Oh-V1G0-Rally/Omnicar_Control_Ros2/[00] Documentation/Thesis_Alessandro/Frontespizio_TM.pdf

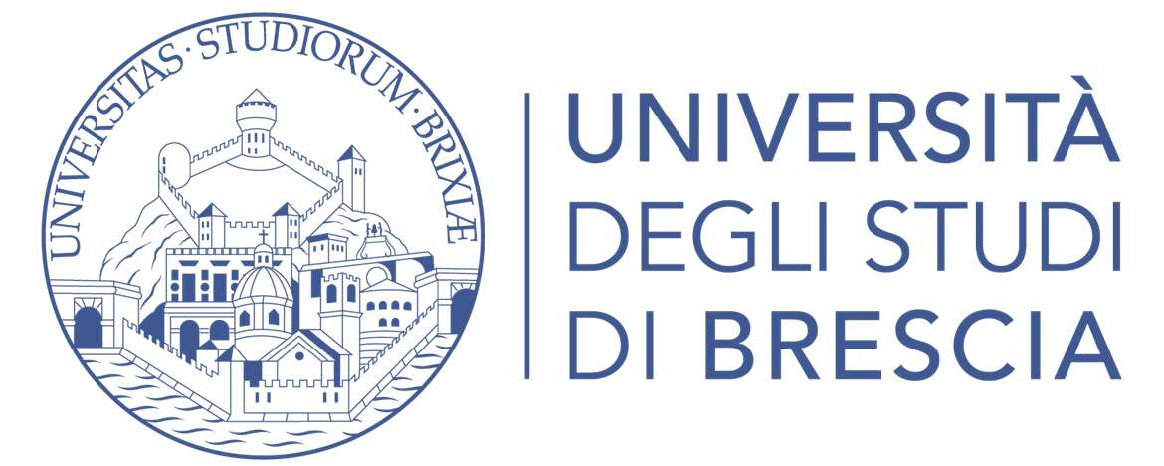
[picture p52: figure]

DIPARTIMENTO DI INGEGNERIA MECCANICA E INDUSTRIALE CORSO DI LAUREA IN INGEGNERIA DELL’AUTOMAZIONE INDUSTRIALE

## Assembly, Design and Implementation of Nonlinear Motion Control Algorithms for a Robotic Car

Relatore:
Antonio Visioli

Laureando:
Alessandro Vigorelli Matr. 735847

ANNO ACCADEMICO 2025-2026
