Oh-V1G0-Rally/Omnicar_Control_Ros2/[00] Documentation/MR_Assignment3-1.pdf

# Mobile Robotics - Assignment 3

Jo˜ao Martins, Jos´e Carvalho, Louren¸co Pinho and Maria Lopes

Once the low-level controller is complete, mobile robots can be deployed to perform various tasks that require planar movement. In such scenarios, a high-level controller is essential for planning and executing the robot’s path. This assignment presents the formulation of multiple controllers designed for different types of common movements, such as following linear trajectories and curves. Additionally, an infrared sensor has been integrated into the system to enable a trajectory-following feature.

## 1 Kinodynamic Model

The robot used in this work will be a differential wheeled robot with two actuators in the form of motors. A typical example of such a robot can be visualized in Figure 1.

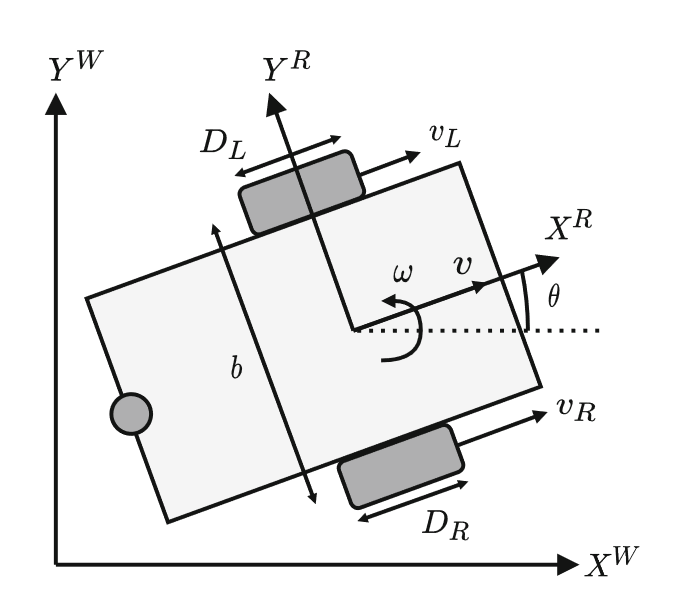
[picture p72: figure]

Figure 1: Example of Differential Wheeled Robot

The robot kinematics are nonlinear and have non-holonomic motion constraints, meaning that the 3 degrees of freedom (x, y, θ) are not decoupled from one another. The forward kinematics can be written as:

x˙
y˙
˙θ
- =

cos θ 0
sin θ | 0
0 | 1
| | {z | }
| J
v
ω
(1)

where v is the linear velocity on the robot’s inertial frame, and ω is its angular velocity. These velocities can be related to the velocity of each wheel through the following equation:
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
| {z }
W
v
ω
(2)

in which b is the robot’s width, vL, and vR are the velocities of the left and right wheels, respectively. The wheels’ angular speeds are calculated using the relation with the wheel radius r:

ωw =

v
r

(3)

and the subscript w will be used whenever referring to a generic wheel.
Considering that the motors operate outside their deadzone, the dynamical model can be approxi-mated as a linear model with two poles. After performing system identification on the system, it was concluded that the pole associated with the electrical current is much smaller than the mechanical pole, and therefore, to simplify the model, it will be ignored. Thus, the motors will be described by a first-order model with the following transfer function on the Laplace domain:

G(s) = W(s)
U(s)

=

A
τs + 1
, | (4)

where A is the transfer function gain, τ is the system’s open-loop time constant, and U(s) is the voltage signal or the control variable.
The goal of a generic closed-loop controller H(s) will be to make it so that the system tracks the reference signal R(s). In this section, we will simplify the controller synthesis by considering a generic controller that imposes the closed-loop dynamics described by:

1
τ

′s + 1

, | (5)

Which is a unitary-gain first-order system with a time constant τ

′
. Considering that there is no wheel slippage or actuator saturation, robot velocities v, ω also follow the closed-loop dynamics of Equation 5, and thus the model can be extended as:

x˙
y˙
˙θ
v˙
ω˙

=

0 0 0 cos θ | 0
0 0 0 | 0 | sin θ
0 0 0 | 0 | 1
0 0 0 | −1 τ
| ′ | 0
0 0 0 | 0 | −1 τ ′

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
′ | 0
0

1
τ

′

# vref

ωref
, | (6)

where vref , ωref are the reference velocity values that are given to the low-level controller. From these reference velocities, the individual wheel speeds can be computed by equation Equation 2. This model allows us to consider the wheel acceleration dynamics instead of just the kinematic constraints.

In this document, the design control architecture for the motion control of the robot will be explored. The control system was divided into two main blocks: a low-level and a high-level controller. The high-level block will be responsible for the path following control by receiving the robot’s pose and orientation and computing reference velocities handled by the low-level controller. This framework can be visualized in Figure 2. It is important to note that the low-level controller and the state estimation were already addressed in previous reports. Therefore, the main focus will be on the high-level controller block, which will have multiple types of movements defined, all described in the sections below.

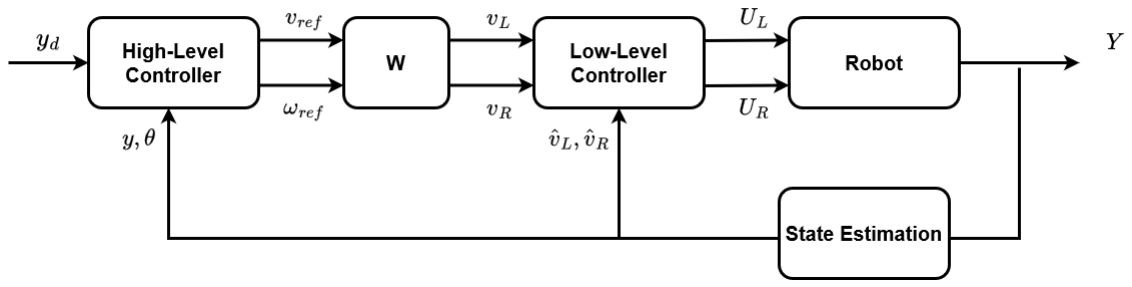
[picture p73: figure]

Figure 2: Proposed Controller Architecture.

## 2 SetTheta

Consider a robot described by the given forward kinematics. Let θ(t) be the robot’s orientation and θd ∈ [−

π
2

,

π
2

] be a given desired orientation as represented in Figure 3. Design a feedback control law such that all the relevant closed-loop signals are bounded, and the regulation error (θ − θd) = ˜θ converges to zero as t → ∞.

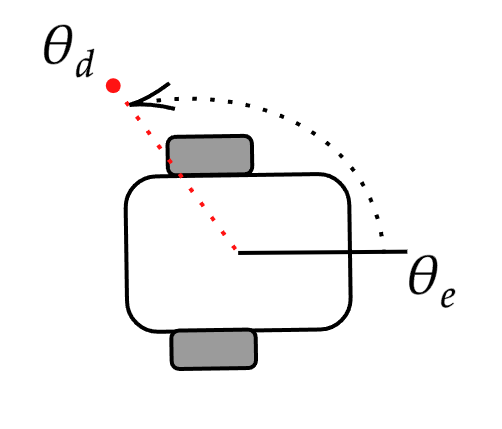
[picture p74: figure]

Figure 3: Set theta diagram

Since this is an orientation problem, the desired linear velocity, vd, is defined as:

vd = 0

Then the desired angular velocity ωd is computed by the control law:

ωd =

ωnomsgn(˜θ) if |

˜θ| >
π
2

ωnom ·

˜θ ·

2
π

if |

˜θ| <
π
2
Where the sgn operator enables the controller to move in the direction of the smallest rotation. Additionally, if |

˜θ| < 0.01:
ωd = 0

end traj = true

## 3 GotoXY

Consider a robot described by the given forward kinematics. Let p(t) be the robot’s pose and pd ∈ R

2
,
defined by pd =(xd, yd), be a given desired point as illustrated in Figure 4. Design a feedback control law such that all the relevant closed-loop signals are bounded, and the regulation error ∥p(t)−pd∥ = ˜p converges to zero as t → ∞.
In this scenario, the following relations can be retrieved:

θd = atan2(yd − ye, xd − xe) ˜θ = θd − θe

p˜ = ∥p(t) − pd∥ =

p
(xe − xd)

2 + (ye − yd)

2
where ˜p is the pose error and ˜θ is the orientation error. Then the desired angular velocity ωd is computed as:
ωd = kθ

˜θ

The desired linear velocity vd based on the following conditions:

vd =

(
0 | if |

˜θ| >
π
2
vnom · cos(˜θ) · min (1, kpp˜) if |

˜θ| ≤ π

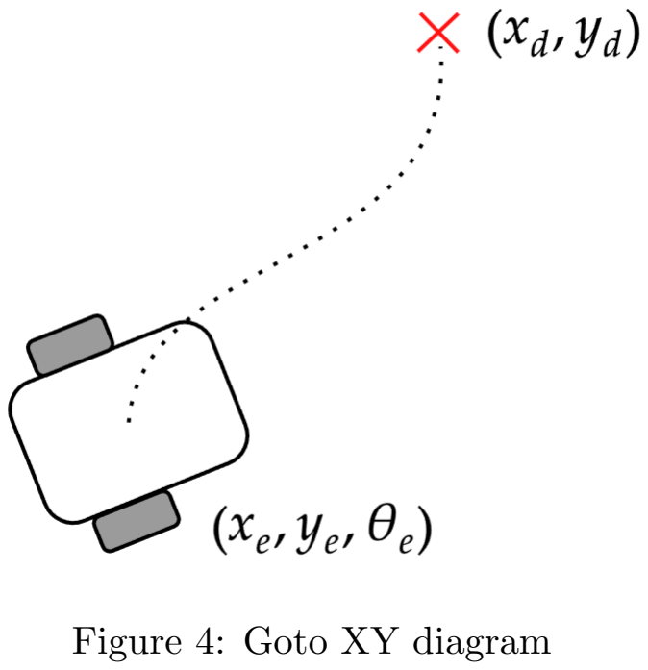
[picture p75: figure]
Figure 4: Goto XY diagram

Here, the cos(˜θ) term enables the robot to regulate its linear velocity if the angular error is large and the min(1, kpp˜) switches between applying the nominal velocity or implementing a proportional controller if the error is small enough. This effectively serves to give the robot a smoother deceleration. Additionally, if |p˜| < 0.01:
vd = 0

ωd = 0

end traj = true

With kθ and kp being the proportional gains defined as follows:

kθ =

ωnom

π
2

, kp =

1
λ

, λ = 0.2

## 4 Follow Line

Consider the line segment that begins at the point (xi

, yi) and ends at (xf , yf ) ∈ R

2
. Then, let this
path be parameterized by the function γ(p(t)) : R

2 → R

2
, which, given the robot’s pose, returns the point (xl

, yl) in the path at the smallest euclidean distance, ˜l, as represented in Figure 5. Thus, the goal is to formulate a closed-loop control law so that all signals are bounded and the regulation error ∥p(t) − γ(p(t))∥ tends to zero as t → ∞.

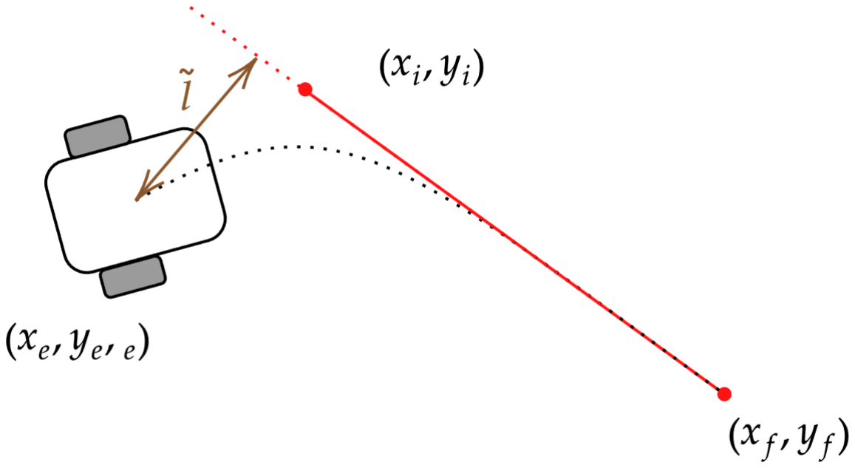
[picture p76: figure]

Figure 5: Follow line diagram

In this case, the relations retrieved are the following:

θd = atan2(yf − ye, xf − xe)

˜θ = θd − θe

p˜ =

q
(xe − xf )

2 + (ye − yf )

The error to the line, ˜l, can be computed with:
(
ux =

xf −xi
||xf −xi||2
uy =

yf −yi
||yf −yi||2
(
vx = xe − xi
vy = ye − yi

˜l = vx · uy − vy · ux

Let ˜l be the distance from the robot’s pose p(t) to the line segment, ˜θ = (θd − θ) be the orientation error and ky, kθ be two proportional gains. Then, one can derive a control law for the orientation that will drive the robot to follow the line:

ωd = ky

˜l + kθ
˜θ

Finally, consider the pose error defined as ˜p(t) = ∥p(t) − (xf , yf )∥ the distance from the robot’s pose to the end of the line, and kp a proportional gain. Thus, we can determine the desired linear velocity vd based on the following control law:

vd =

(
0 | if |

˜θ| >
π
2
vnom · cos(˜θ) · min (1, kpp˜) if |

˜θ| ≤ π
2
Additionally, if |p˜| < 0.01: vd = 0
ωd = 0
end traj = true

### 4.1 Adaptative Gains

Consider the dynamic model presented by the forward kinematics given by equation Equation 1. We are interested in following only straight lines, which, without loss of generality, can be described as the line y = 0 in an arbitrary reference frame. Thus, since the problem is path-following and not trajectory tracking, the state x can be ignored as we are only concerned with following the geometric path. Furthermore, due to y = 0, the orientation of the line is also θ = 0, and as such, our model can be linearized via small angle approximation:
y˙
˙θ
=
0 v(t)
0 | 0
| | {z | }
| A
y
θ
+
0
1

|{z}
B
ω | (7)

where we consider that the velocity v is not a control variable and instead is a time-varying parameter of the model. Then, we can derive a full-state feedback controller:
y˙
˙θ
=
0 v(t)

0 0 y θ

−
0
1

ky kθ

y
θ
(8)

which results in the closed-loop eigenvalues being computed as:

0 | v(t)
−ky | −kθ

= s

2 + skθ + kyv(t) = 0 ↔

s =

−kθ ±

p
k

2
θ − 4kyv(t)
2

(9)

and we will choose to have the imaginary part to be equal to zero, resulting in the expression for ky being:

ky =

k

2
θ
4v(t)

(10)

where the value of the real part is equal to −kθ , and as such we choose where to place the pole.

## 5 Follow Circle

Consider the circle that begins is centered at the point (cx, cy) and has a radius r. Then, let this path be parameterized by the function γ(p(t)) : R

2 → R

2
, which given the robot’s pose, returns the point (xc, yc) in the path at the smallest euclidean distance. Thus, the goal is to formulate a closed-loop control law so that all signals are bounded and the regulation error ∥p(t) − γ(p(t))∥ tends to zero as t → ∞. This problem is illustrated in Figure 6.

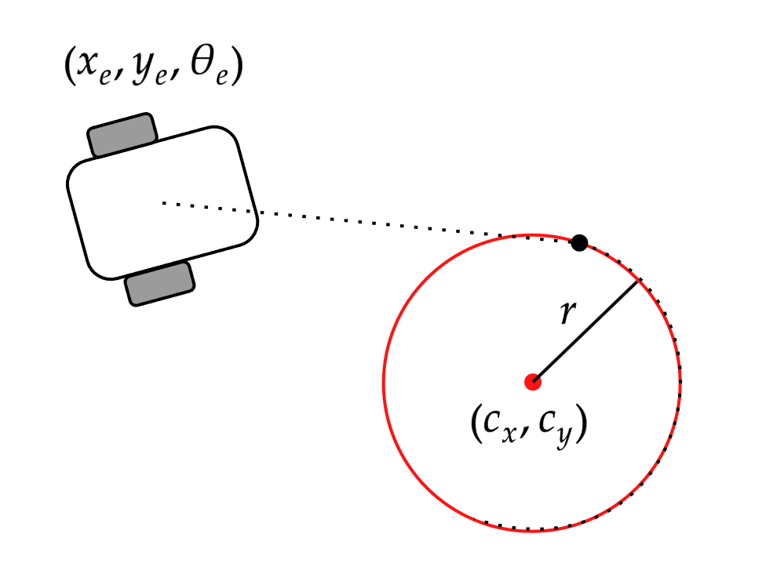
[picture p77: figure]

Figure 6: Follow circle diagram

Three distinct phases were used to solve the follow circle controller problem. The first one is a calculation of the best point to enter the circle; the second is the approximation to it using the GotoXY controller, where the robot converges to a point for better entering the circle without having to stop and rotate due to the differential wheel drive configuration. Then, upon being close enough, it enters the third and final phase of following the circle. This procedure is illustrated in Figure 7, along with the equations used to calculate the references in each phase.

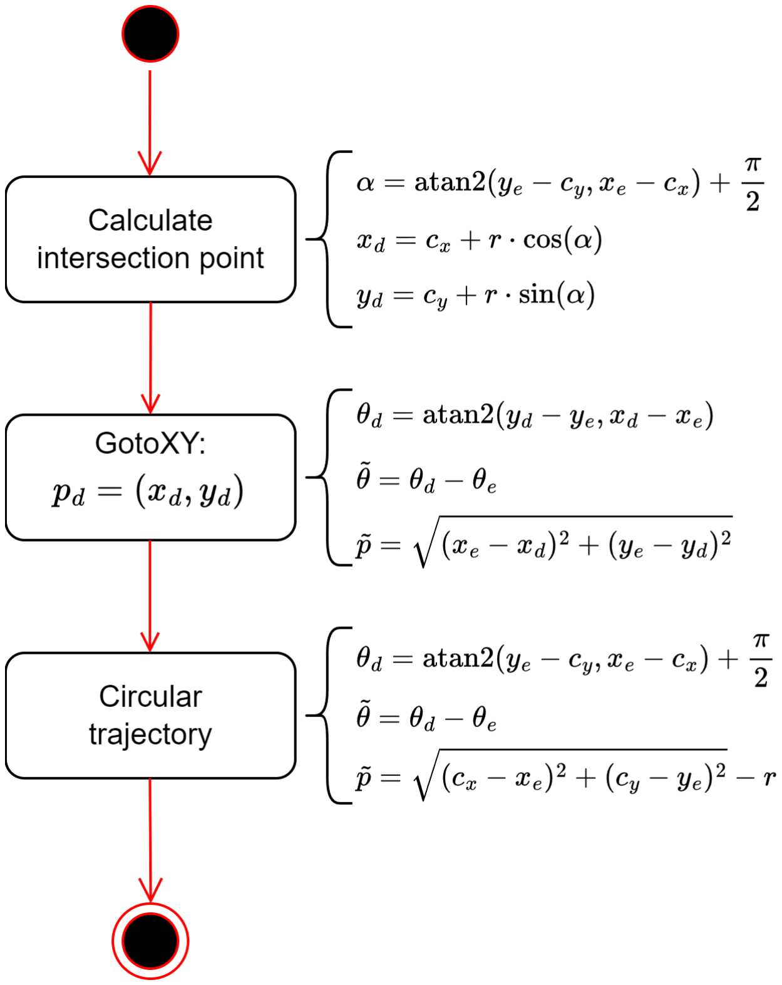
[picture p78: figure]

Figure 7: Follow circle state machine

Remember the proposed follow-line controller. If we consider that ˜c = ∥p(t)−γ(p(t))∥ is an error in the form of the distance from the robot’s pose to the closest point in the circle and θd is the orientation of the line tangent to that point; then the proposed line controller will follow the circle path with the caveat of existence of a steady-state error due to ˙θd ̸= 0. This can be mitigated by adding a feedforward term to the controller:

ωd = kcc˜+ kθ

˜θ +

vd
r
Where vd can be calculated the same way as in the line following case. For a continuous follow circle case, vd is defined as vnom.

## 6 Path Follower using IR Sensor

Consider the robot described by the given forward kinematics. Let it travel at a constant linear velocity vd, and let β˜ ∈ R be the displacement of the front robot in relation to the desired path. Design a feedback control law such that all relevant closed-loop signals are bounded and the regulation error β˜ converges to zero as t → ∞.
Remember the proposed controller, GotoXY. For the case where IR sensors are used, a simpler version can be implemented:

vd = vnom
wd = kββ˜

where kβ is a constant that relates the raw measurements from the IR sensors and the angular error, and β˜ = k ·

˜θ as the IR sensors do not provide the angle error directly. β˜ can be calculated from the IR raw values as follows:

β˜ =

4 · IR4 + 2 · IR3 − 2 · IR1 − 4 · IR0 1024

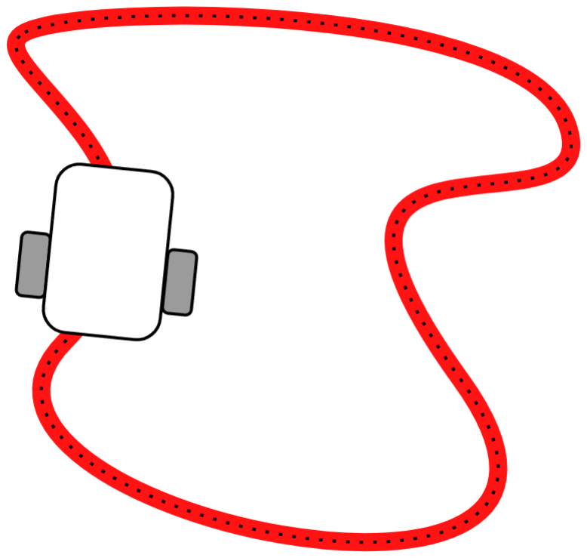
[picture p79: figure]

Figure 8: Path following diagram

## 7 Conclusions

The main conclusions of this work and the Mobile Robotics course from PDEEC are implementing a full framework from the low level to the higher level control of a differential kinematics robot. In previous reports, we explained the motor control and determined the intrinsic parameters. This one focused instead on the higher-level trajectories, from a simple setTheta controller to GotoXY, FollowLine, and FollowCircle.
