Oh-V1G0-Rally/Omnicar_Control_Ros2/[00] Documentation/Nonlinear_Control___PDEEC-2.pdf

# Controller Synthesis for High-Speed Differential Wheeled Robot

1

st Jose Pedro Carvalho ´
Department of Electrical and Computer Engineering Faculdade de Engenharia da Universidade do Porto Porto, Portugal
jpcarvalho@fe.up.pt

2

nd Antonio Pedro Aguiar ´
Department of Electrical and Computer Engineering Faculdade de Engenharia da Universidade do Porto Porto, Portugal
pedro.aguiar@fe.up.pt

Abstract—This document is the final report of the Non Linear Control Course at PDEEC.

I. INTRODUCTION
The rest of the document is structured as follows: Section II formulates the path following problem and derives two kinodymic models for the differential wheeled robot. Section III explores the design and synthesis of Proportinal Integral and Derivative (PID) and Model Reference Adpative Control (MRAC) controllers for the wheel’s velocity. Subsquently Section IV formulates four different path-following controllers based on: Linear Quadratic Regulator, Sliding Mode Control, Non Linear Control, Proximal Policy Optimization, giving design choices for each of the approach. This is followed by Section V with the results of both the low-level controller and the high-level controller and finally in Section VI the main conclusions and future work are presented.

II. PROBLEM FORMULATION
In this section, we will formulate the class of path-following problems that will be considered in this paper. First, we will consider a framework where a mobile robot is modeled by a continuous-time dynamical system of the form:

x˙(t) = f(x(t), u(t)), x(0) = x0 y(t) = h(x(t)),

(1)

where the vector x(t) ∈ R

n denotes the state, x0 the initial condition, u(t) ∈ R

n the input control signal, and y(t) ∈ R

q
the output signal that will typically correspond to the robot’s pose in respect to an inertial coordinate frame.
We are interested in the class of problems where a robot described by the system in equation (1) must follow a geometric path yd(γ) : R → R

q parameterized by γ ∈ R and vd ∈ R is the desired speed assignment. As such, the goal of the path-following problem is to design a feedback control law such that all relevant closed-loop signals are bounded and the path-following error ∥y(t) − yd(γ(t))∥ converges to zero as t → ∞, and the parameter γ satisfies the speed assignment γ˙ → vd as t → ∞.
In this document, we will address only the case where the path is a straight line, and as such, γ(t) = ¯x(t), ∀t, where x¯

Identify applicable funding agency here. If none, delete this.

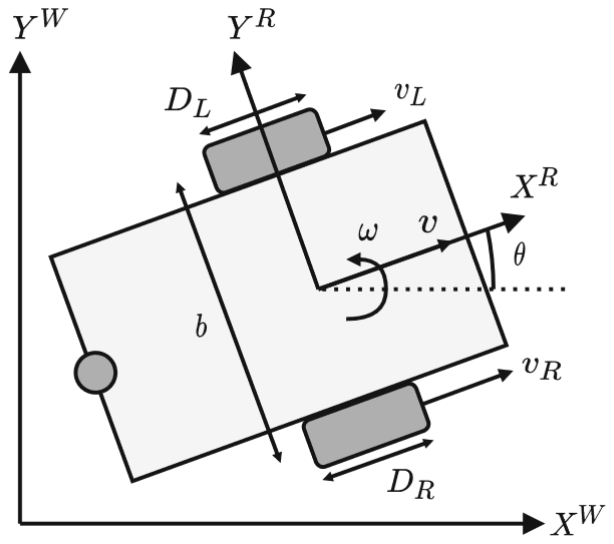
[picture p80: figure]

Fig. 1: Example of Differential Wheeled Robot [?]

is the x coordinate of the robot on the global frame, and thus yd(¯x(t)) = [¯x, 0]T
, meaning that the robot will always follow the line corresponding to the x-axis y = 0.
A. Robot Kinodynamic Model

The robot used in this work will be a differential wheeled robot with two actuators in the form of motors. A typical example of such a robot can be visualized in Figure 1.
The robot kinematics are nonlinear and have non-holonomic motion constraints, meaning that the 3 degrees of freedom (x, y, θ) are not decoupled from one another. The forward kinematics can be written as:

x˙
y˙
˙θ
- =

cos θ 0
sin θ | 0
0 | 1
| | {z | }
| J
v
ω
(2)

where v is the linear velocity on the robot inertial frame, and ω is its angular velocity. These velocities can be related to the wheel velocities through the inverse kinematics:
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
| {z }
W
v
ω
(3)

in which b is the robots’ width, vL, and vR are the velocities of the left and right wheels, respectively. The wheels’ angular speeds are calculated by the relation with the wheel radius r:

ωw =

v
r
, | (4)

and the subscript w will be used whenever referring to a generic wheel. Considering that the motors operate outside their deadzone, the dynamical model can be approximated as a linear model with two poles. After performing system identification on the system, it was concluded that the pole associated with the electrical current is much smaller than the mechanical pole, and therefore, to simplify the model, it will be ignored. Thus, the motors will be described by a first-order model with the following transfer function on the Laplace domain:
G(s) = W(s)
U(s)

=

A
τs + 1
, | (5)

where A is the transfer function gain, τ is the system’s openloop time constant and U(s) is the voltage signal, or the control variable.
The goal of a generic closed-loop controller H(s) will be to make it so that the system tracks the reference signal R(s). In this section, we will simplify the controller synthesis by considering a generic controller that imposes the closed-loop dynamics described by:
1
τ

′s + 1

, | (6)

Which is a unitary-gain first-order system with a time constant τ

′
. Considering that there is no wheel slippage or actuator saturation, robot velocities v, ω also follow the closed-loop dynamics of equation (6), and thus the model can be extended as:

x˙
y˙
˙θ
v˙
ω˙

=

0 0 0 cos θ | 0
0 0 0 | 0 | sin θ
0 0 0 | 0 | 1
0 0 0 | −1 τ
| ′ | 0
0 0 0 | 0 | −1 τ ′

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
′ | 0
0

1
τ

′

# vref

ωref
,

(7)
where vref , ωref are the reference velocity values that are given to the lower-level control. From these reference velocities, the individual wheel speeds can be computed by equation (3). This model allows us to consider the wheel acceleration dynamics instead of just the kinematic constraints.

III. CONTROL SYSTEM DESIGN
In this section, we will explore the design control architecture for the motion control of the robot. In this paper, we will divide the control system into two main blocks: a low-level and a high-level controller. The high-level block will

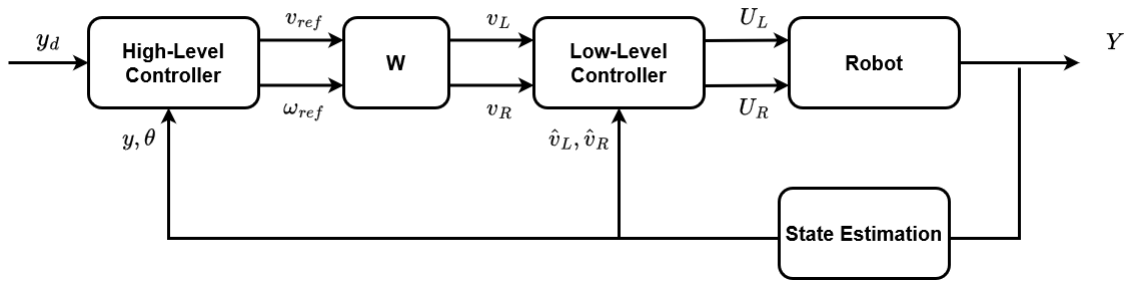
[picture p81: figure]

Fig. 2: Proposed Controller Architecture.

be responsible for the path following control by receiving the robot’s pose and orientation and computing reference velocities handled by the low-level controller. This framework can be visualized in Figure 2.

A. Low-Level Controller

The low-level controller is responsible for controlling the wheel velocities so that the robot can achieve its desired speed.
1) Proportional Integral Controller: Consider the openloop plant given by equation (5) and the let controller H(s) be a PI controller described by equation:

H(s) = kc

1 +

1
sTi
= kc

Tis + 1
sTi
, | (8)

where kc is the proportional gain and Ti
is the integral time
constant. The first design choice of the controller is to choose Ti = τ , making the zero of the controller cancel the pole of the plant:

G(s)H(s) = kc

✘sT✘✘i + 1
sTi

A
✘τs✘+ 1✘ =

kcA
sτ
. | (9)

Therefore, the closed-loop transfer can be derived as:

G(s)H(s)
1 + G(s)H(s)

=

1
s

τ
kcA + 1

(10)

This results once again in a first-order system, this time with unitary gain, as the system tracks any input. The only remaining parameter to choose is the closed-loop time constant τ

′
, as this value will dictate how fast the control system can respond to changes in the reference signal. Then, the time constant of the closed-loop system is equal to:

τ

′ =

τ
kcA
, | (11)

thus, the controller can be adequately tuned. Additionally, we can add a Feedforward signal F(s) to the controller by inverting the plant:

F(s) = 1
G(s)

=

1
A

+

sτ
A
= kf + kds | (12)

and we will consider kd to be equal to zero to keep the transfer function proper, and kf will be λ

1
A where λ ∈ [0, 1].

2) Model Reference Adaptive Controller: : Consider now that the motor model has parametric uncertainty and is described by the differential equation:
x˙ = ax + b(u − f(x)) | (13)

where a, b are unknown parameters and f(x) is an uncertain nonlinear function

f(x) = θ

T ϕ(x), | (14)

with θ = [θ1, θ2]

T being a vector of unknown parameters and ϕ(x) = [1, ω²
w]

T
a vector of known basis function. The goal of the Model Reference Adaptive Controller (MRAC) is to make the system described by equation (13) track a reference model given by:
x˙ m = amxm + bmr | (15)

such that the tracking error e(t) = x(t)−xm(t) = 0 as t → ∞. To this end, let the control law be:

u = ˆkxx + ˆkrr + ˆθ
T ϕ(x), | (16)

and the adaptive law be:
˙ˆkx = −eγxsgn(b)
˙ˆkr = −eγrsgn(b) ˙ˆθ = −eΓθsgn(b) | (17)

that will update the parameters ˆkx,

ˆkr,

ˆθ such that the closed-loop dynamics:

x˙ = (a + b

ˆkx)x + b(
ˆkrr + (ˆθ − θ)
T ϕ(x)) (18)

match the reference model of equation (15).

IV. HIGH-LEVEL CONTROLLER
This section explores and describes various possibilities of high-level controllers for the path-following problem.
A. Linear Controller
Consider the dynamic model presented by the forward kinematics given by equation (2). We are interested in following only straight lines, which, without loss of generality, can be described as the line y = 0 in an arbitrary reference frame. Thus, since the problem is path-following and not trajectory tracking, the state x can be ignored as we are only concerned with following the geometric path. Furthermore, due to y = 0, the orientation of the line is also θ = 0, and as such, our model can be linearized via small angle approximation:
y˙
˙θ
=
0 v(t)
0 | 0
| | {z | }
| A
y
θ
+
0
1

|{z}
B
ω | (19)

where we consider that the velocity v is not a control variable and instead is a time-varying parameter of the model. Then, we can derive a full-state feedback controller:
y˙
˙θ
=
0 v(t)

0 0 y θ

−
0
1

ky kθ

y
θ
(20)

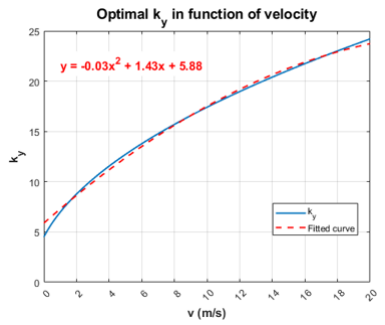
[picture p82: figure]

Fig. 3: Linear Regression of the values ky

which results in the closed-loop eigenvalues being computed as:
0 | v(t)
−ky | −kθ

= s

2 + skθ + kyv(t) = 0 ↔

s =

−kθ ±

p
k

2
θ − 4kyv(t)
2

(21)

and we will choose to have the imaginary part to be equal to zero, resulting in the expression for ky being:

ky =

k

2
θ
4v(t)

(22)

where the value of the real part is equal to −kθ
2

, and as such
we choose where to place the pole.
B. Linear Quadratic Regulator
Another option to formulate the linear control is through the optimal control lens. Let the system be described by the state-space model of equation (19) and let Q, R ∈ R

2
are positive-definitive cost matrices. Then we can define the infinite-horizon Linear Quadratic Regulator (LQR) as:

min J =

Z +∞

0

(x

T Qx + u

T Ru)dt | (23)

with the closed-form solution being:

J = x

T P x | (24)

where P ∈ R

2
can be obtained by solving the continuous algebraic Ricatti equation:

A

T P + P A − P BR⁻¹B
T P + Q = 0, | (25)

and the feedback gains are obtained by:

[ky, kθ] = R

−1B
T P. | (26)

Note that the system is Linear Parameter Varying (LPV) model, and as such we would need to solve the Ricatti equation for every possible velocity. To deal with this issue, we compute the gains offline for multiple values of velocity between v ∈ [0, vmax] and perform a linear regression for obtaining an expression for the gains. The results were that the kθ is constant and independent of the velocity whereas ky follows a quadratic curve as seen in Figure 3.

C. Sliding Model Control
Another option for the high-level control is the Sliding Mode Control (SMC) methodology. This subsection we will describe a formulation for a SMC controller. Let the path yd be defined by a function f(x) : R → R. And the derivative at point x

′
is defined as m = f

′
(x

′
). Then, the reference
orientation for the robot can be defined as:
¯θref = arctan(m). | (27)

Furthermore, the distance d from the current robot position (x

′

, y′
) to the path (x

′
, f(x

′
)) is computed as:

d =

f(x

′
) − y

′
√
1 + m² | (28)

Then, assuming the robot is traveling at a velocity v we can generate a θref that moves the robot towards the path:

θref = ¯θref + γ arctan(kd) | (29)

where γ is the gain parameter and k is the parameter that dictates how steep the arctan function is.
This simple model enables the robot to follow the path by only making the robot orientation θ converge to θref . In order to make this possible we design the sliding surface as:
sθ = θ − θref , | (30)

and formulate the control law as:

ω = −βsgn(sθ) | (31)

where β is the actuation effort. Let the Lyapunov function be defined as:
V =

1
2

s

2 θ | (32)

then, the existence of sliding mode is guaranteed as long as V˙ = sθs˙θ < 0. To prove the existence, let the first derivative of the surface be:
s˙θ = ˙θ − ˙θref = −βsgn(sθ) − ˙θref | (33)

which satisfies the sliding mode conditions as long as β < |

˙θref |.

D. Nonlinear Controller
The final option considered from the traditional approaches is a Lyapunov-based nonlinear controller.
To this end, consider the robot described by the dynamical
model in equation (2), let p(t) = [x(t), y(t)]T ∈ R | 2 be the
pose of the robot, R(t) be the rotation matrix from the body frame to the global frame, and [v(t), Ω(ω(t))] ∈ SE(2) is the twist that defines the velocity of the vehicle, linear and angular, where the matrix Ω(ω(t)) is the skew-symmetric matrix associated to the angular velocity ω(t), defined as

Ω(ω) =
0 | −ω
ω | 0
. And in this case, the control input is

defined as:
u(t) = -v(t) u(t)

T
(34)

then we can rewrite the system dynamics as:

p˙ = Rv
R˙ = RΩ

(35)

Suppose that we want to drive the front of robot defined as:

y(t) = p(t) + R(t)ϵ | (36)

where ϵ = [ϵ1, 0] is the distance from the front of to the robot to the center of rotation of the body frame, and now we can define and define the body-fixed path following error:

e(t) = R

T
(t)(y(t) − yd(γ(t))). | (37)

As the goal of the path-following problem is to make the error e(t) → 0 as t → ∞, we propose the candidate Lyapunov Function V =

1/2 eeT
. Let the time-derivative of the error be defined as:

e˙ = −Ωe + ∆u − R

T ∂yd
∂γ γ˙ | (38)

can formulate the control law as follows:

u(t) = ∆⁻¹
(R

T ∂yd
∂γ vd − Ke)

where ∆ =
0 ϵ1

0 0
, γ˙ = vd and K is the feedback gain. It

follows that the derivative of the Lyapunov function is:

| V˙ = e
′
e˙
= −e

T Ωe − e

T Ke

(39)

where e

T Ωe = 0, ∀e beacause Ω is a skew-symmetric matrix and e

T Ke < 0 , thus e = 0 is an exponentially stable equilibrium point.

E. Proximal Policy Optimization

The final option for the high-level controller is to use Reinforcement Learning Methods, in this case Proximal Policy Optimization which is very versatile actor-critic method. To this end, we must formulate the path-following problem as a Markov Decision Process (MDP).
A MDP can be defined by a tuple (S, A, P, R, γ), where S is the set that contains all the possible states s, and A is the state that contains all the actions a on the action space; P : S × A → S is the state transition probability function, R : S × A × S → R is the reward function, mapping the state transitions into a scalar reward; The discount factor γ ∈ [0, 1] changes the weight given to future rewards.

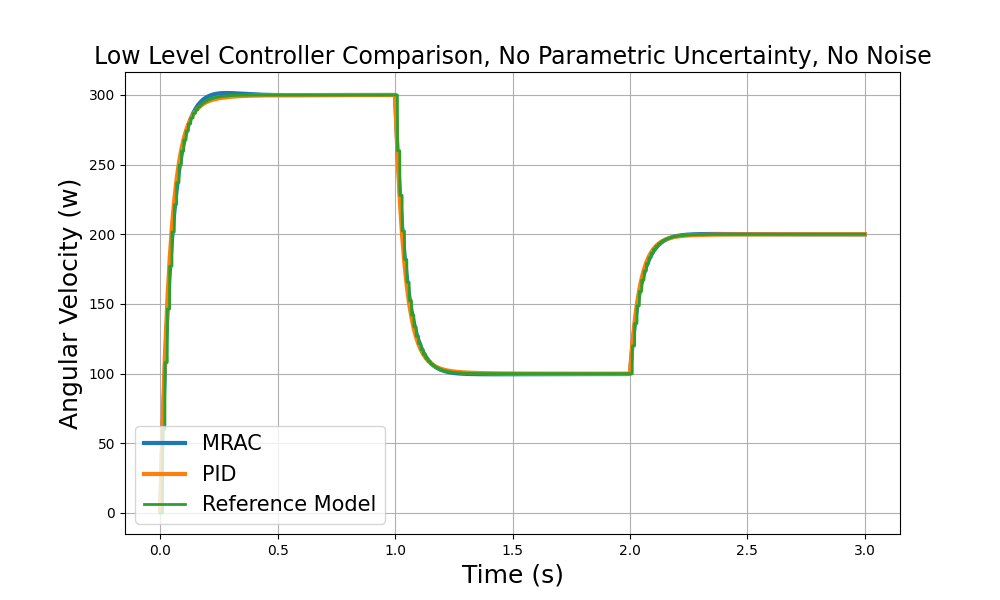
[picture p83: figure]

(a) No Parametric Uncertainty and No Measurement Noise.

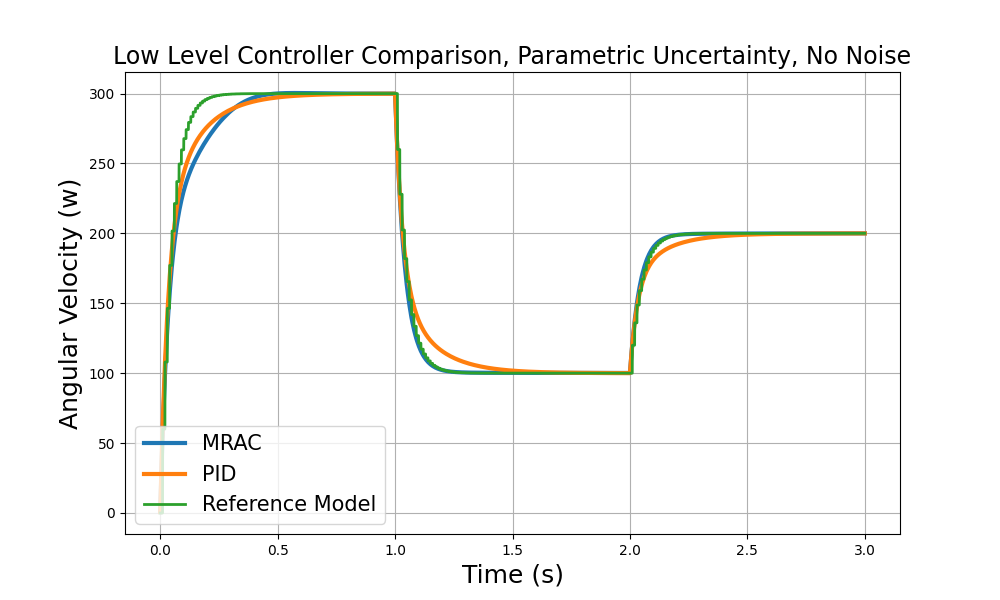
[picture p84: figure]

(b) Parametric Uncertainty and No Measurement Noise.

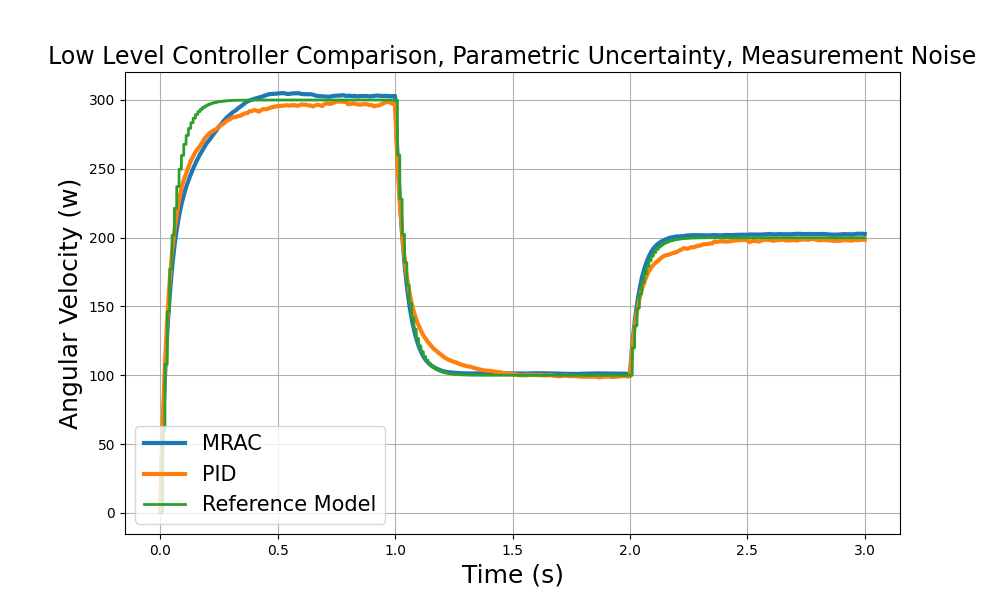
[picture p85: figure]

(c) Parametric Uncertainty and Measurement Noise.

Fig. 4: Software in The Loop Results for Low-Level Controller

1) State Space: For the case of path following we will consider the state space to be the tuple defined by the tuple:

S = R

3×n
| {z }
x¯

× R

2×n
| {z }
u

× R

2×n
| {z }
yd
, | (40)

where x¯ = [x, y, θ]

T
corresponds to the vector containing both the robot’s pose and orientation, u = [v, ω]

T
is the robot linear
and angular velocities and yd = [yref , θref ] corresponds to the path. In addition, we perform frame stacking by giving the n most recent values for each variable.
2) Action Space: As in most previous approaches, we will consider that the robot’s linear velocity is not handled by the high-level controller directly and instead is a function of time v(t). Then, the only control variable is the angular velocity ω(t) and, as such the action space is described as:
A = [−1, 1] | (41)

and the angular velocity ω is a function of action a:

| ωt = λat | | | (42)

where λ is an hyperparameter that scales the value of the action to the desired angular velocity. This is particularly useful as policy gradient algorithms work specifically well when the action space is symmetric and centered in zero, as the policy generally approximates a probability distribution function with the same conditions.
3) Reward: The reward function is set so that the value function resembles the LQR cost function. This design choice is due to the fact that the LQR cost function describes the basic goal of the path-following problem; the quadratic cost function is a natural and easier function to approximate, and it is proven that reinforcement learning algorithms can learn

TABLE I: Mean Square Error (ω

| | 2
) from the Low-Level
Controller Tests. The Columns marked with † are the results from t > 1, i.e., after the MRAC gains converge.
| MRAC | PID | MRAC† | PID†
No Noise, No Uncertainty | 2.80 | 1.6 | 0.78 | 0.45
No Noise, Uncertainty | 239.00 | 113.43 | 0.42 | 31.53
Noise and Uncertainty | 230.14 | 149.13 | 3.45 | 30.86

the value function in a finite number of samples. Thus, the reward function is described as:

R(s, a, s)

′ = −(e
T

t Qet + Rω²
t
| | | ) | (43)

where et = [yd − y, θd − θ] is the path following error, Q ∈ R

2
is a positive definite matrix, and R is a real positive number. Note that unlike LQR, where the problem is posed as a minimization problem, in the RL framework, the problem is posed as a maximization of the expected reward, so we change the sign of the reward.
V. SIMULATION RESULTS

To validate the proposed architecture, the system is implemented in software. This section presents the main simulation results, first comparing low-level and high-level controllers.

A. Motor Control

To test the efficacy of the low-level controllers, we perform software in the loop tests where the motors are subjected to a series of step references. The tests have three different scenarios, one where the simulated motor’s model and the identified model used to tune the controllers are the same. The second scenario introduces parametric uncertainty of up to 25% both in the gain and time constant and in the final scenario, alongside the uncertainty, we also introduce measurement noise in the formal of a normal distribution N (0.01ω, 0.01ω). The results can be visualized in Figure 4, and the Mean Square Tracking Error (MSE) for each scenario is presented in Table I. Note that the MRAC gains were initialized with the matching condition from the identified model.
From the results, it is possible to infer that if the simulation model matches the identified model, both controllers match almost perfectly the ideal reference model. In the case where

TABLE II: Mean Absolute Error (|y|) from the Low-Level Controller Tests.

| Linear | SMC | NLC | PPO
No Noise, No Uncertainty | 0.0113 | 0.0106 | 0.0025 | 0.0078
No Noise, Uncertainty | 0.0118 | 0.0102 | 0.0027 | 0.0084
Noise and Uncertainty | 0.0155 | 0.0146 | 0.00884 | 0.0224

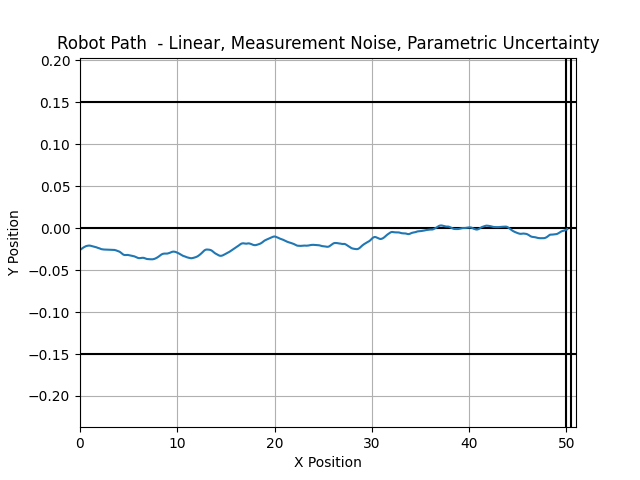
[picture p86: figure]
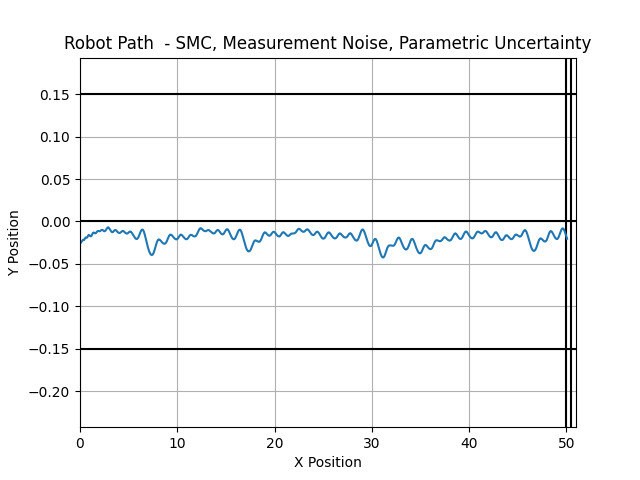
[picture p87: figure]
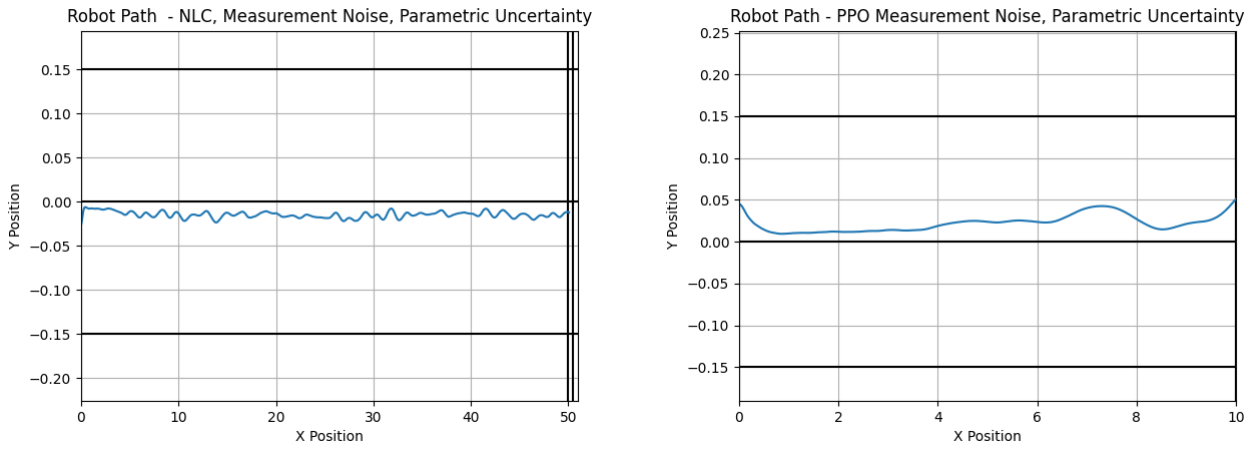
[picture p88: figure]

(a) Linear | (b) Sliding Mode Control | (c) Non-Linear Controller | (d) PPO

Fig. 5: Software in The Loop Results for Path Following Controller

parametric uncertainties are introduced, the performance significantly degrades as the closed-loop system is much slower than the reference model. However, after the first step reference, the MRAC parameters converge, and the controller matches the reference model again, unlike PID, whose poor performance is consistent in the subsequent changes in the reference signal. Finally, when measurement noise is included, the controller performance worsens, but both controllers are robust enough to track the reference adequately.

B. Path-Following Control
The final test was to test the path following the controller on a simulation scenario. In this scenario, the robot’s kinematics and motor dynamics are simulated, and actuation limits and state estimation uncertainty are simulated. The path the robot must take is a straight line y = 0 and the initial condition is x0 = 0, y0 = 0.04. The robot’s desired speed is a ramp signal vd(t) = 5t corresponding to an acceleration a = 5m/s²
, and
the control loop runs at 100Hz. Some example paths can be visualized in Figure 5, and the Mean Absolute Error (MAE) for all performed tests can be seen in Table II.
From all the controllers, the one with the best performance in all cases is the Non-Linear Controller (NLC). However, it is possible to see that due to the measurement bias, there exists some steady-state error that the controller can not overcome in the scenario with measurement noise. This issue could be mitigated by adding an integral term to the controller. Both Linear and Sliding Mode Controllers are more robust to the introduction of noise as their performance does not degrade as much, nonetheless in terms of absolute error, both controllers are almost interchangeable, where the main difference is that the linear controller is the one that achieves the most smooth paths. The SMC could be improved by increasing the control loop frequency and by adding a filtering term with the derivative of θref to the sliding surface. The linear controller is at almost its performance limit, however it could be improved by accounting for the poles of the motors in the LQR calculations (instead of using just the kinematics). Finally, PPO achieved some mixed results, while it performed better than all controllers bar NLC without noise, when adding this element it was the controller that degraded the most. The improvements should be on accounting for these noise sources in the training process and improvements on the reward function/state space.

Finally, an interesting result is that for all controllers the performance with and without paremetric uncertainties are similar for controllers. This is a very good result as it shows that the MRAC scheme is working as intended and can successfully overcome the modeling uncertainty.

VI. CONCLUSION
In this paper we explore the development of a path-following framework for high-speed differential robots. First, we explore the kinematics and dynamics for the wheeled robot and give two different kinodynamics models. Then, we divide the path-following framework into two main components: a low-level controller for the control of the motor velocities and then a high-level controller responsible for the path-following. In the low-level controller, we explore the possibility of using PID and Model Reference Adaptive control, and the results validate by options, and it was demonstrated that the MRAC scheme can successfully account for parametric uncertainties in the motor’s model. Finally, we explore four different approaches for the path-following controller: Linear Quadratic Regulator, Sliding Model Control, Non-Linear Controller, and Proximal Policy Optimization. While all controllers were shown to accomplish the task, the non-linear controller performed better. Several improvements can still be made to the framework: addressing the state estimation bias by adding a Kalman Filter and fusing the wheel odometry data with an IMU, improving the existent controllers and exploring more techniques related to the RL component. Furthermore, it is paramount to perform more hardware tests, specifically system identification with Gaussian-Process Regression.
