Oh-V1G0-Rally/Omnicar_Control_Ros2/[00] Documentation/images/PrusaSlicerTime/batteria_cover_e_supporti.png

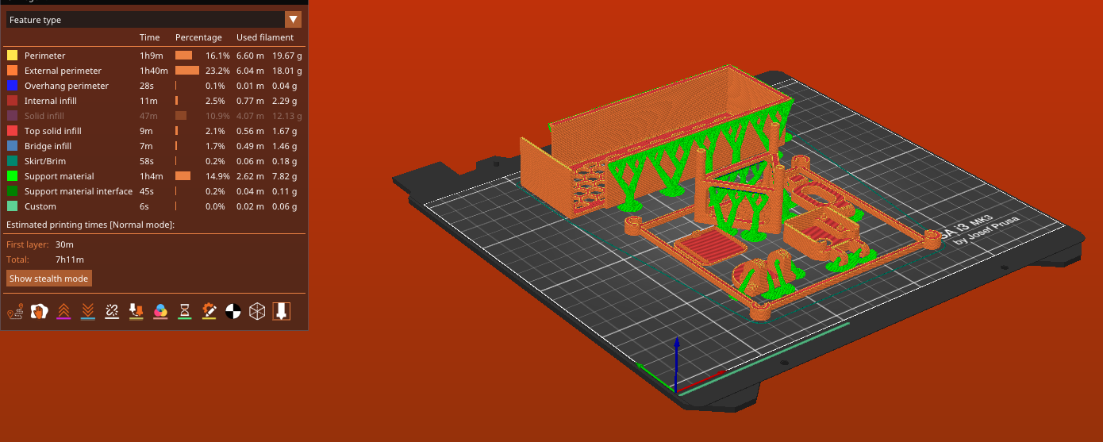
[00] Documentation/images/PrusaSlicerTime/batteria_cover_e_supporti.png
