Oh-V1G0-Rally/Omnicar_Control_Ros2/[00] Documentation/images/PrusaSlicerTime/prusa_stand.png

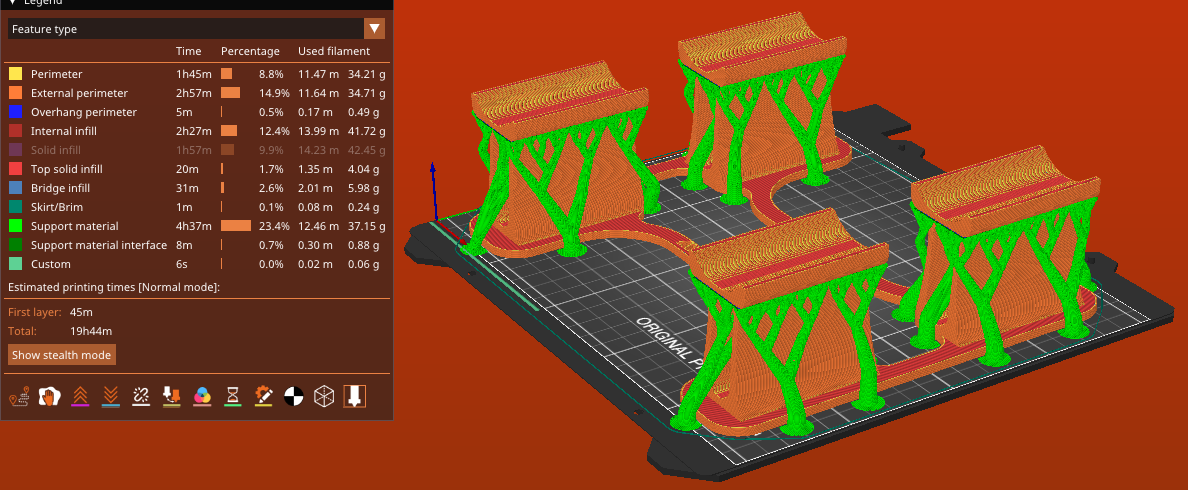
[00] Documentation/images/PrusaSlicerTime/prusa_stand.png
