Oh-V1G0-Rally/Omnicar_Control_Ros2/[00] Documentation/images/Rasp_GoToPoint/rosgraph.png

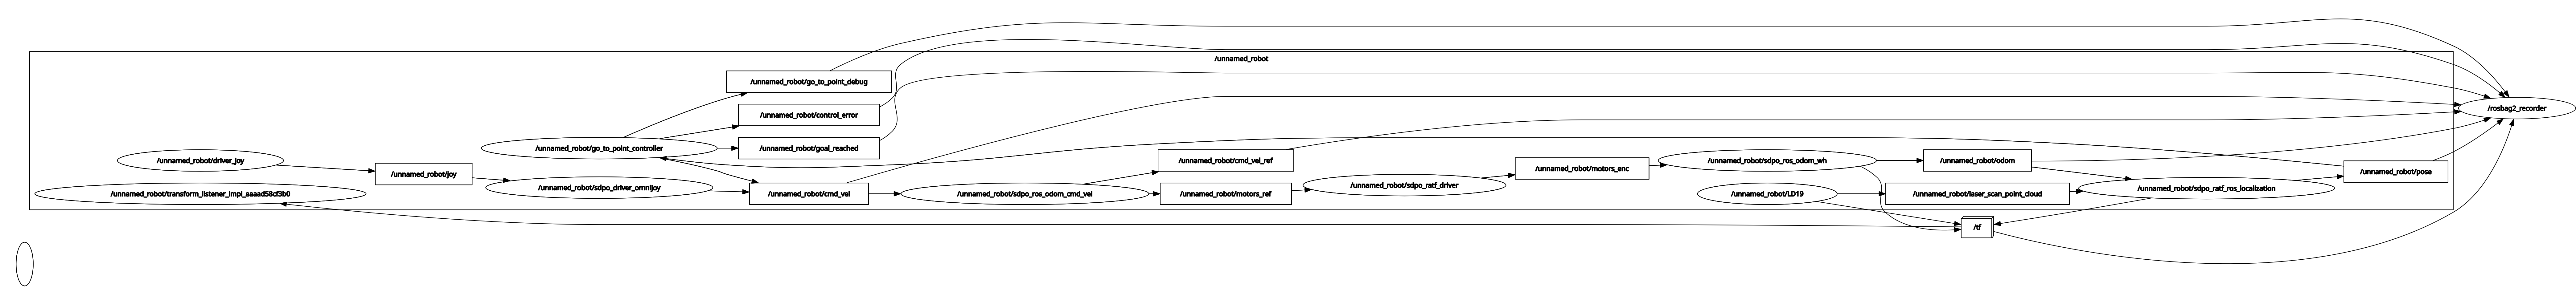
[00] Documentation/images/Rasp_GoToPoint/rosgraph.png
