Oh-V1G0-Rally/Omnicar_Control_Ros2/[00] Documentation/images/Sketch.jpg

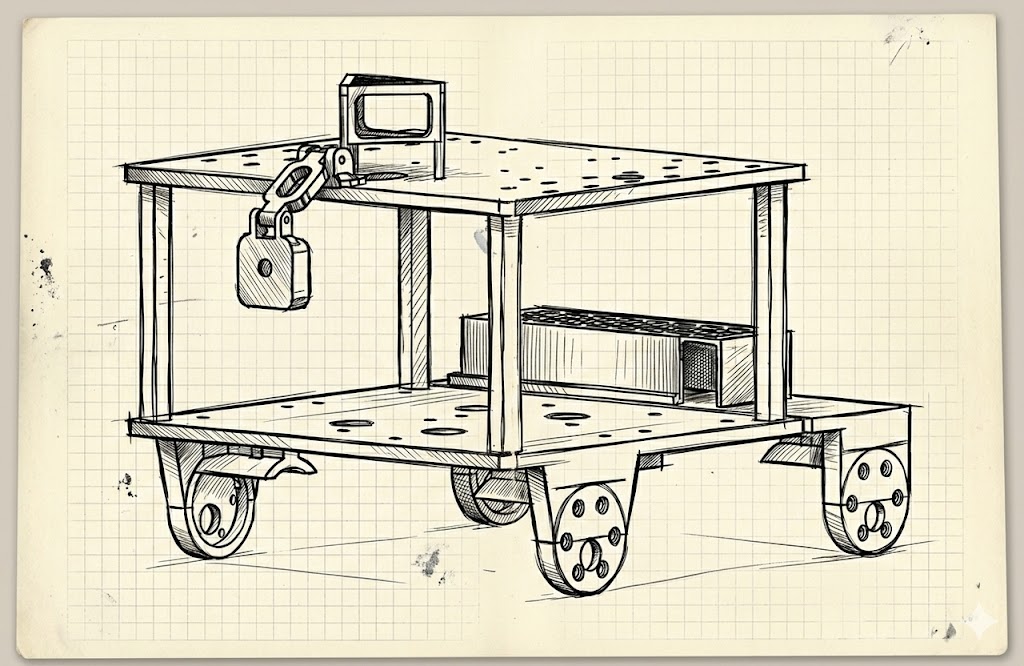
[00] Documentation/images/Sketch.jpg
