Oh-V1G0-Rally/Omnicar_Control_Ros2/[00] Documentation/Thesis_Alessandro/IMG/Design/cavi_motore_pololu.png

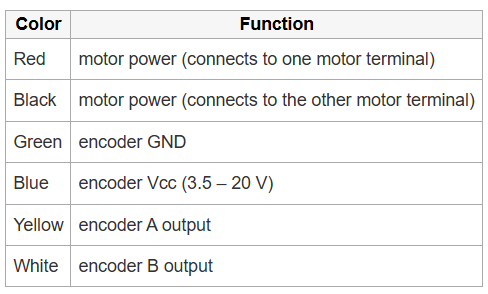
[00] Documentation/Thesis_Alessandro/IMG/Design/cavi_motore_pololu.png
