Oh-V1G0-Rally/Omnicar_Control_Ros2/[00] Documentation/Thesis_Alessandro/IMG/Design/esp32_pin.png

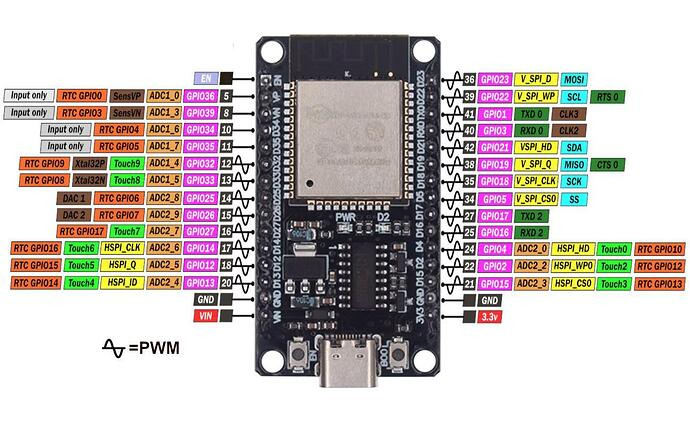
[00] Documentation/Thesis_Alessandro/IMG/Design/esp32_pin.png
