Oh-V1G0-Rally/Omnicar_Control_Ros2/[00] Documentation/Thesis_Alessandro/IMG/Design/ly2_viste.png

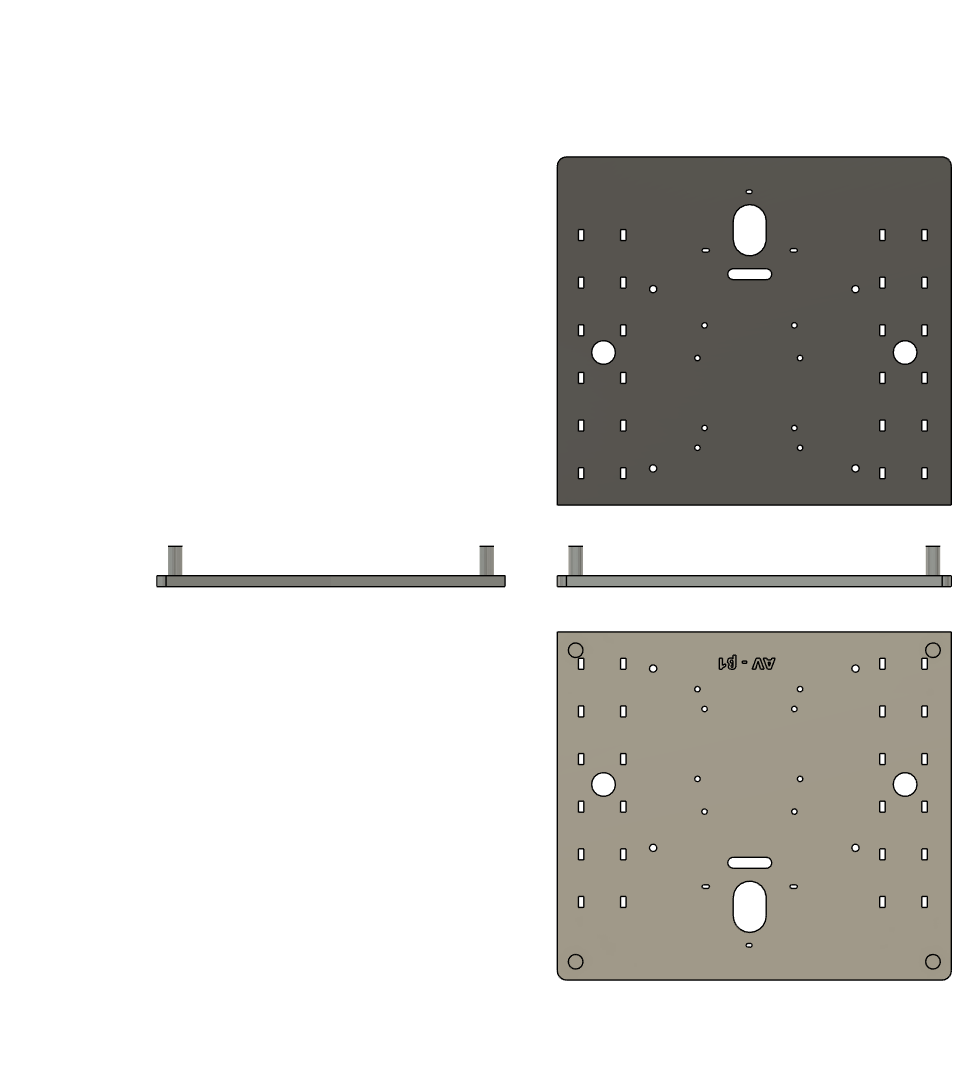
[00] Documentation/Thesis_Alessandro/IMG/Design/ly2_viste.png
