Oh-V1G0-Rally/Omnicar_Control_Ros2/[00] Documentation/Thesis_Alessandro/IMG/Design/Stand_Viste.png

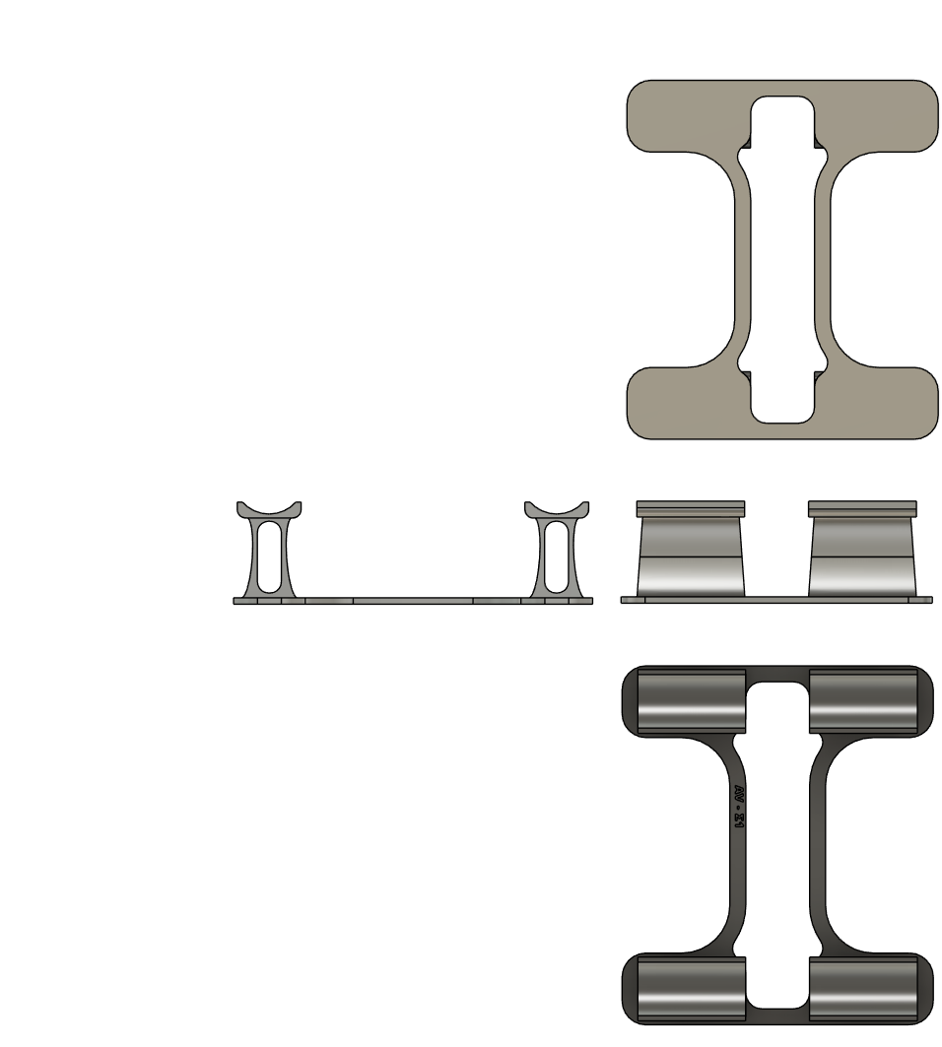
[00] Documentation/Thesis_Alessandro/IMG/Design/Stand_Viste.png
