Oh-V1G0-Rally/Omnicar_Control_Ros2/[00] Documentation/Thesis_Alessandro/IMG/Real/Real_omnicar_front.jpg

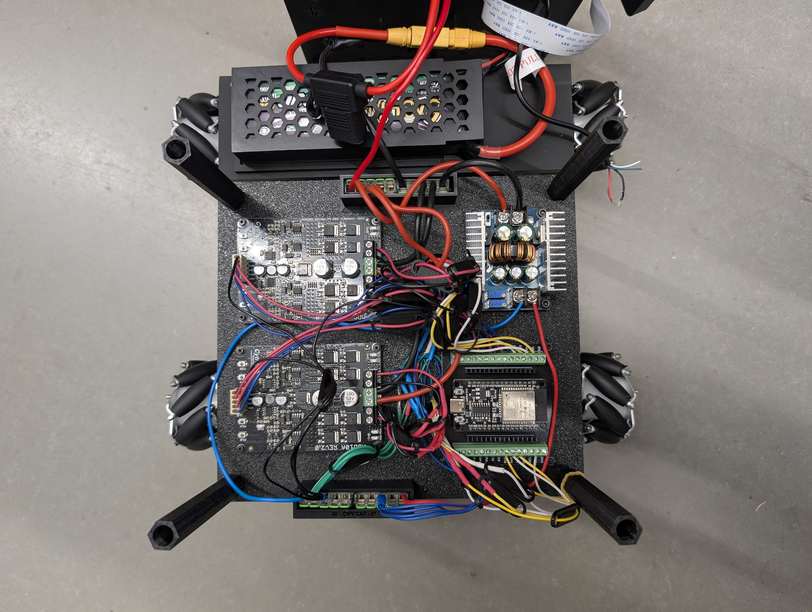
[00] Documentation/Thesis_Alessandro/IMG/Real/Real_omnicar_front.jpg
