Oh-V1G0-Rally/Omnicar_Control_Ros2/[00] Documentation/Thesis_Alessandro/IMG/ROS/odom_real.jpg

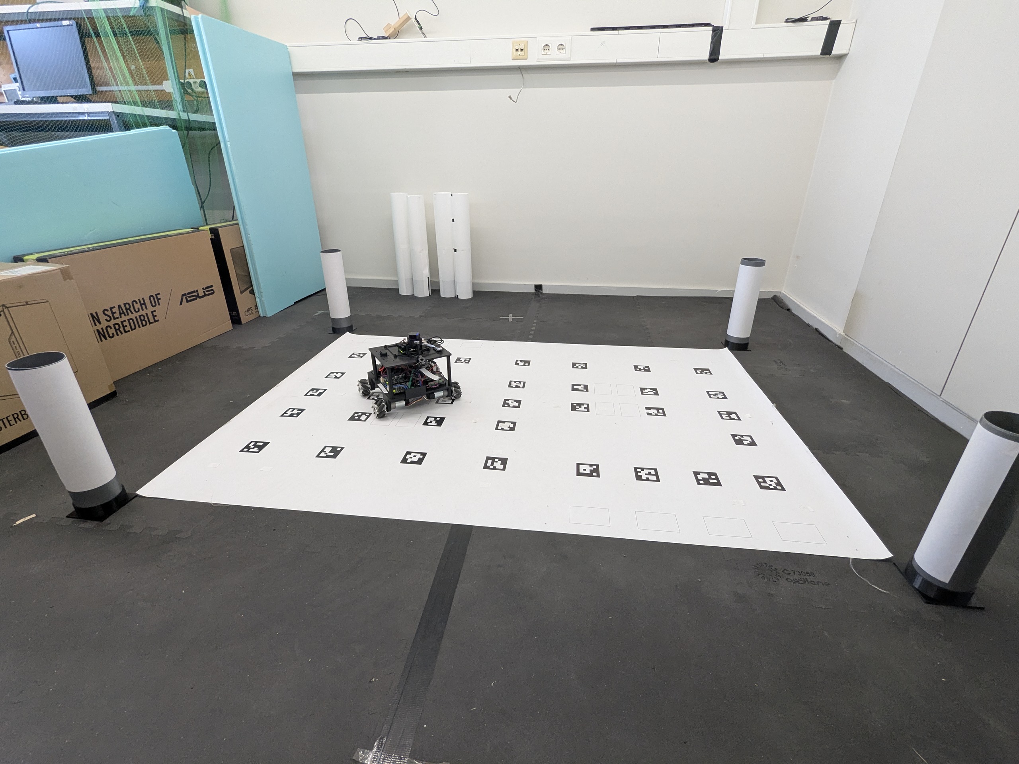
[00] Documentation/Thesis_Alessandro/IMG/ROS/odom_real.jpg
