Oh-V1G0-Rally/Omnicar_Control_Ros2/[02]Code/omnicar_ws/src/splines/FEUP/FEUP_rounded_rect_eight.png

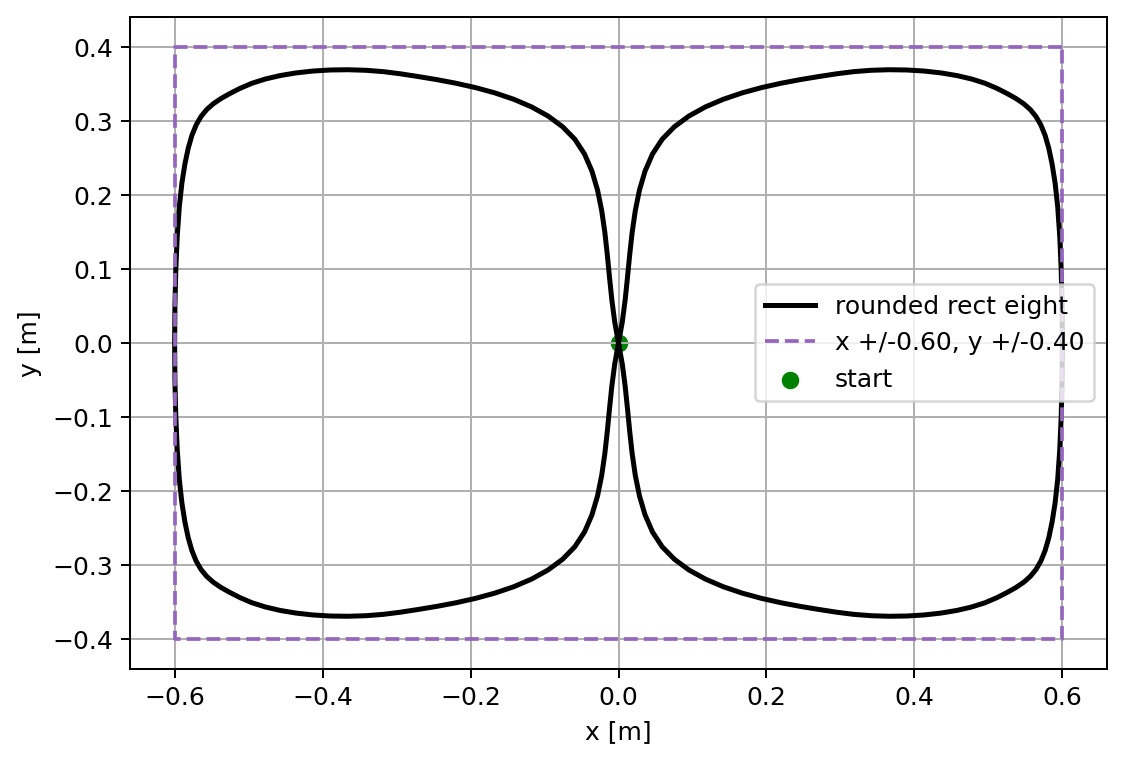
[02]Code/omnicar_ws/src/splines/FEUP/FEUP_rounded_rect_eight.png
