Oh-V1G0-Rally/Omnicar_Control_Ros2/[02]Code/omnicar_ws/src/splines/Hockenheim/Hockenheim_centerline_plot.png

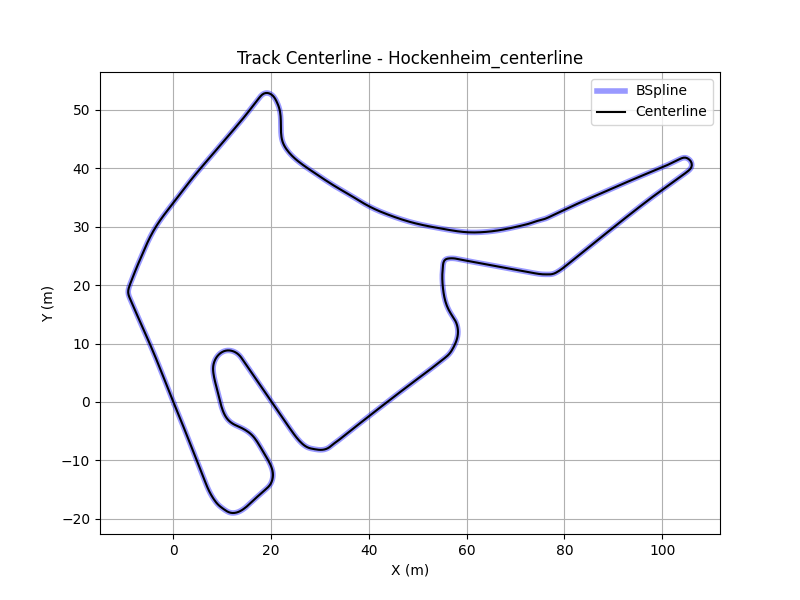
[02]Code/omnicar_ws/src/splines/Hockenheim/Hockenheim_centerline_plot.png
