Oh-V1G0-Rally/Omnicar_Control_Ros2/[02]Code/omnicar_ws/src/splines/Oschersleben/Oschersleben_raceline_plot.png

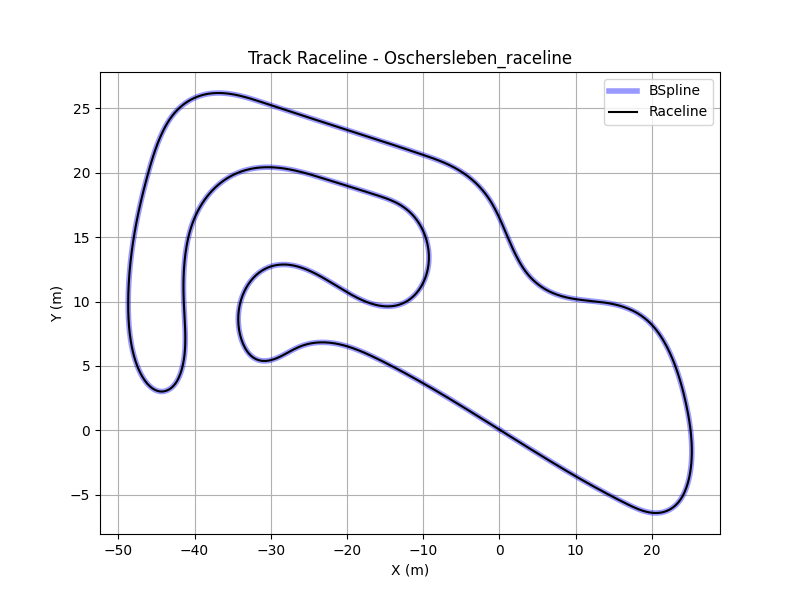
[02]Code/omnicar_ws/src/splines/Oschersleben/Oschersleben_raceline_plot.png
