Oh-V1G0-Rally/Omnicar_Control_Ros2/cad/full+raspberry+pi+4+upgrade+cooling.stp

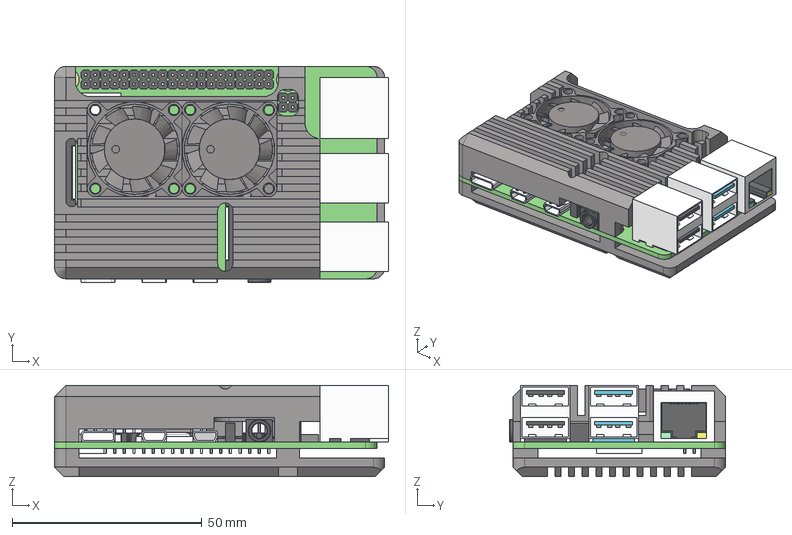
[picture p139: CAD file, 2026-04-02]
cad/full+raspberry+pi+4+upgrade+cooling.stp
88.0 x 57.0 x 24.1 mm
радиатор верх v21
радиатор низ v4
вентилятор v6 x 2
