Oh-V1G0-Rally/Omnicar_Control_Ros2/[01] Cad_files/STL/Battery_COVER.stl

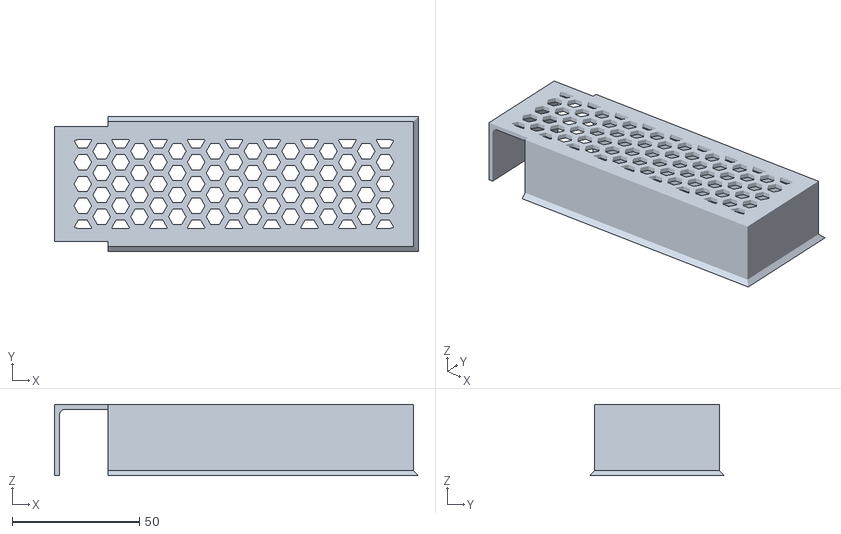
[picture p140: CAD file, 2026-04-02]
[01] Cad_files/STL/Battery_COVER.stl
143.0 x 53.0 x 28.0
