Oh-V1G0-Rally/Omnicar_Control_Ros2/[01] Cad_files/STL/PI_CAMERA/Cam_Stand.stl

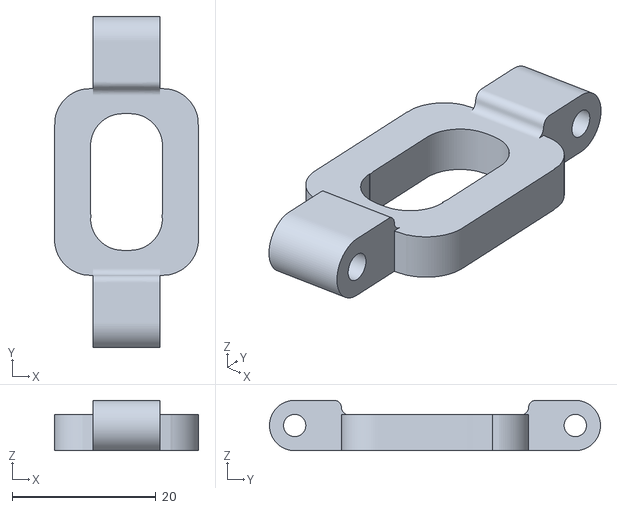
[picture p141: CAD file, 2026-04-02]
[01] Cad_files/STL/PI_CAMERA/Cam_Stand.stl
20.0 x 46.0 x 7.00
