Oh-V1G0-Rally/Omnicar_Control_Ros2/cad/Anilha.stp

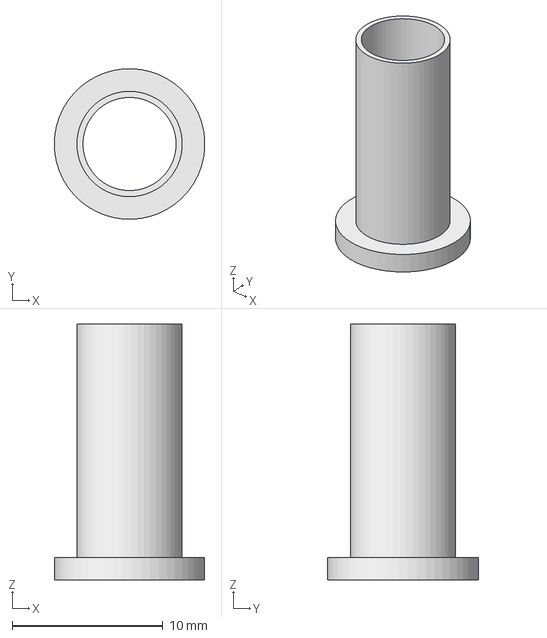
[picture p142: CAD file, 2026-04-02]
cad/Anilha.stp
9.99 x 10.00 x 17.0 mm
