Oh-V1G0-Rally/Omnicar_Control_Ros2/[01] Cad_files/STL/Cable_lable.stl

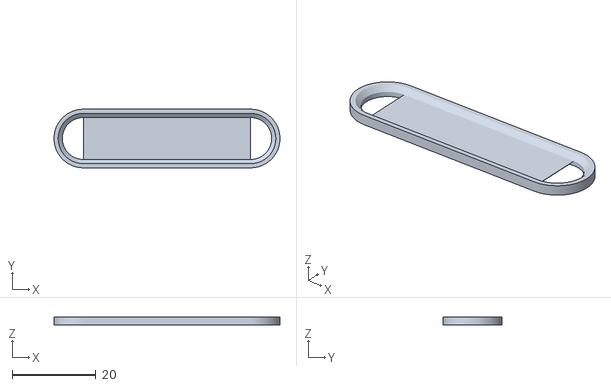
[picture p143: CAD file, 2026-04-02]
[01] Cad_files/STL/Cable_lable.stl
54.0 x 14.0 x 2.00
