Oh-V1G0-Rally/Omnicar_Control_Ros2/[01] Cad_files/STL/PI_CAMERA/Camera_Back_Cover.stl

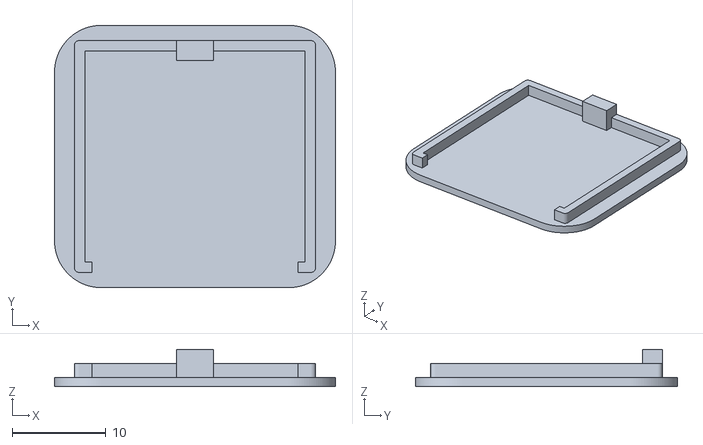
[picture p144: CAD file, 2026-04-02]
[01] Cad_files/STL/PI_CAMERA/Camera_Back_Cover.stl
30.0 x 28.0 x 4.00
