Oh-V1G0-Rally/Omnicar_Control_Ros2/cad/Anilha_4.stp

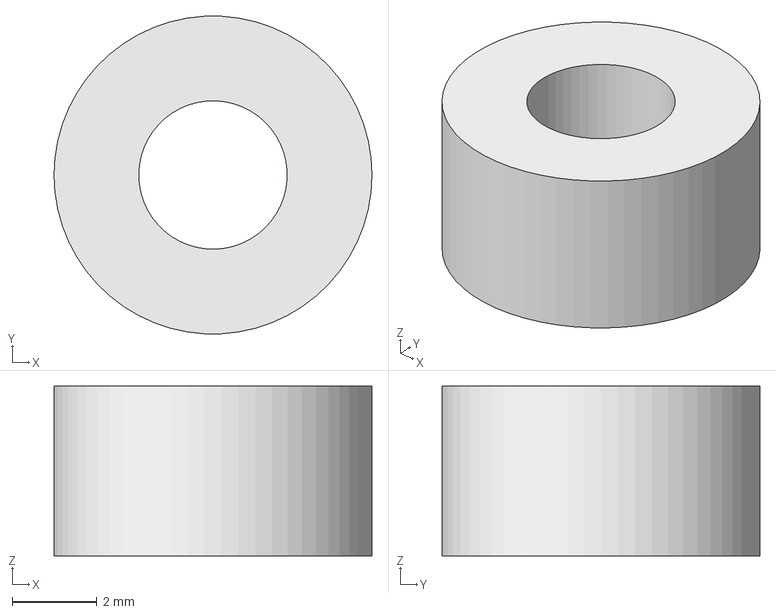
[picture p145: CAD file, 2026-04-02]
cad/Anilha_4.stp
7.50 x 7.49 x 4.00 mm
