Oh-V1G0-Rally/Omnicar_Control_Ros2/[01] Cad_files/STL/LIDAR_SUPPORT.stl

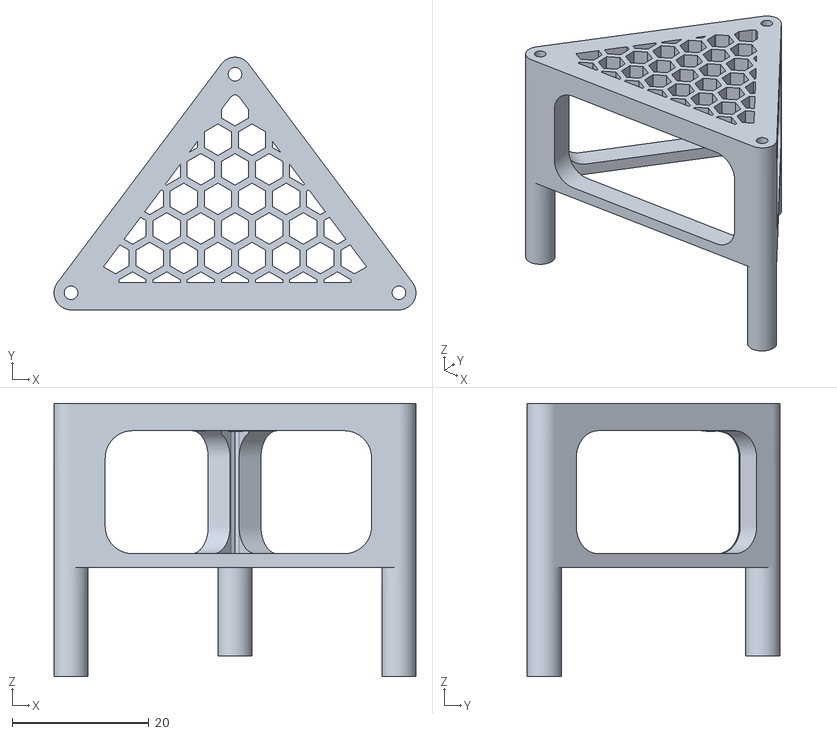
[picture p146: CAD file, 2026-04-02]
[01] Cad_files/STL/LIDAR_SUPPORT.stl
53.0 x 37.0 x 40.0
