Oh-V1G0-Rally/Omnicar_Control_Ros2/[01] Cad_files/STL/PI_CAMERA/Cam_Front_Cover.stl

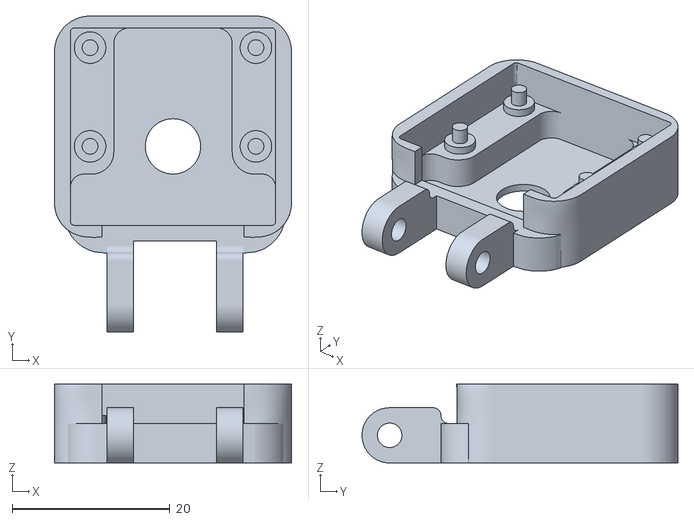
[picture p147: CAD file, 2026-04-02]
[01] Cad_files/STL/PI_CAMERA/Cam_Front_Cover.stl
30.0 x 40.0 x 10.0
