Oh-V1G0-Rally/Omnicar_Control_Ros2/cad/Suporte_postes.stp

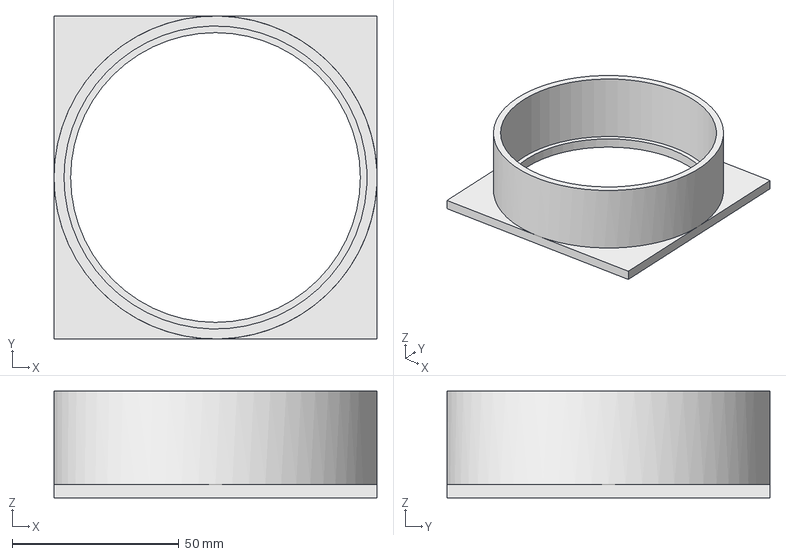
[picture p148: CAD file, 2026-04-02]
cad/Suporte_postes.stp
97.0 x 97.0 x 32.0 mm
