Oh-V1G0-Rally/Omnicar_Control_Ros2/[01] Cad_files/STL/LY1_BACK.stl

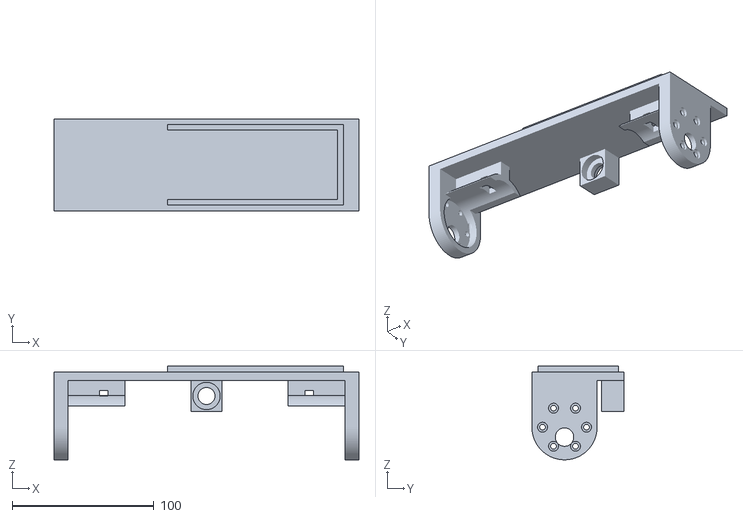
[picture p149: CAD file, 2026-04-02]
[01] Cad_files/STL/LY1_BACK.stl
215.0 x 65.0 x 66.0
