Oh-V1G0-Rally/Omnicar_Control_Ros2/[01] Cad_files/STL/PI_CAMERA/Camera_Stand_Base.stl

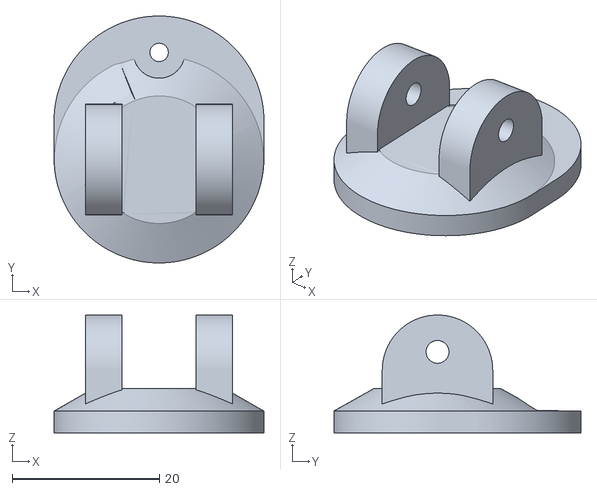
[picture p150: CAD file, 2026-04-02]
[01] Cad_files/STL/PI_CAMERA/Camera_Stand_Base.stl
28.5 x 33.5 x 16.0
