Oh-V1G0-Rally/Omnicar_Control_Ros2/cad/eixo_roda.stp

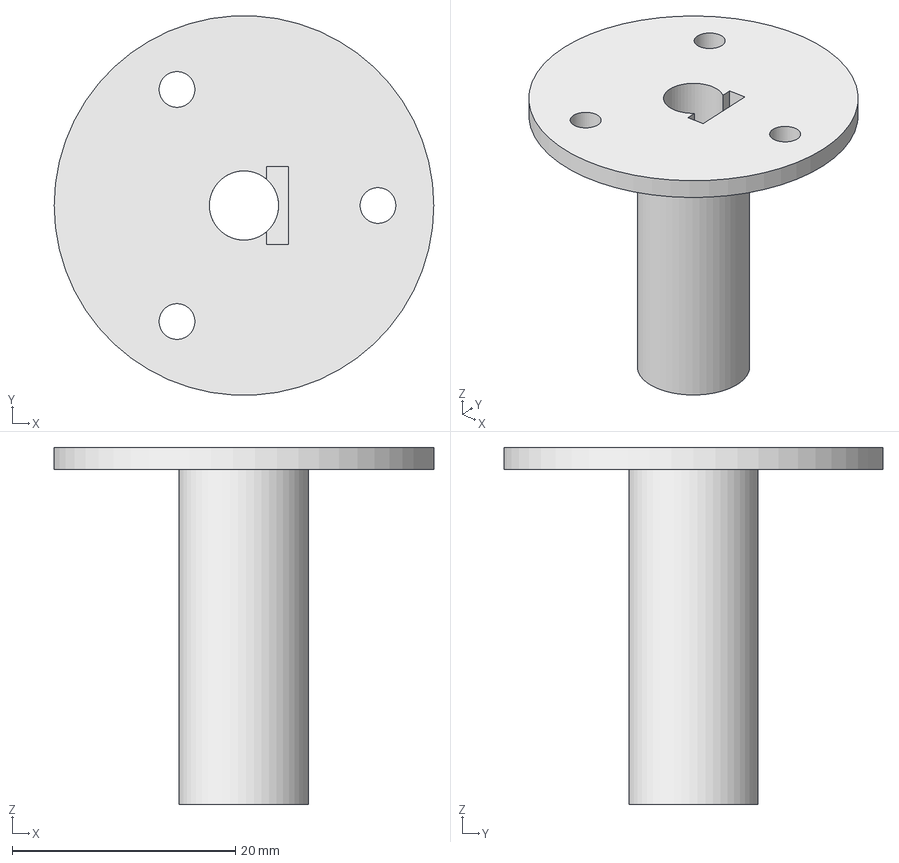
[picture p151: CAD file, 2026-04-02]
cad/eixo_roda.stp
34.0 x 33.9 x 32.0 mm
