Oh-V1G0-Rally/Omnicar_Control_Ros2/[01] Cad_files/STL/PI_CAM_short_sup.stl

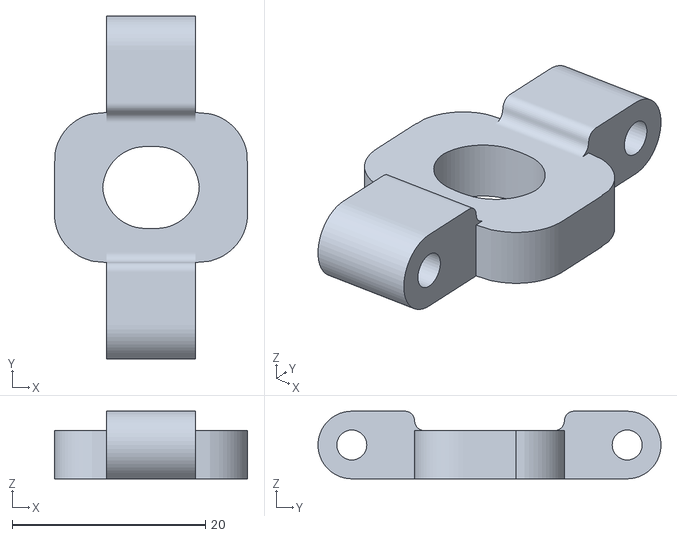
[picture p152: CAD file, 2026-04-02]
[01] Cad_files/STL/PI_CAM_short_sup.stl
20.0 x 35.5 x 7.00
