Oh-V1G0-Rally/Omnicar_Control_Ros2/[01] Cad_files/STL/LY2_B2.stl

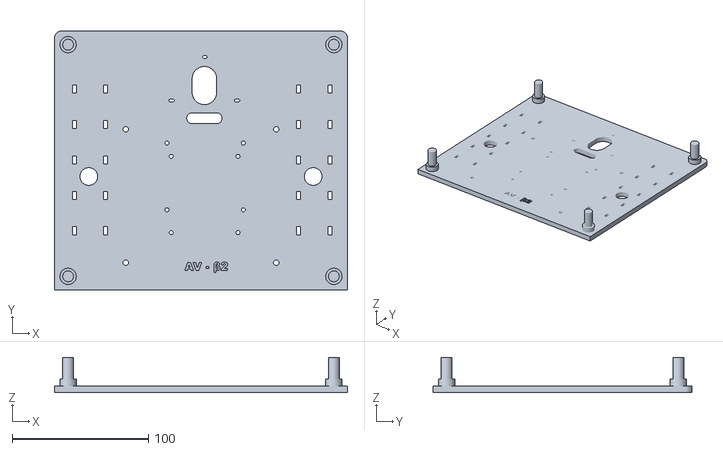
[picture p154: CAD file, 2026-04-02]
[01] Cad_files/STL/LY2_B2.stl
215.0 x 190.0 x 26.0
