Oh-V1G0-Rally/Omnicar_Control_Ros2/cad/ydliar_X2.stp

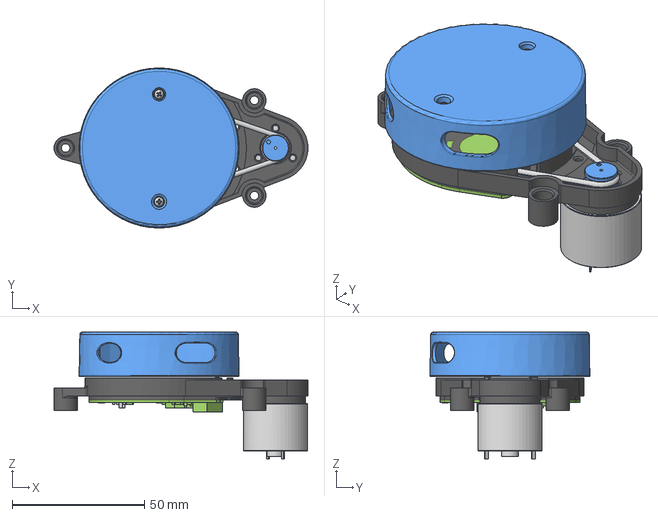
[picture p155: CAD file, 2026-04-02]
cad/ydliar_X2.stp
95.9 x 60.5 x 48.0 mm
