Oh-V1G0-Rally/Omnicar_Control_Ros2/[01] Cad_files/STL/Cabletray_W10xH15xL100.stl

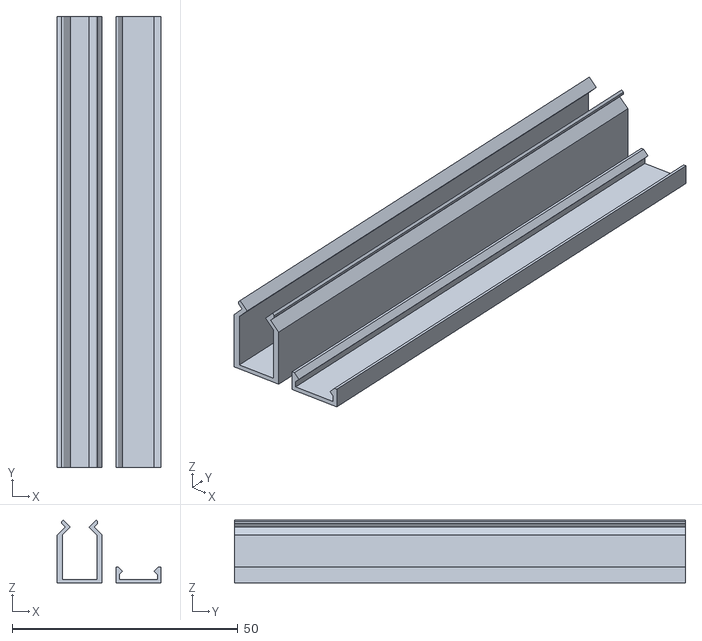
[picture p156: CAD file, 2026-04-02]
[01] Cad_files/STL/Cabletray_W10xH15xL100.stl
23.0 x 100.0 x 14.0
