Oh-V1G0-Rally/Omnicar_Control_Ros2/cad/pillar.stp

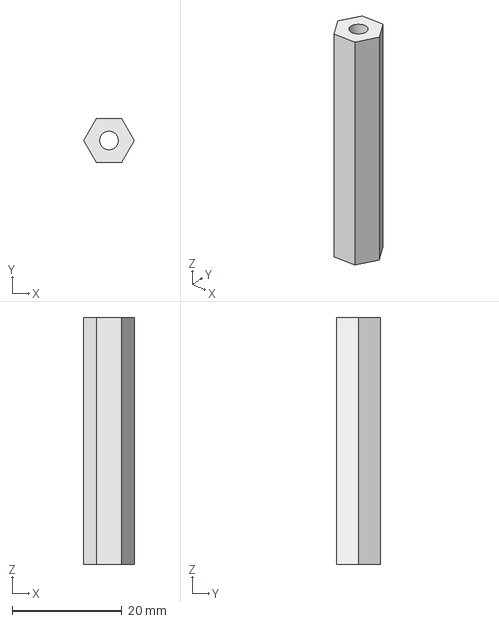
[picture p157: CAD file, 2026-04-02]
cad/pillar.stp
9.24 x 8.00 x 45.0 mm
