Oh-V1G0-Rally/Omnicar_Control_Ros2/[01] Cad_files/STL/LY2_TOP.stl

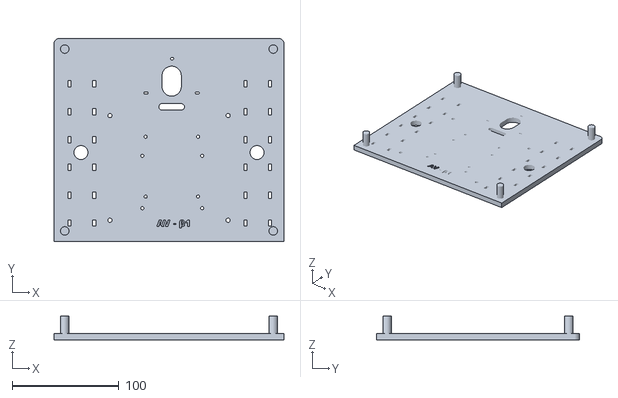
[picture p158: CAD file, 2026-04-02]
[01] Cad_files/STL/LY2_TOP.stl
215.0 x 190.0 x 22.0
