Oh-V1G0-Rally/Omnicar_Control_Ros2/cad/Estrutura_robo.stp

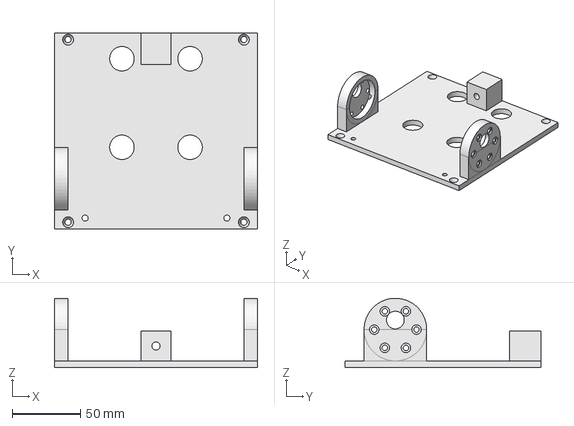
[picture p159: CAD file, 2026-04-02]
cad/Estrutura_robo.stp
149.0 x 143.9 x 51.0 mm
