Oh-V1G0-Rally/Omnicar_Control_Ros2/[01] Cad_files/STL/STAND_OMNICAR.3mf

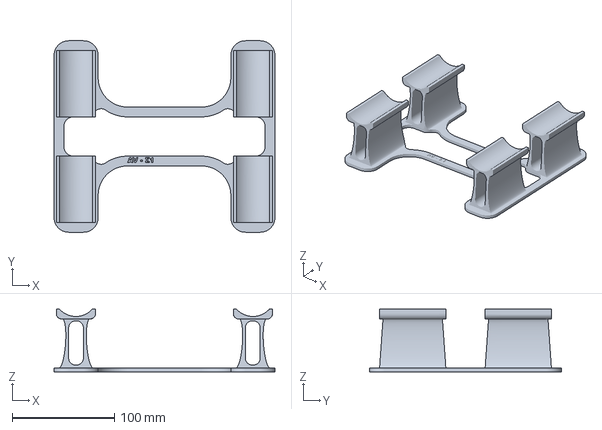
[picture p160: CAD file, 2026-04-02]
[01] Cad_files/STL/STAND_OMNICAR.3mf
216.1 x 187.3 x 61.4 mm
