Oh-V1G0-Rally/Omnicar_Control_Ros2/cad/Eletro_Iman_support+v2.stp

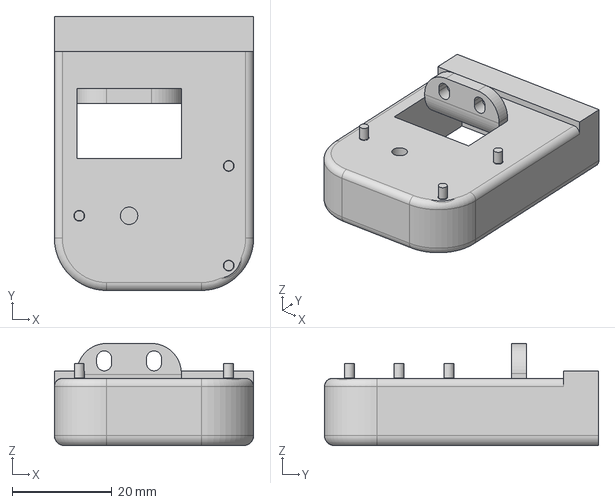
[picture p161: CAD file, 2026-04-02]
cad/Eletro_Iman_support+v2.stp
40.0 x 55.0 x 20.5 mm
