Oh-V1G0-Rally/Omnicar_Control_Ros2/[01] Cad_files/STL/cable_lable_S.stl

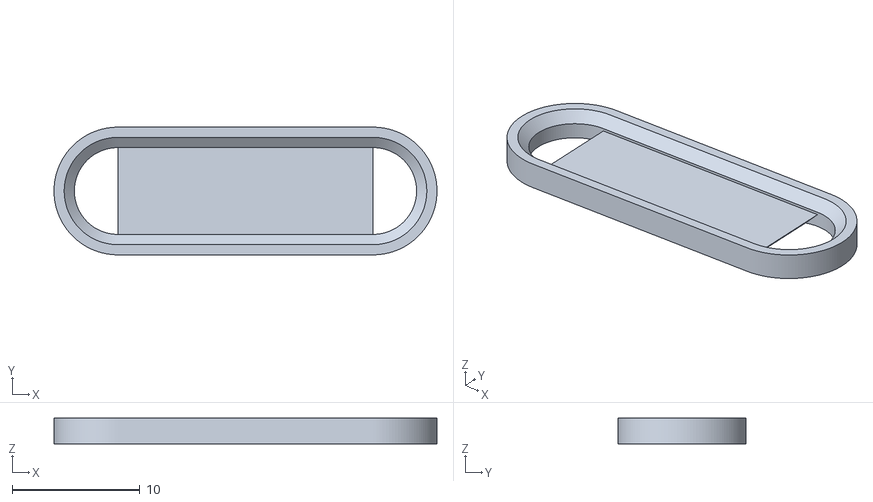
[picture p162: CAD file, 2026-04-02]
[01] Cad_files/STL/cable_lable_S.stl
30.0 x 10.0 x 2.00
