Oh-V1G0-Rally/Omnicar_Control_Ros2/cad/anilhaimu.stp

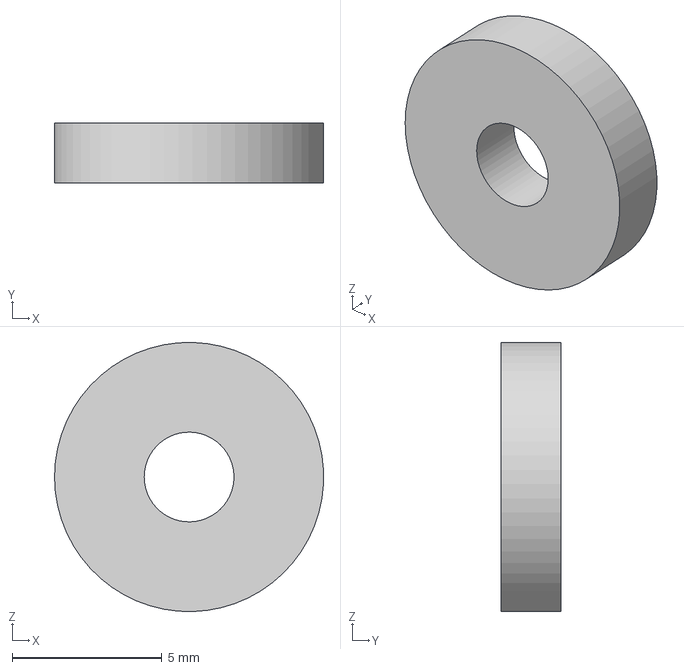
[picture p163: CAD file, 2026-04-02]
cad/anilhaimu.stp
8.99 x 2.00 x 9.00 mm
