Oh-V1G0-Rally/Omnicar_Control_Ros2/[01] Cad_files/STL/LY1_FRONT.stl

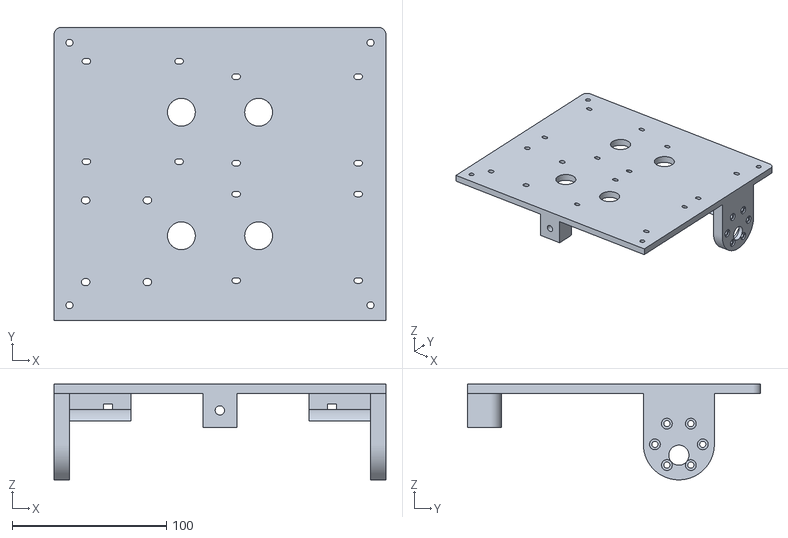
[picture p164: CAD file, 2026-04-02]
[01] Cad_files/STL/LY1_FRONT.stl
215.0 x 190.0 x 62.0
