Oh-V1G0-Rally/Omnicar_Control_Ros2/cad/LCD_frame.stp

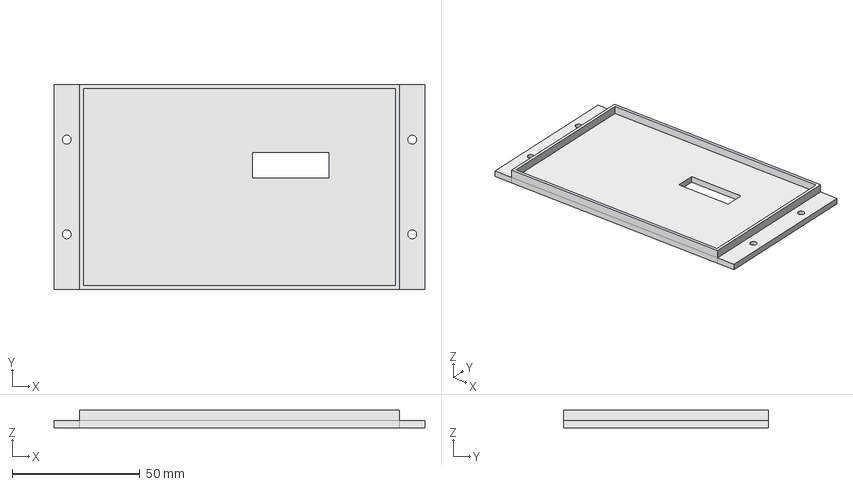
[picture p165: CAD file, 2026-04-02]
cad/LCD_frame.stp
145.0 x 80.0 x 7.00 mm
