Oh-V1G0-Rally/Omnicar_Control_Ros2/[01] Cad_files/STL/Wago_Case_Back.stl

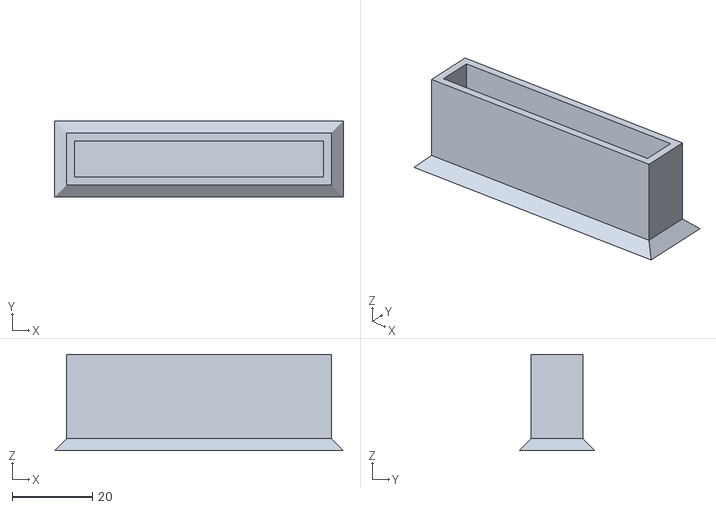
[picture p166: CAD file, 2026-04-02]
[01] Cad_files/STL/Wago_Case_Back.stl
72.0 x 19.0 x 24.0
