Oh-V1G0-Rally/Omnicar_Control_Ros2/cad/chapa_v6.stp

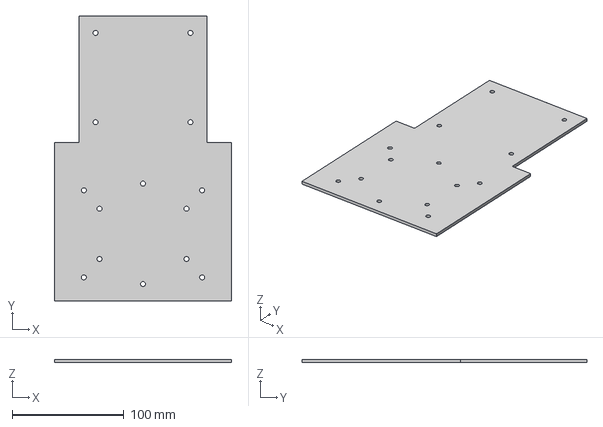
[picture p167: CAD file, 2026-04-02]
cad/chapa_v6.stp
158.6 x 255.0 x 3.00 mm
