Oh-V1G0-Rally/Omnicar_Control_Ros2/[01] Cad_files/STL/Coperchio_Canalina_60mm.stl

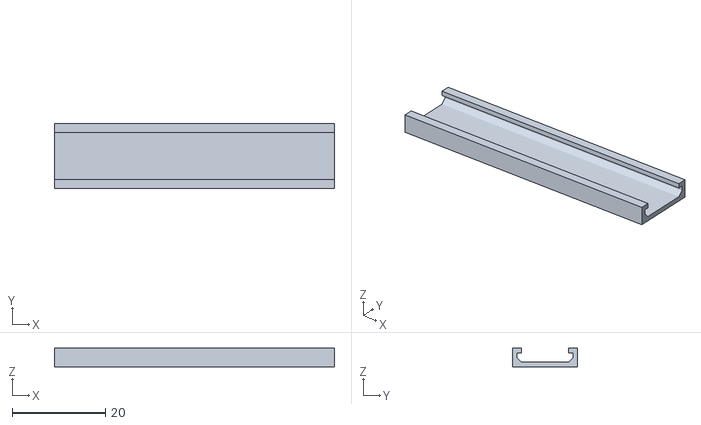
[picture p168: CAD file, 2026-04-02]
[01] Cad_files/STL/Coperchio_Canalina_60mm.stl
60.0 x 14.0 x 4.00
