Oh-V1G0-Rally/Omnicar_Control_Ros2/cad/suporte_camara.stp

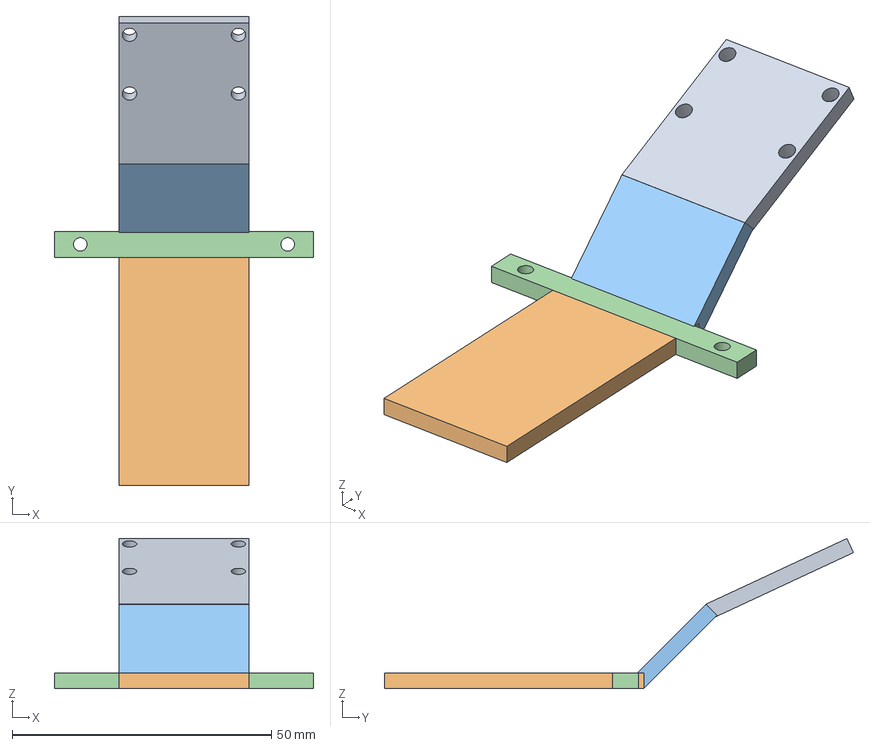
[picture p169: CAD file, 2026-04-02]
cad/suporte_camara.stp
50.0 x 90.4 x 28.9 mm
