Oh-V1G0-Rally/Omnicar_Control_Ros2/[01] Cad_files/STL/Canalina_60mm.stl

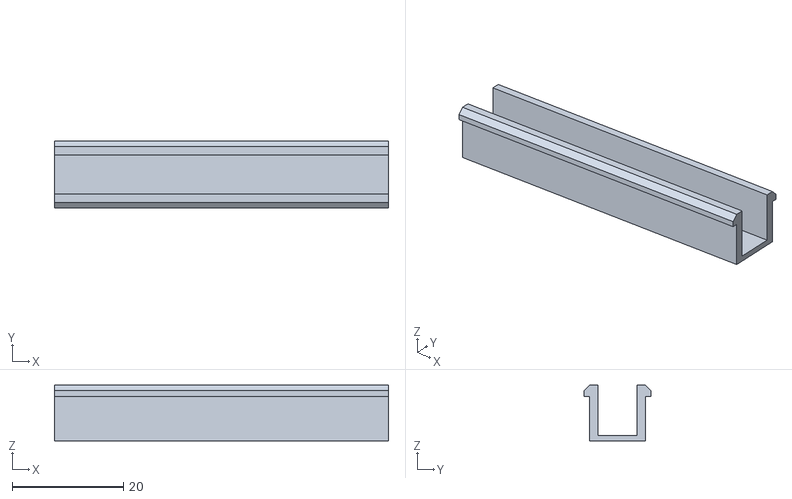
[picture p170: CAD file, 2026-04-02]
[01] Cad_files/STL/Canalina_60mm.stl
60.0 x 12.0 x 10.0
