Oh-V1G0-Rally/Omnicar_Control_Ros2/cad/suporte_eletroiman.stp

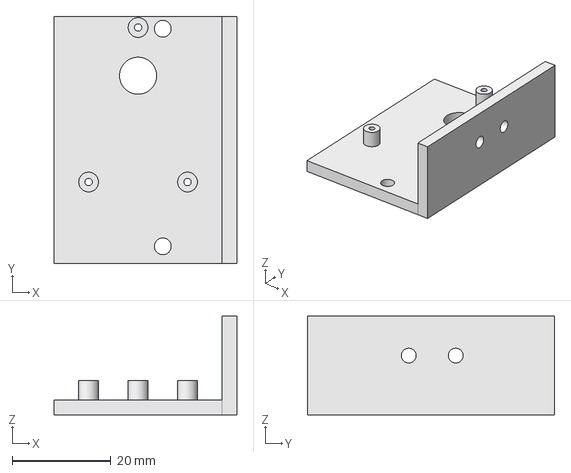
[picture p171: CAD file, 2026-04-02]
cad/suporte_eletroiman.stp
37.0 x 50.0 x 20.0 mm
