Oh-V1G0-Rally/Omnicar_Control_Ros2/cad/Modular_design.stp

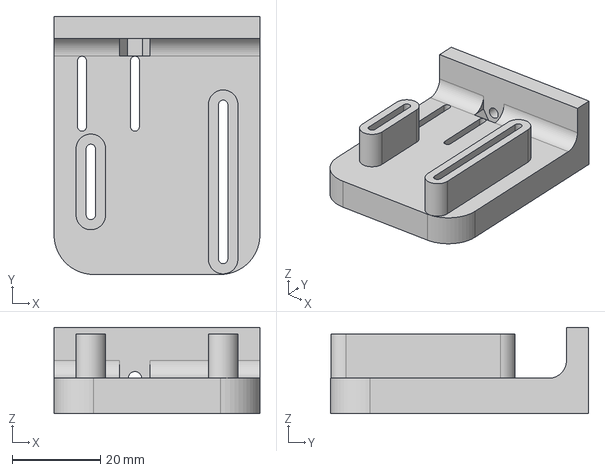
[picture p172: CAD file, 2026-04-02]
cad/Modular_design.stp
46.7 x 58.5 x 19.5 mm
