Oh-V1G0-Rally/Omnicar_Control_Ros2/[01] Cad_files/STL/JETSON_Support.stl

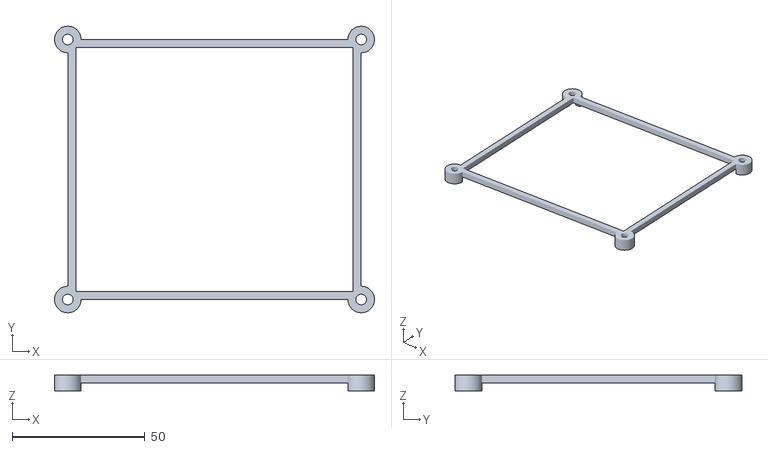
[picture p173: CAD file, 2026-04-02]
[01] Cad_files/STL/JETSON_Support.stl
120.4 x 107.8 x 6.00
