Oh-V1G0-Rally/Omnicar_Control_Ros2/cad/placa_sup_rasp.stp

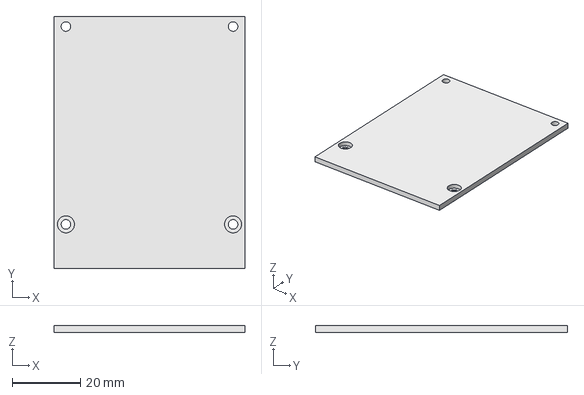
[picture p174: CAD file, 2026-04-02]
cad/placa_sup_rasp.stp
56.0 x 74.0 x 2.00 mm
