Oh-V1G0-Rally/Omnicar_Control_Ros2/[01] Cad_files/STL/PILLAR.stl

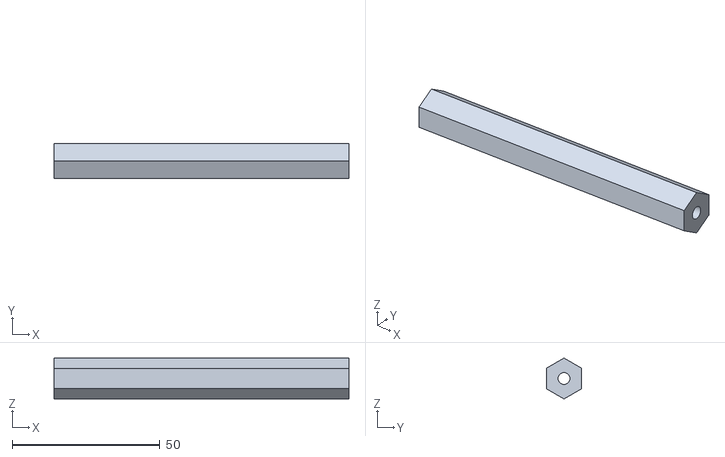
[picture p175: CAD file, 2026-04-02]
[01] Cad_files/STL/PILLAR.stl
100.0 x 12.0 x 13.9
