Oh-V1G0-Rally/Omnicar_Control_Ros2/cad/suporte_bateria_FOmni.stp

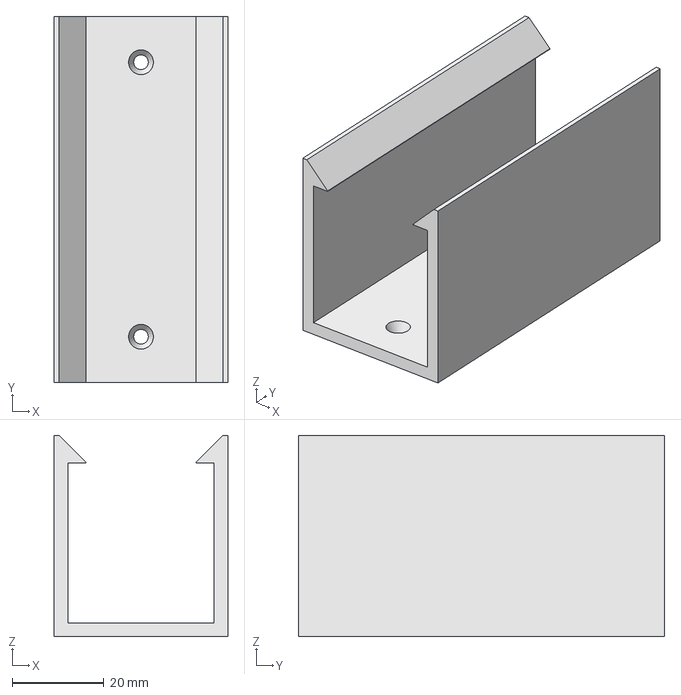
[picture p176: CAD file, 2026-04-02]
cad/suporte_bateria_FOmni.stp
38.0 x 80.0 x 44.0 mm
