Oh-V1G0-Rally/Omnicar_Control_Ros2/[01] Cad_files/STL/all_acc.3mf

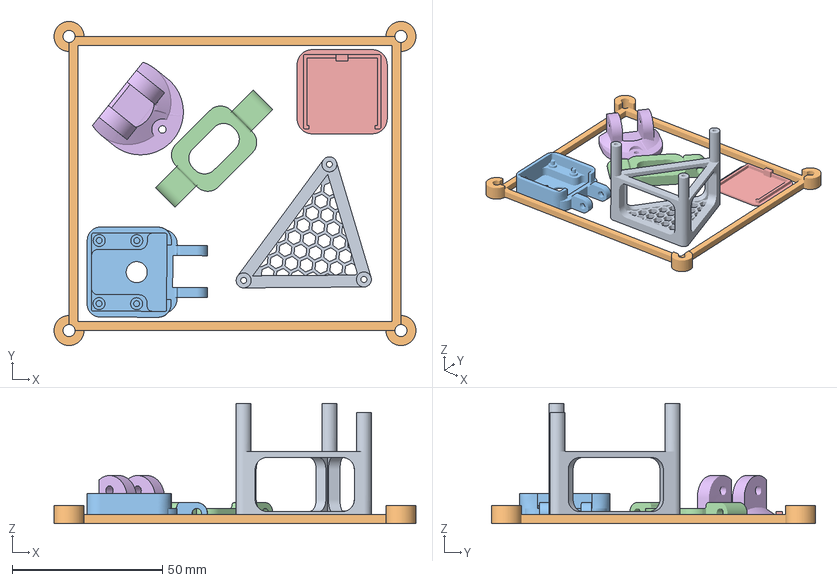
[picture p177: CAD file, 2026-04-02]
[01] Cad_files/STL/all_acc.3mf
120.4 x 107.8 x 40.0 mm
LIDAR_SUPPORT.stl
JETSON_Support.stl
Cam_Front_Cover.stl
Cam_Stand.stl
Camera_Back_Cover.stl
Camera_Stand_Base_clean.stl
