Oh-V1G0-Rally/Omnicar_Control_Ros2/[01] Cad_files/STL/Wago_Case_Front.stl

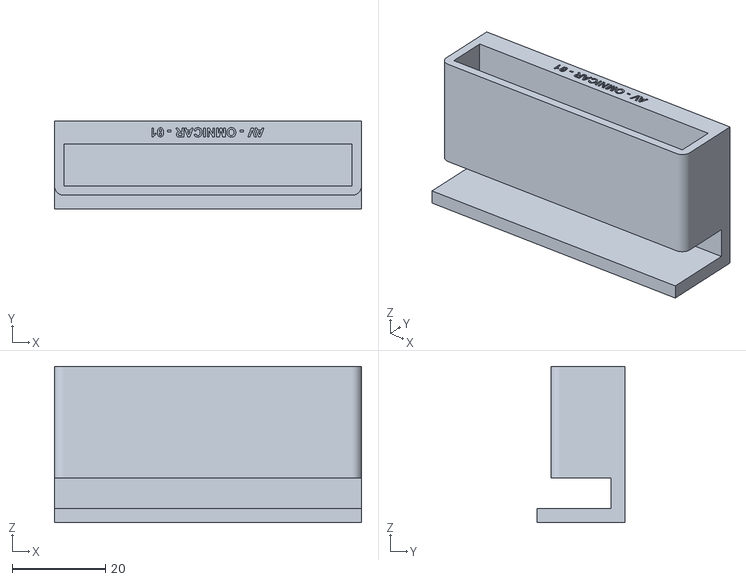
[picture p178: CAD file, 2026-04-02]
[01] Cad_files/STL/Wago_Case_Front.stl
66.0 x 19.0 x 33.6
