Oh-V1G0-Rally/Omnicar_Control_Ros2/cad/suporte_eletroiman_interno.stp

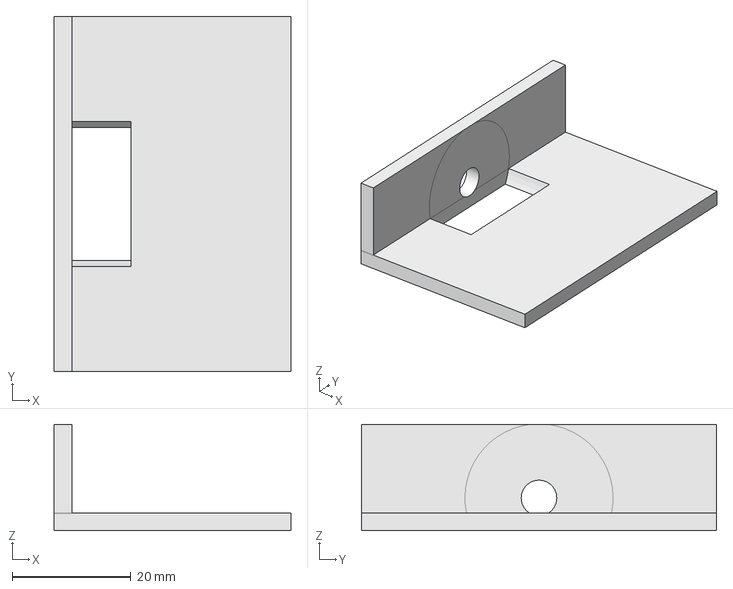
[picture p179: CAD file, 2026-04-02]
cad/suporte_eletroiman_interno.stp
40.0 x 60.0 x 17.9 mm
