Oh-V1G0-Rally/Omnicar_Control_Ros2/cad/Suportes_laser.stp

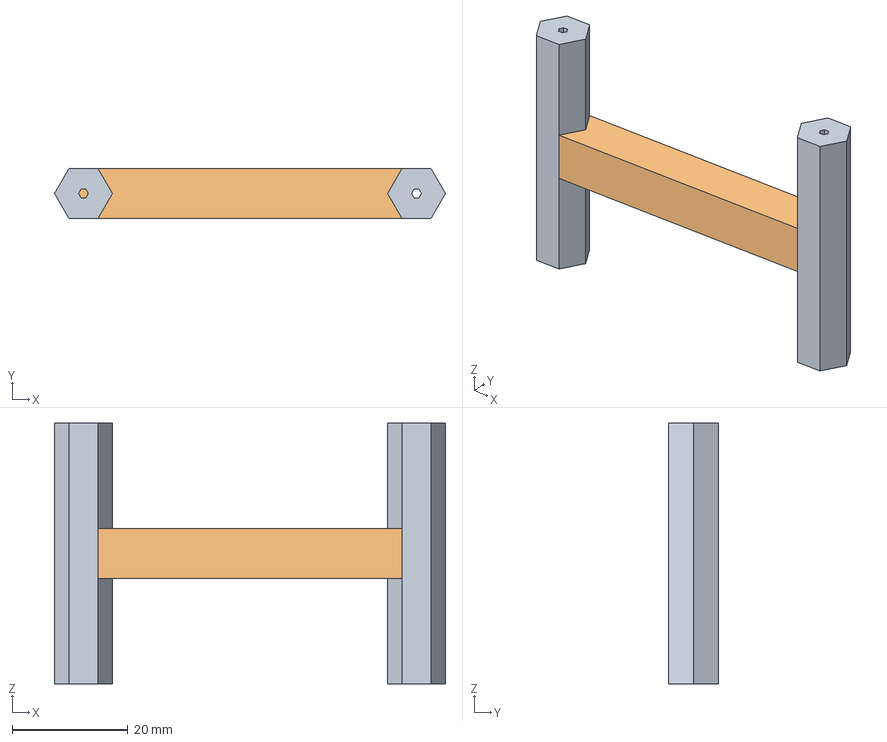
[picture p180: CAD file, 2026-04-02]
cad/Suportes_laser.stp
67.5 x 8.66 x 45.0 mm
