Oh-V1G0-Rally/Omnicar_Control_Ros2/cad/ydlidar x4.SLDPRT

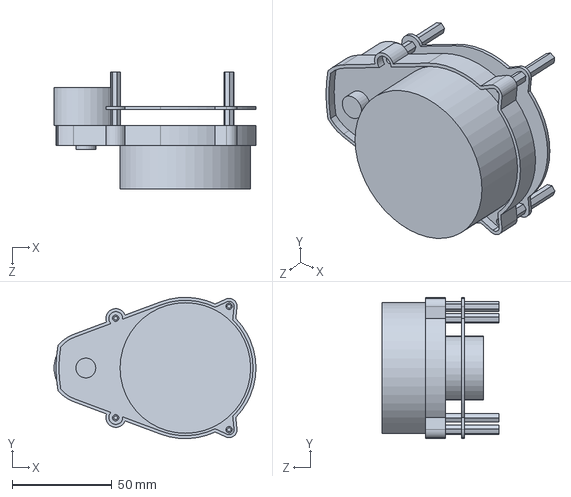
[picture p181: CAD file, 2026-04-02]
cad/ydlidar x4.SLDPRT
101.5 x 70.9 x 59.0 mm
