Oh-V1G0-Rally/Omnicar_Control_Ros2/cad/Estrutura_robo_superior.stp

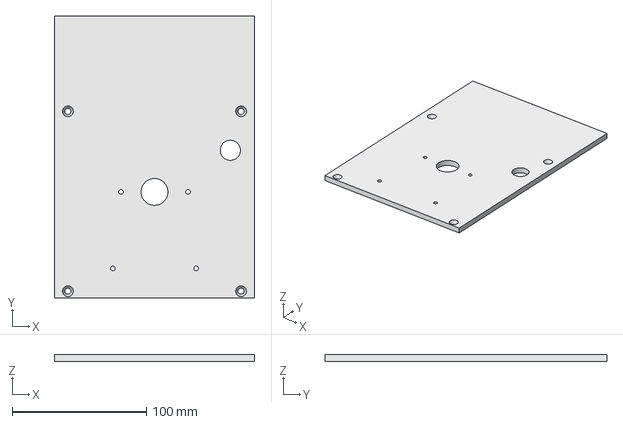
[picture p182: CAD file, 2026-04-02]
cad/Estrutura_robo_superior.stp
149.0 x 210.0 x 5.00 mm
