Oh-V1G0-Rally/Omnicar_Control_Ros2/cad/Fixed.stp

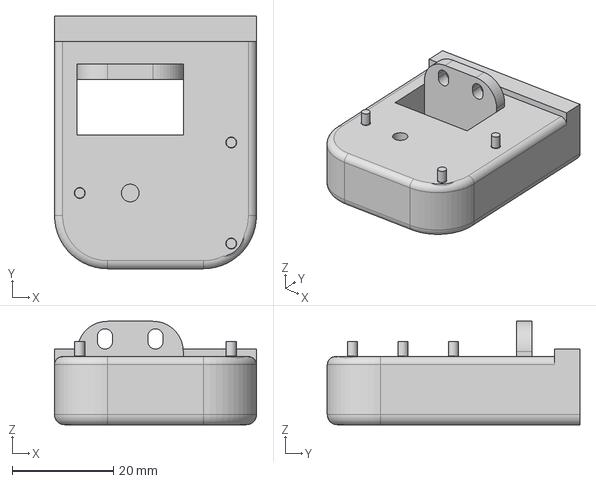
[picture p183: CAD file, 2026-04-02]
cad/Fixed.stp
40.0 x 50.0 x 20.5 mm
