Oh-V1G0-Rally/Omnicar_Control_Ros2/cad/Cam+V2.stp

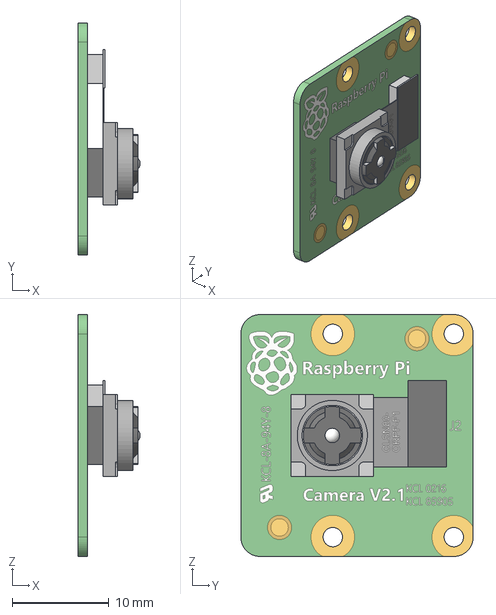
[picture p184: CAD file, 2026-04-02]
cad/Cam+V2.stp
6.45 x 24.0 x 25.0 mm
