Oh-V1G0-Rally/Omnicar_Control_Ros2/(list of files, cad)

Other CAD files:
[01] Cad_files/STL/LY1_FRONT_v2.stl
[01] Cad_files/STL/STAND_OMNICAR.stl
cad/Eletro_Iman_support+v1.stp
cad/LY1.f3d
