Oh-V1G0-Rally/Omnicar_Control_Ros2/[02]Code/Omnicar/py_script/csv_test/PeriodicNoise/README

Motor number = Mx
Motor All = MA
--------------------------
Test without Load = NL
Test with load = LO
--------------------------
Test number = Tx
