Oh-V1G0-Rally/Omnicar_Control_Ros2/[00] Documentation/Thesis_Alessandro/IMG/ROS/PDF_rosgraph_test_enc_vel_ref.pdf

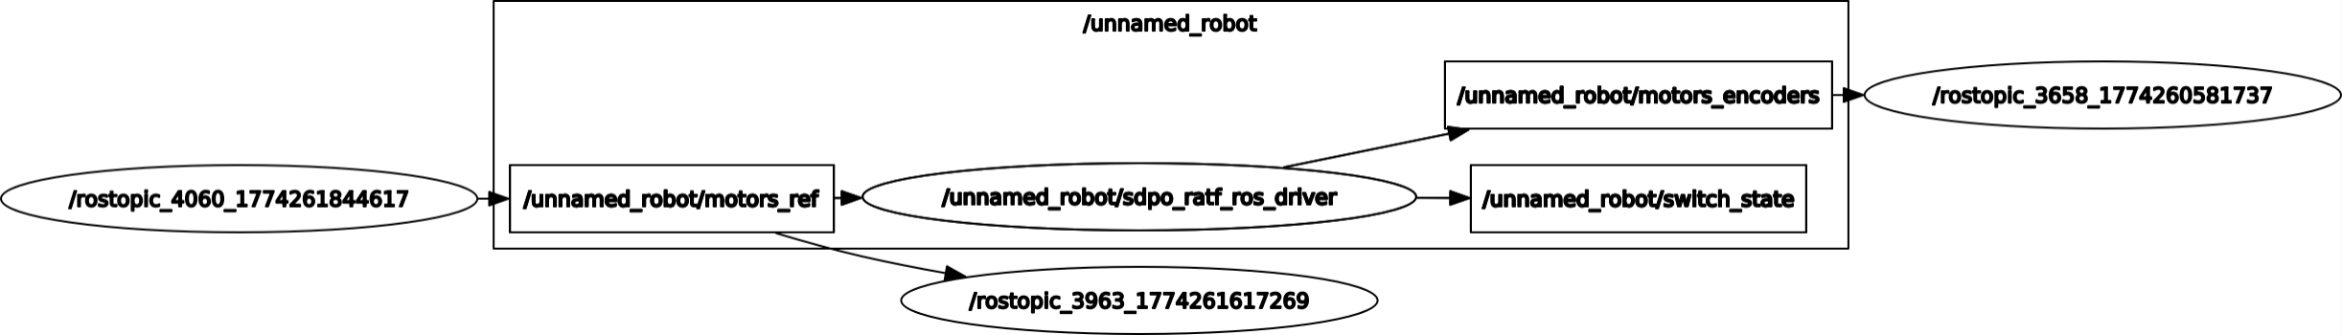
[picture p208: page 1]
