Oh-V1G0-Rally/Omnicar_Control_Ros2/[02]Code/omnicar_ws/Test/test_results/ComparisonFinal.ods

parameter | PF_2026-04-29_INFIN_MAP_LINEAR_V01_04 | PF_2026-04-29_INFIN_MAP_LINEAR_V01_05 | PF_2026-05-11_INFIN_MAP_MPCC_V01_05 | PF_2026-05-11_INFIN_MAP_MPCC_V01_06
test_id | PF_2026-04-29_INFIN_MAP_LINEAR_V01_04 | PF_2026-04-29_INFIN_MAP_LINEAR_V01_05 | PF_2026-05-11_INFIN_MAP_MPCC_V01_05 | PF_2026-05-11_INFIN_MAP_MPCC_V01_06
date | 2026-04-29 | 2026-04-29 | 2026-05-11 | 2026-05-11
run_index | 4 | 5 | 5 | 6
bag_name | PF_2026-04-29_INFIN_MAP_LINEAR_V01_04 | PF_2026-04-29_INFIN_MAP_LINEAR_V01_05 | PF_2026-05-11_INFIN_MAP_MPCC_V01_05 | PF_2026-05-11_INFIN_MAP_MPCC_V01_06
path_name | INFIN | INFIN | INFIN | INFIN
frame | MAP | MAP | MAP | MAP
map_name | FEUP_180x120 | FEUP_180x120 | FEUP_180x120 | FEUP_180x120
controller_name | PONLY | PONLY | MPCC | MPCC
controller_version | V01 | V01 | V01 | V01
controller_mode | linear_segment | linear_segment | nonlinear_mpcc | nonlinear_mpcc
heading_mode | fixed | fixed | fixed | fixed
desired_speed | 0.4 | 0.5
k_gamma | 0.3 | 0.4
min_gamma_dot | 0.05 | 0.05 | 0 | 0.05
max_gamma_dot | 0.3 | 0.3 | 0.4 | 0.7
linear_k_along | 1 | 1
linear_k_lateral | 5 | 8
linear_projection_lookahead | 0 | 0
linear_projection_search_behind | 0.1 | 0.1
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
