Oh-V1G0-Rally/Omnicar_Control_Ros2/[02]Code/omnicar_ws/Test/test_results/path_following_tests_summary.csv

parameter | PF_2026-04-28_INFIN_MAP_LINEAR_V01_R01 | PF_2026-04-28_INFIN_MAP_LINEAR_V01_R02 | PF_2026-04-28_INFIN_MAP_LINEAR_V01_R03 | PF_2026-04-28_INFIN_MAP_LINEAR_V01_R04 | PF_2026-04-29_INFIN_MAP_LINEAR_V01_R01 | PF_2026-04-29_INFIN_MAP_LINEAR_V01_R02 | PF_2026-04-29_INFIN_MAP_LINEAR_V01_R03 | PF_2026-04-29_INFIN_MAP_LINEAR_V01_R04 | PF_2026-04-29_INFIN_MAP_LINEAR_V01_R05 | PF_2026-04-29_INFIN_MAP_LINEAR_V01_R06 | PF_2026-04-29_INFIN_MAP_LINEAR_V01_R07 | PF_2026-04-29_INFIN_MAP_LINEAR_V01_R08 | PF_2026-04-29_INFIN_MAP_LINEAR_V01_R09 | PF_2026-04-29_INFIN_MAP_LINEAR_V01_R10 | PF_2026-05-11_INFIN_MAP_MPCC_V01_R01 | PF_2026-05-11_INFIN_MAP_MPCC_V01_R02 | PF_2026-05-11_INFIN_MAP_MPCC_V01_R03 | PF_2026-05-11_INFIN_MAP_MPCC_V01_R04 | PF_2026-05-11_INFIN_MAP_MPCC_V01_R05 | PF_2026-05-11_INFIN_MAP_MPCC_V01_R06
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
