Oh-V1G0-Rally/Omnicar_Control_Ros2/[02]Code/omnicar_ws/Test/test_results/RECTANGULAR_test/path_following_tests_summary.csv

parameter | PF_2026-04-27_RECT_MAP_MREFP_V01_R01 | PF_2026-04-27_RECT_MAP_PID_V01_R01 | PF_2026-04-27_RECT_MAP_PONLY_V01_R01 | PF_2026-04-27_RECT_MAP_PONLY_V01_R02 | PF_2026-04-28_RECT_MAP_LINEAR_V01_R01
test_id | PF_2026-04-27_RECT_MAP_MREFP_V01_R01 | PF_2026-04-27_RECT_MAP_PID_V01_R01 | PF_2026-04-27_RECT_MAP_PONLY_V01_R01 | PF_2026-04-27_RECT_MAP_PONLY_V01_R02 | PF_2026-04-28_RECT_MAP_LINEAR_V01_R01
date | 2026-04-27 | 2026-04-27 | 2026-04-27 | 2026-04-27 | 2026-04-28
run_index | R01 | R01 | R01 | R02 | R01
bag_name | PF_2026-04-27_RECT_MAP_MREFP_V01_R01 | PF_2026-04-27_RECT_MAP_PID_V01_R01 | PF_2026-04-27_RECT_MAP_PONLY_V01_R01 | PF_2026-04-27_RECT_MAP_PONLY_V01_R01_01 | PF_2026-04-28_RECT_MAP_LINEAR_V01_R01
path_name | RECT | RECT | RECT | RECT | RECT
frame | MAP | MAP | MAP | MAP | MAP
map_name | FEUP_180x120 | FEUP_180x120 | FEUP_180x120 | FEUP_180x120 | FEUP_180x120
controller_name | PONLY | PID | PONLY | PONLY | PONLY
controller_version | V01 | V01 | V01 | V01 | V01
controller_mode | moving_reference_p |  | moving_reference_p | moving_reference_p | linear_segment
heading_mode | fixed | fixed | fixed | fixed | fixed
desired_speed | 0.35 | 0.35 | 0.35 | 0.35 | 0.35
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
