Oh-V1G0-Rally/Omnicar_Control_Ros2/[02]Code/omnicar_ws/src/5dpo_ratf_driver-main/doc/motors-ctrl-calibration.xlsx

Sheet: 207_deadzone
mot frequency |  | 50 | Hz |  |  |  |  |  |  |  |  |  |  |  | Feedforward analysis
max pwm |  | 255 | (0..1023) |  |  |  |  |  |  |  |  |  |  |  |  | w=K*vmot
enc per rev |  | 2803.2 | (N*Ce) |  |  |  |  |  |  |  |  |  |  |  | v | 2.1891 |  | Kf avg | 0.4562945838
Motion: | v |  |  |  | Motion: | vn |  |  |  | Motion: | w |  |  |  | vn | 2.1729
 |  |  | steady state |  |  |  |  | steady state |  |  |  |  | steady state |  | w | 2.2127
 |  | vmot (V) | enc (tc/cy) | w (rad/s) |  |  | vmot (V) | enc (tc/cy) | w (rad/s) |  |  | vmot (V) | enc (tc/cy) | w (rad/s)
vbatt | pwm | 1 | 1 | 1 | vbatt | pwm | 1 | 1 | 1 | vbatt | pwm | 1 | 1 | 1 | Deadzone analysis
12.15 | 0 | 0 | 0 | 0 | 11.98 | 0 | 0 | 0 | 0 | 11.87 | 0 | 0 | 0 | 0
12.15 | 5 | 0.2382352941 | 0 | 0 | 11.98 | 5 | 0.2349019608 | 0 | 0 | 11.87 | 5 | 0.232745098 | 0 | 0 | (V) | v | vn | w
12.15 | 8 | 0.3811764706 | 0 | 0 | 11.98 | 8 | 0.3758431373 | 0 | 0 | 11.87 | 8 | 0.3723921569 | 0 | 0 | pos | 0.2382352941 | 0.2349019608 | 0.232745098
12.15 | 10 | 0.4764705882 | 0 | 0 | 11.98 | 10 | 0.4698039216 | 0 | 0 | 11.87 | 10 | 0.4654901961 | 0 | 0 | neg | 0.2356862745 | 0.2329411765 | 0.2319607843
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
