Oh-V1G0-Rally/Omnicar_Control_Ros2/[02]Code/omnicar_ws/src/5dpo_ratf_driver-main/bag/ros1/log_tune_batt-11.73_2023-04-25-19-03-44.csv

secs | nsecs | sample_period | pwm | encoder_delta | ticks_per_rev | angular_speed | sample_period | pwm | encoder_delta | ticks_per_rev | angular_speed | sample_period | pwm | encoder_delta | ticks_per_rev | angular_speed | sample_period | pwm | encoder_delta | ticks_per_rev | angular_speed
1682445825 | 670712378 | 0.020024 | 0 | 0 | 2803.2 | 0 | 0.020024 | 0 | 0 | 2803.2 | 0 | 0.020024 | 0 | 0 | 2803.2 | 0 | 0.020024 | 0 | 117 | 2803.2 | 13.11238372
1682445825 | 691227086 | 0.02002 | 0 | -1098 | 2803.2 | -123.054678 | 0.02002 | 0 | 64 | 2803.2 | 7.172585967 | 0.02002 | 0 | -3307 | 2803.2 | -370.6209655 | 0.02002 | 0 | -2303 | 2803.2 | -258.1010232
1682445825 | 711708331 | 0.020024 | 0 | 0 | 2803.2 | 0 | 0.020024 | 0 | 0 | 2803.2 | 0 | 0.020024 | 0 | 0 | 2803.2 | 0 | 0.020024 | 0 | 0 | 2803.2 | 0
1682445825 | 732246816 | 0.020016 | 0 | 0 | 2803.2 | 0 | 0.020016 | 0 | 0 | 2803.2 | 0 | 0.020016 | 0 | 0 | 2803.2 | 0 | 0.020016 | 0 | 0 | 2803.2 | 0
1682445825 | 752758802 | 0.020004 | 0 | 0 | 2803.2 | 0 | 0.020004 | 0 | 0 | 2803.2 | 0 | 0.020004 | 0 | 0 | 2803.2 | 0 | 0.020004 | 0 | 0 | 2803.2 | 0
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
