Oh-V1G0-Rally/Omnicar_Control_Ros2/[02]Code/omnicar_ws/src/5dpo_ratf_driver-main/bag/ros1/log_tune_batt-11.75_2023-04-25-18-58-34.csv

secs | nsecs | sample_period | pwm | encoder_delta | ticks_per_rev | angular_speed | sample_period | pwm | encoder_delta | ticks_per_rev | angular_speed | sample_period | pwm | encoder_delta | ticks_per_rev | angular_speed | sample_period | pwm | encoder_delta | ticks_per_rev | angular_speed
1682445515 | 465702121 | 0 | 0 | 0 | 2803.2 | 0 | 0 | 0 | 0 | 2803.2 | 0 | 0 | 0 | 0 | 2803.2 | 0 | 0 | 0 | 0 | 2803.2 | 0
1682445515 | 486207588 | 0.02002 | 0 | 0 | 2803.2 | 0 | 0.02002 | 0 | 0 | 2803.2 | 0 | 0.02002 | 0 | 0 | 2803.2 | 0 | 0.02002 | 0 | 0 | 2803.2 | 0
1682445515 | 506690889 | 0.02002 | 0 | 0 | 2803.2 | 0 | 0.02002 | 0 | 0 | 2803.2 | 0 | 0.02002 | 0 | 0 | 2803.2 | 0 | 0.02002 | 0 | 0 | 2803.2 | 0
1682445515 | 527240374 | 0.020004 | 0 | 0 | 2803.2 | 0 | 0.020004 | 0 | 0 | 2803.2 | 0 | 0.020004 | 0 | 0 | 2803.2 | 0 | 0.020004 | 0 | 0 | 2803.2 | 0
1682445515 | 547728971 | 0.02002 | 0 | 0 | 2803.2 | 0 | 0.02002 | 0 | 0 | 2803.2 | 0 | 0.02002 | 0 | 0 | 2803.2 | 0 | 0.02002 | 0 | 0 | 2803.2 | 0
1682445515 | 563929941 | 0.020016 | 0 | 0 | 2803.2 | 0 | 0.020016 | 0 | 0 | 2803.2 | 0 | 0.020016 | 0 | 0 | 2803.2 | 0 | 0.020016 | 0 | 0 | 2803.2 | 0
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
