Oh-V1G0-Rally/Omnicar_Control_Ros2/[02]Code/omnicar_ws/src/5dpo_ratf_driver-main/bag/ros1/log_tune_batt-11.79_2023-04-25-18-47-34.csv

secs | nsecs | sample_period | pwm | encoder_delta | ticks_per_rev | angular_speed | sample_period | pwm | encoder_delta | ticks_per_rev | angular_speed | sample_period | pwm | encoder_delta | ticks_per_rev | angular_speed | sample_period | pwm | encoder_delta | ticks_per_rev | angular_speed
1682444855 | 216766609 | 0 | 0 | 0 | 2803.2 | 0 | 0 | 0 | 0 | 2803.2 | 0 | 0 | 0 | 0 | 2803.2 | 0 | 0 | 0 | 0 | 2803.2 | 0
1682444855 | 237298631 | 0.02002 | 0 | 0 | 2803.2 | 0 | 0.02002 | 0 | 0 | 2803.2 | 0 | 0.02002 | 0 | 0 | 2803.2 | 0 | 0.02002 | 0 | 0 | 2803.2 | 0
1682444855 | 257769728 | 0.020024 | 0 | 0 | 2803.2 | 0 | 0.020024 | 0 | 0 | 2803.2 | 0 | 0.020024 | 0 | 0 | 2803.2 | 0 | 0.020024 | 0 | 0 | 2803.2 | 0
1682444855 | 278296362 | 0.02002 | 0 | 0 | 2803.2 | 0 | 0.02002 | 0 | 0 | 2803.2 | 0 | 0.02002 | 0 | 0 | 2803.2 | 0 | 0.02002 | 0 | 0 | 2803.2 | 0
1682444855 | 298850013 | 0.02002 | 0 | 0 | 2803.2 | 0 | 0.02002 | 0 | 0 | 2803.2 | 0 | 0.02002 | 0 | 0 | 2803.2 | 0 | 0.02002 | 0 | 0 | 2803.2 | 0
1682444855 | 319427405 | 0.020036 | 0 | 0 | 2803.2 | 0 | 0.020036 | 0 | 0 | 2803.2 | 0 | 0.020036 | 0 | 0 | 2803.2 | 0 | 0.020036 | 0 | 0 | 2803.2 | 0
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
