Oh-V1G0-Rally/Omnicar_Control_Ros2/[02]Code/omnicar_ws/Test/test_results/comparisons/compare_LIN05_LIN06_/tables/comparison_metrics.csv

test_id | date | path_name | frame | run_index | controller_name | controller_version | desired_speed | common_gamma_start_m | common_gamma_end_m | common_segment_length_m | duration_common_s | samples_common | gamma_min_common_m | gamma_max_common_m | rmse_contouring_m | mae_contouring_m | max_abs_contouring_m | rmse_lag_m | mae_lag_m | max_abs_lag_m | rmse_yaw_ref_rad | max_abs_yaw_ref_rad | source_folder
PF_2026-04-29_INFIN_MAP_LINEAR_V01_R05 | 2026-04-29 | INFIN | MAP | R05 | PONLY | V01 | 0.2 | 0.0038728941519208 | 4.551788073651997 | 4.547915179500076 | 50.13855600357056 | 1601 | 0.0038728941519208 | 4.5509372481086645 | 0.011498004067024612 | 0.008596430804660403 | 0.03667066236445445 | 0.00034303517608615553 | 0.0001838714700684191 | 0.00199678555200857 | 1.8338932024121366 | 3.137956622329538 | /home/c2sr/Omnicar_Control_Ros2/[02]Code/omnicar_ws/Test/test_results/PF_2026-04-29_INFIN_MAP_LINEAR_V01_R05
PF_2026-04-29_INFIN_MAP_LINEAR_V01_R06 | 2026-04-29 | INFIN | MAP | R06 | PONLY | V01 | 0.3 | 0.0038728941519208 | 4.551788073651997 | 4.547915179500076 | 38.85874557495117 | 1203 | 0.0089745864691248 | 4.551788073651997 | 0.025885922316445546 | 0.021040950819288712 | 0.06458135025615595 | 0.0009784763183798215 | 0.000501014496511866 | 0.006282385858701183 | 1.7811494487662654 | 3.1385793519571585 | /home/c2sr/Omnicar_Control_Ros2/[02]Code/omnicar_ws/Test/test_results/PF_2026-04-29_INFIN_MAP_LINEAR_V01_R06
