Oh-V1G0-Rally/Omnicar_Control_Ros2/[02]Code/omnicar_ws/Test/test_results/PF_2026-04-29_INFIN_MAP_LINEAR_V01_R01/metrics/metrics.csv

parameter | value
test_id | PF_2026-04-29_INFIN_MAP_LINEAR_V01_R01
date | 2026-04-29
run_index | R01
bag_name | PF_2026-04-29_INFIN_MAP_LINEAR_V01_R01
path_name | INFIN
frame | MAP
map_name | FEUP_180x120
controller_name | PONLY
controller_version | V01
controller_mode | linear_segment
heading_mode | fixed
desired_speed | 0.2
k_gamma | 0.2
min_gamma_dot | 0.05
max_gamma_dot | 0.2
linear_k_along | 0.4
linear_k_lateral | 1.4
linear_projection_lookahead | 0.0
linear_projection_search_behind | 0.1
linear_projection_search_ahead | 0.6
control_rate_hz | 50.0
debug_publish_rate_hz | 50.0
entry_tolerance_xy | 0.03
path_is_closed | True
stop_at_end | False
kp_x | 0.5
ki_x | 0.0
kd_x | 0.0
kp_y | 0.5
ki_y | 0.0
kd_y | 0.0
kp_yaw | 0.5
ki_yaw | 0.0
kd_yaw | 0.0
max_linear_x | 0.25
max_linear_y | 0.25
max_angular_z | 0.25
max_integral_x | 0.15
max_integral_y | 0.15
max_integral_yaw | 0.2
duration_s | 36.65723705291748
samples | 1167
dt_mean_s | 0.03143845373320538
path_length_real_m | 7.41204085502983
gamma_final_m | 1.8739006894954688
gamma_progress_ratio | 0.4114261035567205
rmse_x_m | 0.018526767924747632
rmse_y_m | 0.01984144389630106
rmse_tracking_error_norm_m | 0.027146344608943582
mean_tracking_error_norm_m | 0.02314900901398471
max_tracking_error_norm_m | 0.05545559829672815
rmse_yaw_rad | 0.00820580731687407
rmse_error_along_m | 0.00047069317792343857
mean_abs_error_along_m | 8.87875790133174e-05
max_abs_error_along_m | 0.005235093481141786
iae_error_along | 0.0033049606179193216
max_abs_error_yaw_rad | 0.02648718713193432
sat_vx_ratio | 0.0
sat_vy_ratio | 0.0
sat_w_ratio | 0.0
result_folder | /home/c2sr/Omnicar_Control_Ros2/[02]Code/omnicar_ws/Test/test_results/PF_2026-04-29_INFIN_MAP_LINEAR_V01_R01
analysis_timestamp | 2026-04-29T14:49:10
notes
