Oh-V1G0-Rally/Omnicar_Control_Ros2/[02]Code/omnicar_ws/Test/test_results/comparisons/compare_LIN05_LIN06/tables/comparison_metrics.csv

test_id | date | path_name | frame | run_index | controller_name | controller_version | desired_speed | common_gamma_start_m | common_gamma_end_m | common_segment_length_m | duration_common_s | samples_common | gamma_min_common_m | gamma_max_common_m | rmse_contouring_m | mae_contouring_m | max_abs_contouring_m | rmse_lag_m | mae_lag_m | max_abs_lag_m | rmse_yaw_ref_rad | max_abs_yaw_ref_rad | source_folder
PF_2026-04-29_INFIN_MAP_LINEAR_V01_R08 | 2026-04-29 | INFIN | MAP | R08 | PONLY | V01 | 0.4 | 0.0147988110616252 | 4.552137775119653 | 4.537338964058028 | 27.39162755012512 | 850 | 0.0195287369836724 | 4.545037282305566 | 0.03542048158965375 | 0.02996513390299739 | 0.07716532264439321 | 0.0008174799237487331 | 0.000508764309364751 | 0.0035135133204140315 | 1.798458341790595 | 3.138924341464499 | /home/c2sr/Omnicar_Control_Ros2/[02]Code/omnicar_ws/Test/test_results/PF_2026-04-29_INFIN_MAP_LINEAR_V01_R08
PF_2026-04-29_INFIN_MAP_LINEAR_V01_R10 | 2026-04-29 | INFIN | MAP | R10 | PONLY | V01 | 0.5 | 0.0147988110616252 | 4.552137775119653 | 4.537338964058028 | 22.580353260040283 | 716 | 0.0147988110616252 | 4.552137775119653 | 0.046936640113354675 | 0.039180220897719636 | 0.11661059143409702 | 0.0010695435105568891 | 0.0006320533774790912 | 0.007338246772727618 | 1.7947805316019356 | 3.139327464679072 | /home/c2sr/Omnicar_Control_Ros2/[02]Code/omnicar_ws/Test/test_results/PF_2026-04-29_INFIN_MAP_LINEAR_V01_R10
