Oh-V1G0-Rally/Omnicar_Control_Ros2/[02]Code/omnicar_ws/Test/test_results/comparisons/compare_LIN05_MPC06/tables/comparison_metrics.csv

test_id | date | path_name | frame | run_index | controller_name | controller_version | desired_speed | common_gamma_start_m | common_gamma_end_m | common_segment_length_m | duration_common_s | samples_common | gamma_min_common_m | gamma_max_common_m | rmse_contouring_m | mae_contouring_m | max_abs_contouring_m | rmse_lag_m | mae_lag_m | max_abs_lag_m | rmse_yaw_ref_rad | max_abs_yaw_ref_rad | source_folder
PF_2026-04-29_INFIN_MAP_LINEAR_V01_R10 | 2026-04-29 | INFIN | MAP | R10 | PONLY | V01 | 0.5 | 0.0158125036689934 | 4.549593820074571 | 4.533781316405578 | 22.580353260040283 | 713 | 0.0347030606618488 | 4.542229091956256 | 0.04690633071306227 | 0.039124066263348356 | 0.11661059143409702 | 0.0010713619688426526 | 0.0006331988294462459 | 0.007338246772727618 | 1.7949349279227893 | 3.139327464679072 | /home/c2sr/Omnicar_Control_Ros2/[02]Code/omnicar_ws/Test/test_results/PF_2026-04-29_INFIN_MAP_LINEAR_V01_R10
PF_2026-05-11_INFIN_MAP_MPCC_V01_R06 | 2026-05-11 | INFIN | MAP | R06 | MPCC | V01 |  | 0.0158125036689934 | 4.549593820074571 | 4.533781316405578 | 21.52882170677185 | 324 | 0.0158125036689934 | 4.549593820074571 | 0.03298488376415203 | 0.025657696239881633 | 0.07047303412384434 | 0.11053578398070116 | 0.10394758740749574 | 0.20293361648132233 | 1.8802253576994556 | 3.132862207329259 | /home/c2sr/Omnicar_Control_Ros2/[02]Code/omnicar_ws/Test/test_results/PF_2026-05-11_INFIN_MAP_MPCC_V01_R06
