Oh-V1G0-Rally/Omnicar_Control_Ros2/[02]Code/omnicar_ws/Test/test_results/comparisons/path_following_comparison_20260518_105113/tables/comparison_metrics.csv

test_id | date | path_name | frame | run_index | controller_name | controller_version | desired_speed | max_linear_x | max_linear_y | max_angular_z | duration_s | path_length_real_m | gamma_progress_ratio | rmse_x_m | rmse_y_m | max_abs_error_x_m | max_abs_error_y_m | rmse_tracking_error_norm_m | mean_tracking_error_norm_m | max_tracking_error_norm_m | rmse_error_along_m | mean_abs_error_along_m | max_abs_error_along_m | rmse_yaw_rad | max_abs_error_yaw_rad | sat_vx_ratio | sat_vy_ratio | sat_w_ratio | source_folder | saturation_ratio_max | comparison_score
PF_2026-05-11_INFIN_MAP_MPCC_V01_R06 | 2026-05-11 | INFIN | MAP | R06 | MPCC | V01 |  | 0.7 | 0.7 | 0.8 | 21.52882170677185 | 6.283613009969075 | 0.9754330816487645 | 0.06773823823074031 | 0.09336858775069012 | 0.14468063201469378 | 0.2018987311476521 | 0.1153523389323461 | 0.10846562424431125 | 0.21018850199533756 | 0.11043012454747791 | 0.10383382669414144 | 0.20318302432875768 | 0.029426096236347895 | 0.07100337256512292 | 0.0 | 0.0 | 0.0 | /home/c2sr/Omnicar_Control_Ros2/[02]Code/omnicar_ws/Test/test_results/PF_2026-05-11_INFIN_MAP_MPCC_V01_R06 | 0.0 | 0.19688029721786815
PF_2026-04-29_INFIN_MAP_LINEAR_V01_R10 | 2026-04-29 | INFIN | MAP | R10 | PONLY | V01 | 0.5 | 0.55 | 0.55 | 0.4 | 22.580353260040283 | 11.623673583745774 | 0.47933356141227235 | 0.03958562008727682 | 0.025242242189578504 | 0.1104170202128365 | 0.08920966394860491 | 0.046948824356436776 | 0.03919053604609415 | 0.11661288394062184 | 0.0009208271260596342 | 0.00019551051392938075 | 0.010355322067952817 | 0.03235259834957945 | 0.07449003654885589 | 0.23044692737430167 | 0.19553072625698323 | 0.0 | /home/c2sr/Omnicar_Control_Ros2/[02]Code/omnicar_ws/Test/test_results/PF_2026-04-29_INFIN_MAP_LINEAR_V01_R10 | 0.23044692737430167 | 0.6868169044080138
