Oh-V1G0-Rally/Omnicar_Control_Ros2/[00] Documentation/Thesis_Alessandro/IMG/ROS/cmd_test1.png

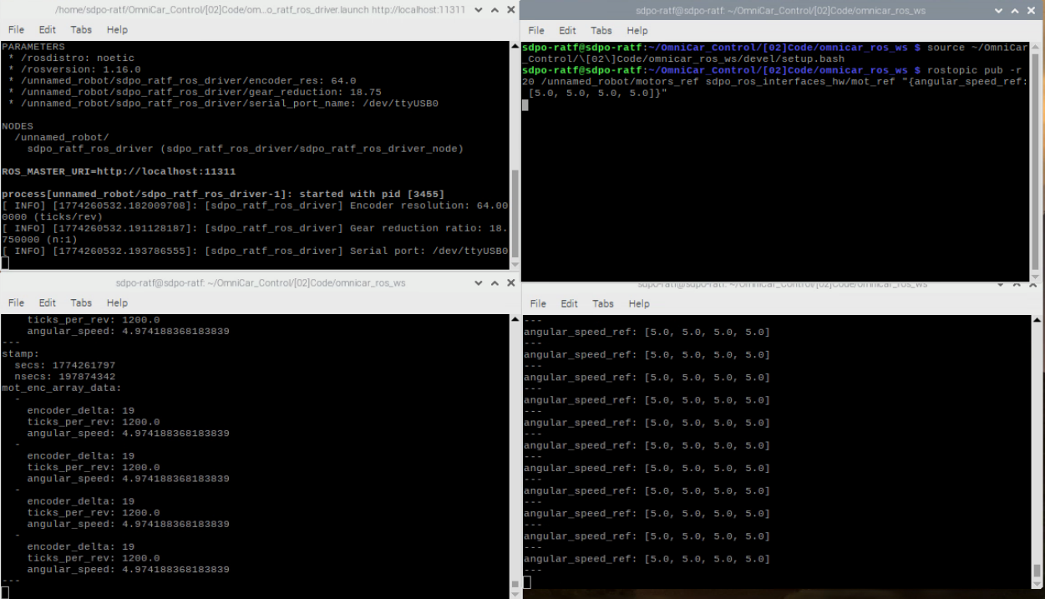
[00] Documentation/Thesis_Alessandro/IMG/ROS/cmd_test1.png
