Oh-V1G0-Rally/Omnicar_Control_Ros2/[00] Documentation/Thesis_Alessandro/IMG/ROS/TEST5_position.png

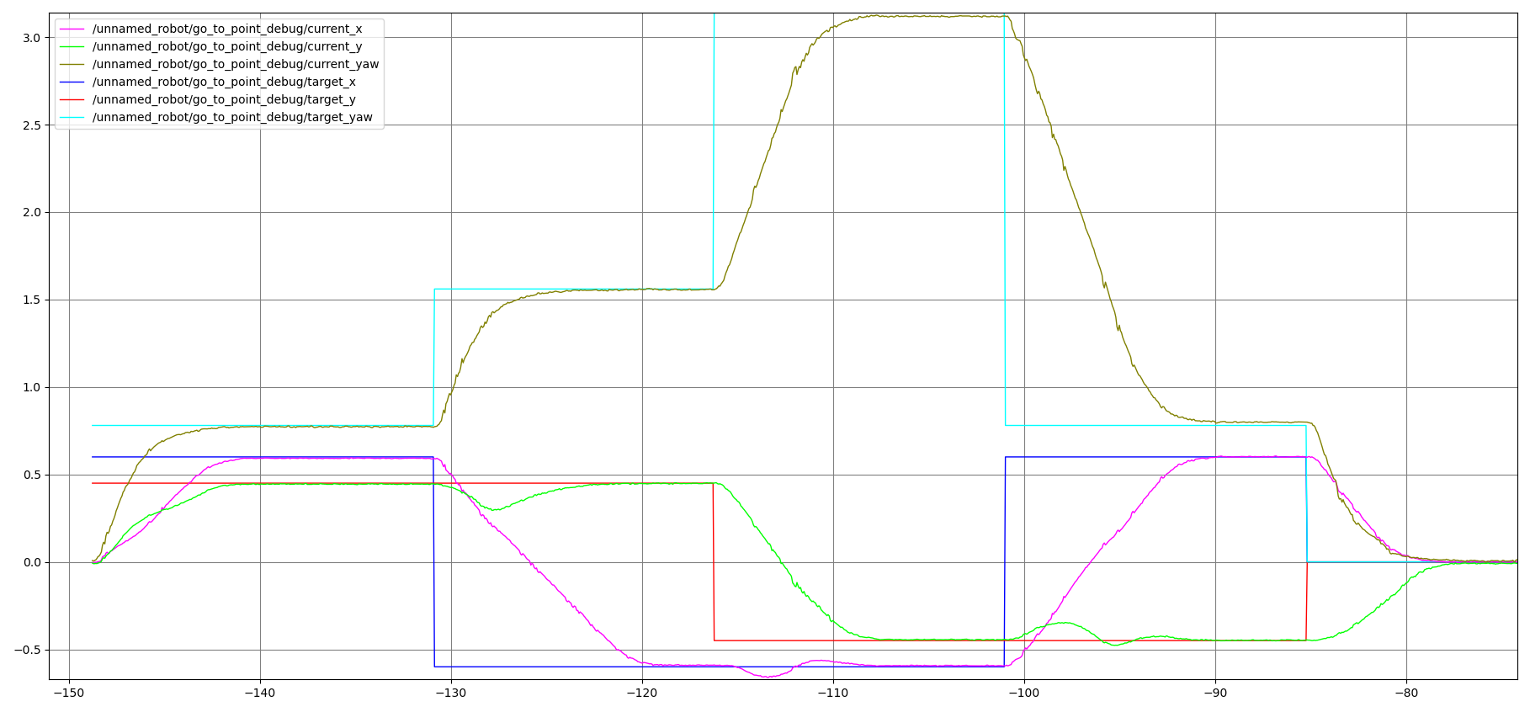
[00] Documentation/Thesis_Alessandro/IMG/ROS/TEST5_position.png
