Oh-V1G0-Rally/Omnicar_Control_Ros2/[00] Documentation/Thesis_Alessandro/IMG/ROS/TEST5_position_error.png

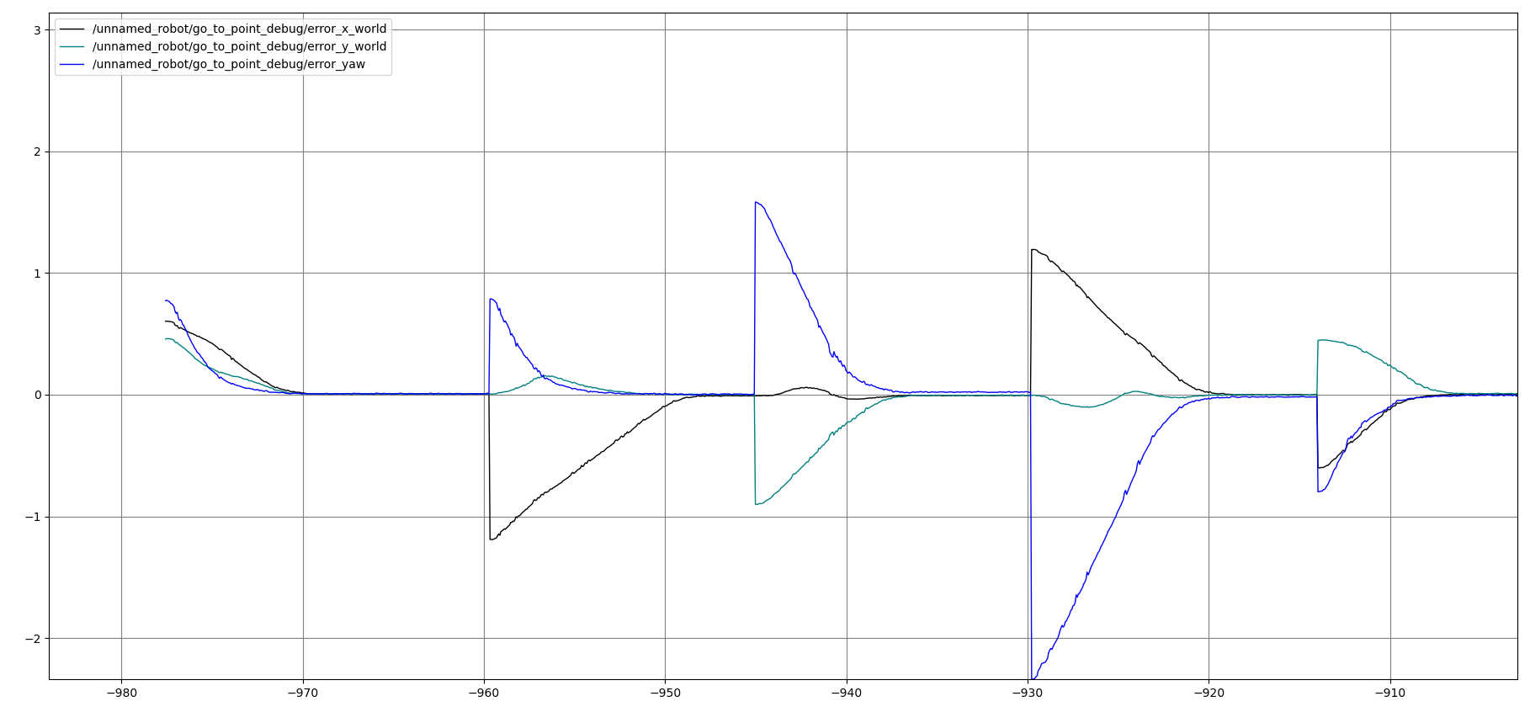
[00] Documentation/Thesis_Alessandro/IMG/ROS/TEST5_position_error.png
