Oh-V1G0-Rally/Omnicar_Control_Ros2/[02]Code/omnicar_ws/Test/test_results/comparisons/compare_MPC05_MPC06/figures/map_xp.png

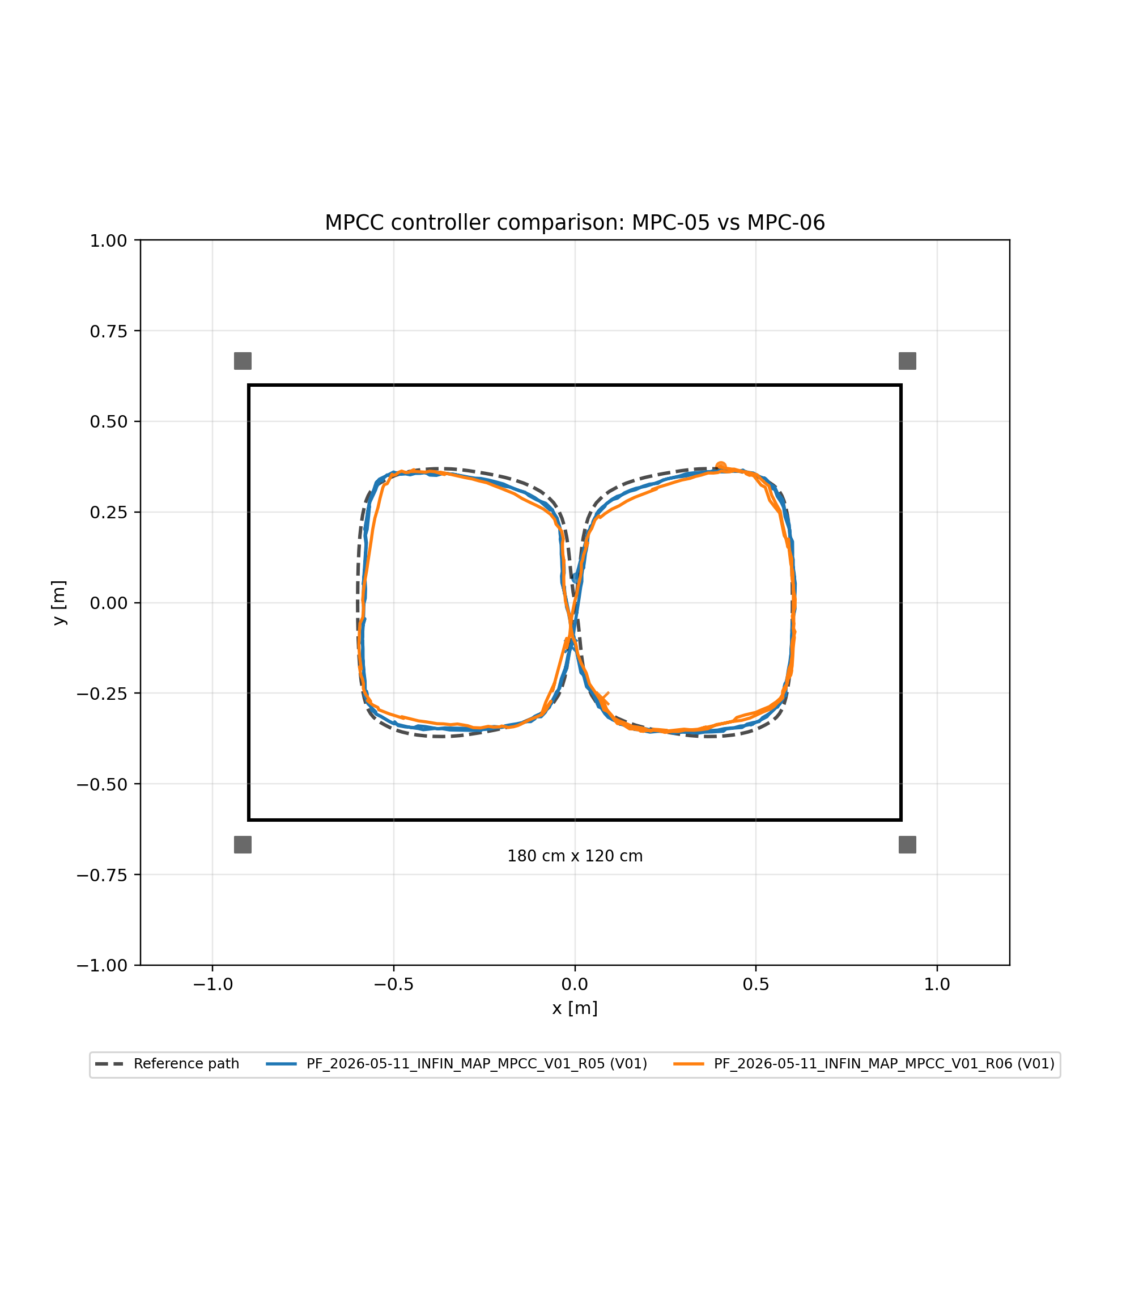
[02]Code/omnicar_ws/Test/test_results/comparisons/compare_MPC05_MPC06/figures/map_xp.png
