Oh-V1G0-Rally/Omnicar_Control_Ros2/[02]Code/omnicar_ws/Test/test_results/comparisons/final_common_segment/figures/compare_MPC05_MPC06.png

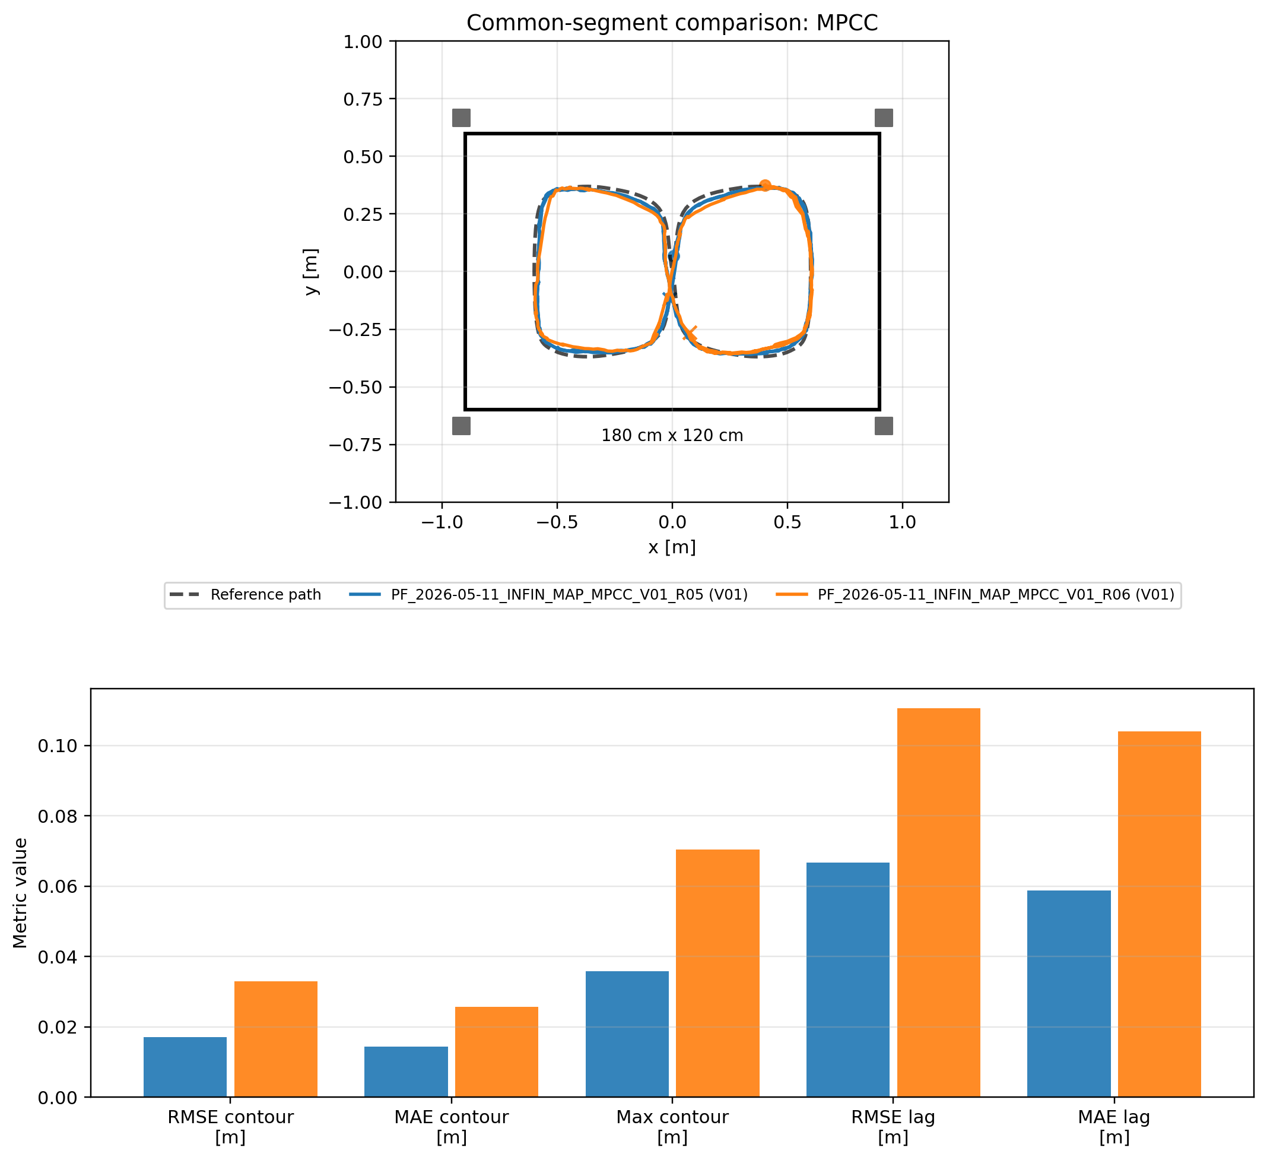
[02]Code/omnicar_ws/Test/test_results/comparisons/final_common_segment/figures/compare_MPC05_MPC06.png
