Oh-V1G0-Rally/Omnicar_Control_Ros2/[00] Documentation/Thesis_Alessandro/IMG/ROS/GoToPoint_test_Draw.pdf

x

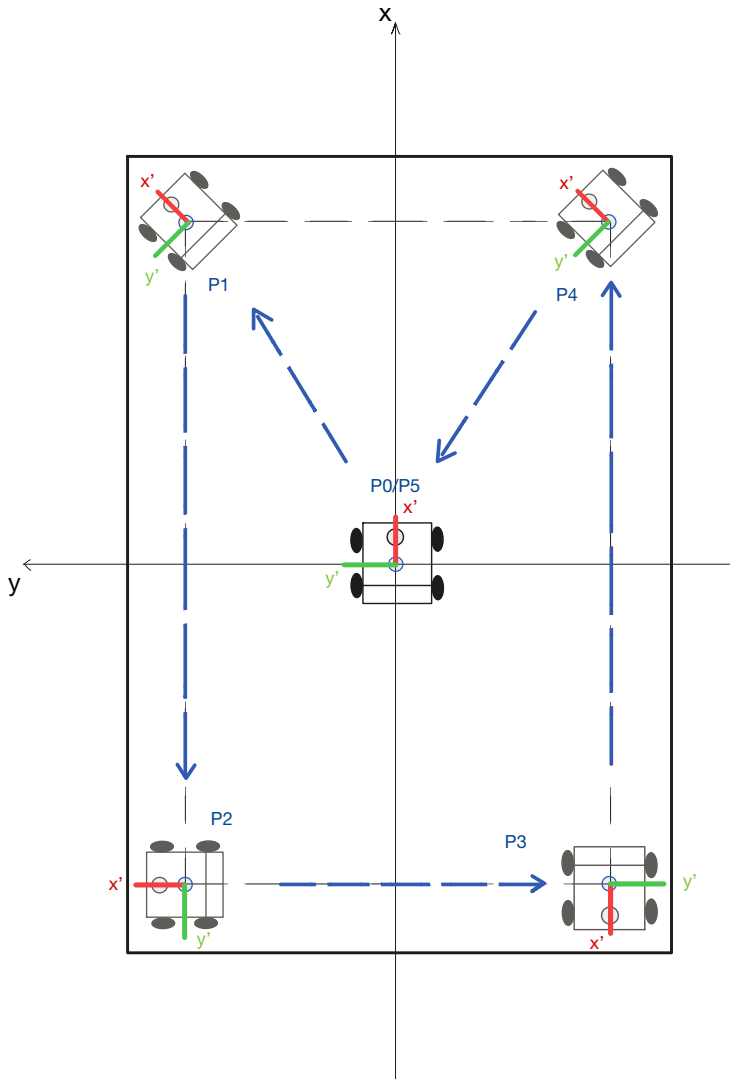
[picture p226: page 1]
