Oh-V1G0-Rally/Omnicar_Control_Ros2/[02]Code/omnicar_ws/src/5dpo_ratf_driver-main/src/sdpo_ratf_driver/Robot5dpoRatf.cpp

#include "sdpo_ratf_driver/Robot5dpoRatf.h"

#include <exception>
#include <utility>
#include <vector>





namespace sdpo_ratf_driver
{



const unsigned int kSerialBaudRate = 115200;
const auto kSerialDataBits = boost::asio::serial_port_base::character_size(8);
const auto kSerialStopBits = boost::asio::serial_port_base::stop_bits::one;
const auto kSerialParity = boost::asio::serial_port_base::parity::none;
const auto kSerialFlowCtrl = boost::asio::serial_port_base::flow_control::none;





void Motor::setEncoderRes(const double& enc_res)
{

  if (enc_res <= 0)
  {
    throw std::invalid_argument(
        "[Robot5dpoRatf.cpp] Motor::setEncoderRes: "
        "resolution of the encoder must be greater than 0 (enc ticks / rev)");
  }

  encoder_res = enc_res;

} // void Motor::setEncoderRes(const double& enc_res)





void Motor::setGearReduction(const double& gear_ratio)
{

  if (gear_ratio <= 0)
  {
    throw std::invalid_argument(
        "[Robot5dpoRatf.cpp] Motor::setGearReduction: "
        "gear reduction ratio of the motor must be greater than 0 ([n:1])");
  }

  gear_reduction = gear_ratio;

} // void Motor::setGearReduction(const double& gear_ratio)





void Motor::setEncTicksDelta(const int32_t& delta_enc_ticks)
{
  enc_ticks_delta = delta_enc_ticks;
  enc_ticks_delta_pub += enc_ticks_delta;
  enc_ticks_prev = enc_ticks;
  enc_ticks += enc_ticks_delta;
  setW();
} // void Motor::setEncTicksDelta(const int32_t& delta_enc_ticks)





void Motor::setEncTicks(const int32_t& total_enc_ticks)
{
  enc_ticks_prev = enc_ticks;
  enc_ticks = total_enc_ticks;
  enc_ticks_delta = enc_ticks - enc_ticks_prev;
  enc_ticks_delta_pub += enc_ticks_delta;
  setW();
} // void Motor::setEncTicks(const int32_t& total_enc_ticks)





double Motor::getEncTicksDeltaPub()
{
  double pub_delta = enc_ticks_delta_pub;
  enc_ticks_delta_pub = 0;
  return pub_delta;
} // double Motor::getEncTicksDeltaPub()





void Motor::setPWM(const int16_t& pwm_mot)
{
  if (pwm_mot > max_mot_pwm)
  {
    pwm = max_mot_pwm;
  }
  else if (pwm_mot < -max_mot_pwm)
  {
    pwm = -max_mot_pwm;
  }
  else
  {
    pwm = pwm_mot;
  }
} // void Motor::setPWM(const int16_t& pwm_mot)





void Motor::setWr(const double& w_ref)
{
  w_r = w_ref;
} // void Motor::setWr(const double& w_ref)





void Motor::setSampleTime(const int32_t& time_sample)
{
  sample_time_prev = sample_time;
  sample_time = static_cast<double>(((float) time_sample) / 1.0e6); // us > s
  sample_period = sample_time - sample_time_prev;
} // void Motor::setSampleTime(const int32_t& time_sample)





void Motor::reset()
{
  enc_ticks = 0;
  enc_ticks_prev = 0;
  enc_ticks_delta = 0;
  enc_ticks_delta_pub = 0;
  pwm = 0;
  w_r = 0;
  w = 0;
  sample_time = 0;
  sample_time_prev = 0;
  sample_period = 0;
} // void Motor::reset()





void Motor::setW()
{
  w = 2 * M_PI * enc_ticks_delta * mot_ctrl_freq /
      (gear_reduction * encoder_res);
} // void Motor::setW()





Robot5dpoRatf::Robot5dpoRatf()
    : serial_port_name_("/dev/omnicar_esp32") , serial_async_(nullptr)
{
  serial_cfg_ = InitCommunications();
} // Robot5dpoRatf::Robot5dpoRatf()





Robot5dpoRatf::Robot5dpoRatf(std::string serial_port_name)
    : serial_port_name_(std::move(serial_port_name)),
      serial_async_(nullptr)
{
  serial_cfg_ = InitCommunications();
} // Robot5dpoRatf::Robot5dpoRatf(std::string serial_port_name)





Robot5dpoRatf::~Robot5dpoRatf()
{
  closeSerial();
} // Robot5dpoRatf::~Robot5dpoRatf()





void Robot5dpoRatf::init()
{
  reset();

  if (isSerialOpen())
  {
    sendSerialData();
  }
} // void Robot5dpoRatf::init()





bool Robot5dpoRatf::openSerial(const bool dbg)
{
  try {
    serial_async_ = new CallbackAsyncSerial(
        serial_port_name_, kSerialBaudRate,
        boost::asio::serial_port_base::parity(kSerialParity),
        kSerialDataBits,
        boost::asio::serial_port_base::flow_control(kSerialFlowCtrl),
        boost::asio::serial_port_base::stop_bits(kSerialStopBits));
    serial_async_->setCallback(
        std::bind(&Robot5dpoRatf::rcvSerialData, this,
                  std::placeholders::_1, std::placeholders::_2));
    return true;
  }
  catch (boost::system::system_error& e)
  {
    serial_async_ = nullptr;
    if (dbg)
    {
      std::cerr << "[Robot5dpoRatf.cpp] Robot5dpoRatf::openSerial: "
                   "Error when opening the serial device "
                << serial_port_name_ << std::endl;
    }
    return false;
  }
} // bool Robot5dpoRatf::openSerial(const bool dbg)





void Robot5dpoRatf::closeSerial(const bool dbg)
{
  if (serial_async_)
  {
    try
    {
      serial_async_->close();
    }
    catch(...)
    {
      if (dbg)
      {
        std::cerr << "[Robot5dpoRatf.cpp] Robot5dpoRatf::closeSerial: "
                     "Error when closing the serial device "
                  << serial_port_name_ << std::endl;
      }
    }
    delete serial_async_;
  }
} // void Robot5dpoRatf::closeSerial(const bool dbg)





bool Robot5dpoRatf::isSerialOpen()
{
  return serial_async_ ?
         !(serial_async_->errorStatus() || (!serial_async_->isOpen())) : false;
} // bool Robot5dpoRatf::isSerialOpen()





void Robot5dpoRatf::setSerialPortName(const std::string& serial_port_name)
{
  serial_port_name_ = serial_port_name;
} // void Robot5dpoRatf::setSerialPortName(const std::string& serial_port_name)





void Robot5dpoRatf::reset()
{
  for(auto& m : mot)
  {
    m.reset();
  }
} // void Robot5dpoRatf::reset()





void Robot5dpoRatf::stopMotors()
{
  for(auto& m : mot)
  {
    m.w_r = 0;
  }
} // void Robot5dpoRatf::stopMotors()





void Robot5dpoRatf::rcvSerialData(const char *data, unsigned int len)
{
  std::vector<char> vec(data, data + len);
  char channel;

  for(auto& c : vec)
  {
    if (!((c < 32) || (c >= 0x7f)))   // ignore non-ascii char
    {
      channel = ProcessChannelsSerialData(c);

      if (channel > 0)
      {
        switch (channel)
        {
        case 'g':
          sendSerialData();

          if (run)
          {
            run();
          }

          mtx_.lock();
          mot[0].setEncTicks(serial_cfg_->channel_g);
          mtx_.unlock();
          break;

        case 'h':
          mtx_.lock();
          mot[1].setEncTicks(serial_cfg_->channel_h);
          mtx_.unlock();
          break;

        case 'i':
          mtx_.lock();
          mot[2].setEncTicks(serial_cfg_->channel_i);
          mtx_.unlock();
          break;

        case 'j':
          mtx_.lock();
          mot[3].setEncTicks(serial_cfg_->channel_j);
          mtx_.unlock();
          break;

        case 'k':
          mtx_.lock();
          for(auto& m : mot)
          {
            m.setSampleTime(serial_cfg_->channel_k);
          }
          mtx_.unlock();
          break;

        case 'r':
          mtx_.lock();
          reset();
          mtx_.unlock();
          break;

        case 's':
          mtx_.lock();
          switch_1_state = (serial_cfg_->channel_s == 0);
          mtx_.unlock();
          break;

        case 't':
          mtx_.lock();
          switch_2_state = (serial_cfg_->channel_t == 0);
          mtx_.unlock();
          break;

        default:
          break;
        }
      }
    }
  }
} // void Robot5dpoRatf::rcvSerialData(const char *data, unsigned int len)





void Robot5dpoRatf::sendSerialData()
{
  mtx_.lock();
  serial_cfg_->channel_G = static_cast<float>(mot[0].w_r);
  serial_cfg_->channel_H = static_cast<float>(mot[1].w_r);
  serial_cfg_->channel_I = static_cast<float>(mot[2].w_r);
  serial_cfg_->channel_J = static_cast<float>(mot[3].w_r);
  serial_cfg_->channel_L = solenoid_1_state? 1 : 0;
  serial_cfg_->channel_M = solenoid_2_state? 1 : 0;
  mtx_.unlock();

  serial_async_->writeString(SendChannel('G'));
  serial_async_->writeString(SendChannel('H'));
  serial_async_->writeString(SendChannel('I'));
  serial_async_->writeString(SendChannel('J'));
  serial_async_->writeString(SendChannel('L'));
} // void Robot5dpoRatf::sendSerialData()



} // namespace sdpo_ratf_driver
