Oh-V1G0-Rally/Omnicar_Control_Ros2/[02]Code/omnicar_ws/src/Path-Following-main/config/no_noise.yaml

## sim parameters
dt_sim: 0.0001
dt_control: 0.01
controller_type: "NLC"
v_min : 0.5
v_max : 5
w_max : 200
w_delta_lim: 50
accel : 3.5
deaccel : -28
wheel_radius : 0.025
robot_diameter : 0.095
y_init : 0.05
x_limit: 10
side : -1 #-1 for right side 1 for left side


## motor parameters
motor_gain: 64.50
gain_mismatch: 0
motor_time_constant: 0.1
time_constant_mismatch: 0.02
measurement_bias: 0
measurement_std: 0
closed_loop_constant: 0.1
max_delta_u : 11.1
max_u: 11.1
kf_percentage: 0.66

## Classic Controllers Parameters
k_nlc : 3
b_smc : 1
gamma : 0.5
ktheta : 14.14
kd_theta : 2
td_y : 0.116
ki : 5
## PPO

ppo_w : 1
model_path : "model/PPO.zip"
