Oh-V1G0-Rally/Omnicar_Control_Ros2/[02]Code/omnicar_ws/src/5dpo_ratf_driver-main/include/sdpo_ratf_driver/SdpoRatfTuneDriverROS2.h

#pragma once

#include <rclcpp/rclcpp.hpp>
#include <sdpo_drivers_interfaces/msg/mot_data_array.hpp>
#include <sdpo_drivers_interfaces/msg/mot_ref_array.hpp>
#include <sdpo_drivers_interfaces/srv/set_motors_pwm.hpp>
#include <std_msgs/msg/bool.hpp>
#include <std_srvs/srv/set_bool.hpp>

#include "sdpo_ratf_driver/Robot5dpoRatfTune.h"





namespace sdpo_ratf_driver
{



class SdpoRatfTuneDriverROS2 : public rclcpp::Node
{

 private:

  rclcpp::Publisher<sdpo_drivers_interfaces::msg::MotDataArray>::SharedPtr pub_mot_data_;
  rclcpp::Publisher<std_msgs::msg::Bool>::SharedPtr                        pub_switch_1_;
  rclcpp::Publisher<std_msgs::msg::Bool>::SharedPtr                        pub_switch_2_;
  rclcpp::Subscription<sdpo_drivers_interfaces::msg::MotRefArray>::SharedPtr sub_mot_ref_;

  rclcpp::Service<sdpo_drivers_interfaces::srv::SetMotorsPWM>::SharedPtr srv_motors_pwm_;

  rclcpp::Service<std_srvs::srv::SetBool>::SharedPtr srv_solenoid_1_;
  rclcpp::Service<std_srvs::srv::SetBool>::SharedPtr srv_solenoid_2_;

  rclcpp::TimerBase::SharedPtr serial_port_timer_;

  rclcpp::Time sample_time_;

  Robot5dpoRatfTune rob_;

  double encoder_res_;
  double gear_reduction_;
  std::string serial_port_name_;

  int mot_ctrl_freq_;
  int max_mot_pwm_;

  bool serial_comms_first_fault_;



 public:

  SdpoRatfTuneDriverROS2();
  ~SdpoRatfTuneDriverROS2() = default;

 private:

  void getParam();

  void checkSerialComms();

  void run();

  void pubMotData();
  void pubSwitch();
  void subMotRef(
      const sdpo_drivers_interfaces::msg::MotRefArray::SharedPtr msg);

  void srvMotorsPWM(const std::shared_ptr<sdpo_drivers_interfaces::srv::SetMotorsPWM::Request> request,
                    const std::shared_ptr<sdpo_drivers_interfaces::srv::SetMotorsPWM::Response> response);
  void srvSolenoid1(const std::shared_ptr<std_srvs::srv::SetBool::Request> request,
                    const std::shared_ptr<std_srvs::srv::SetBool::Response> response);
  void srvSolenoid2(const std::shared_ptr<std_srvs::srv::SetBool::Request> request,
                    const std::shared_ptr<std_srvs::srv::SetBool::Response> response);

};// class SdpoRatfTuneDriverROS2 : public rclcpp::Node



} // namespace sdpo_ratf_driver
