Oh-V1G0-Rally/Omnicar_Control_Ros2/[02]Code/omnicar_ws/src/5dpo_ratf_driver-main/include/sdpo_ratf_driver/Robot5dpoRatfTune.h

#pragma once

#include "sdpo_ratf_driver/Robot5dpoRatf.h"





namespace sdpo_ratf_driver
{



class Robot5dpoRatfTune : public Robot5dpoRatf
{

 public:

  Robot5dpoRatfTune();
  Robot5dpoRatfTune(std::string serial_port_name);

  void stopMotors() final;

 protected:

  void sendSerialData() final;

};// class Robot5dpoRatfTune : public Robot5dpoRatf



} // namespace sdpo_ratf_driver
