Oh-V1G0-Rally/Omnicar_Control_Ros2/[02]Code/Omnicar/include/CtrlPID.h

#ifndef CTRLPID_H
#define CTRLPID_H

#include <Arduino.h>





class CtrlPID
{
 public:
  bool active;
  float kp, ki, kd, kf;
  float w, w_ref;
  float e, e_prev, e_sum;
  float dt;
  float m, m_max;
  float hamm_vd, hamm_v0;

 public:
  void update(float new_w);
  void reset(void);

  void enable(bool e);

 private:
  void hammerstein(float &mmot);
};





#endif
