Oh-V1G0-Rally/Omnicar_Control_Ros2/[02]Code/omnicar_ws/src/sdpo_ros_odom/src/main_wh.cpp

#include <memory>

#include <rclcpp/rclcpp.hpp>

#include "sdpo_ros_odom/OdomWhROS2.h"

int main(int argc, char ** argv)
{
  rclcpp::init(argc, argv);
  rclcpp::spin(std::make_shared<sdpo_ros_odom::OdomWhROS2>());
  rclcpp::shutdown();
  return 0;
}
