Oh-V1G0-Rally/Omnicar_Control_Ros2/[02]Code/omnicar_ws/src/5dpo_ratf_driver-main/src/sdpo_ratf_driver/SerialChannelsConfig.cpp

#include "sdpo_ratf_driver/SerialChannelsConfig.h"





SerialChannelsConfig serial_channels_config_;





SerialChannelsConfig* InitCommunications()
{
  AddValueToChannel_int32_t('g', &serial_channels_config_.channel_g);
  AddValueToChannel_int32_t('h', &serial_channels_config_.channel_h);
  AddValueToChannel_int32_t('i', &serial_channels_config_.channel_i);
  AddValueToChannel_int32_t('j', &serial_channels_config_.channel_j);
  AddValueToChannel_int32_t('k', &serial_channels_config_.channel_k);
  AddValueToChannel_int32_t('s', &serial_channels_config_.channel_s);
  AddValueToChannel_int32_t('t', &serial_channels_config_.channel_t);

  AddValueToChannel_float('G', &serial_channels_config_.channel_G);
  AddValueToChannel_float('H', &serial_channels_config_.channel_H);
  AddValueToChannel_float('I', &serial_channels_config_.channel_I);
  AddValueToChannel_float('J', &serial_channels_config_.channel_J);
  AddValueToChannel_int32_t('K', &serial_channels_config_.channel_K);
  AddValueToChannel_int32_t('L', &serial_channels_config_.channel_L);
  AddValueToChannel_int32_t('M', &serial_channels_config_.channel_M);

  return &serial_channels_config_;
}
