Oh-V1G0-Rally/Omnicar_Control_Ros2/[02]Code/omnicar_ws/Test/test_results/RECTANGULAR_test/PF_2026-04-27_RECT_MAP_PI_V01_R01/test_info.yaml

test:
  test_id: PF_2026-04-27_RECT_MAP_PID_V01_R01
  test_type: path_following
  date: '2026-04-27'
  run_index: R01
  notes: ''
input:
  bag_name: PF_2026-04-27_RECT_MAP_PID_V01_R01
  bag_folder: /home/c2sr/Omnicar_Control_Ros2/[02]Code/omnicar_ws/bags/PF_2026-04-27_RECT_MAP_PID_V01_R01
  bag_file: PF_2026-04-27_RECT_MAP_PID_V01_R01_0.mcap
  rosbag_metadata_file: metadata.yaml
  debug_topic: /omnicar/path_follower_debug
scenario:
  path_name: RECT
  path_file: /home/c2sr/Omnicar_Control_Ros2/[02]Code/omnicar_ws/src/splines/FEUP/FEUP_rectangle.csv
  frame: MAP
  map_name: FEUP_180x120
  map_width_m: 1.8
  map_height_m: 1.2
  pillars:
  - - 0.9175
    - 0.6675
  - - -0.9175
    - 0.6675
  - - 0.9175
    - -0.6675
  - - -0.9175
    - -0.6675
controller:
  controller_name: PID
  controller_version: V01
  heading_mode: fixed
  desired_speed: 0.35
  k_gamma: 0.5
  min_gamma_dot: 0.0
  max_gamma_dot: 0.38
  control_rate_hz: 50.0
  debug_publish_rate_hz: 20.0
  entry_tolerance_xy: 0.03
  path_is_closed: true
  stop_at_end: false
  kp_x: 0.8
  ki_x: 0.03
  kd_x: 0.0
  kp_y: 0.9
  ki_y: 0.06
  kd_y: 0.0
  kp_yaw: 0.5
  ki_yaw: 0.0
  kd_yaw: 0.0
  max_linear_x: 0.4
  max_linear_y: 0.4
  max_angular_z: 0.35
  max_integral_x: 0.15
  max_integral_y: 0.15
  max_integral_yaw: 0.2
  debug_topic: /omnicar/path_follower_debug
analysis:
  analysis_timestamp: '2026-04-27T13:28:12'
  analysis_code_version: '1.0'
  analysis_config_file: /home/c2sr/Omnicar_Control_Ros2/[02]Code/omnicar_ws/Test/test_code/config/analysis_config.yaml
  yaw_arrow_stride: 15
  unwrap_yaw: true
  output_folder: /home/c2sr/Omnicar_Control_Ros2/[02]Code/omnicar_ws/Test/test_results/PF_2026-04-27_RECT_MAP_PID_V01_R01
outputs:
  raw_debug_csv: raw/path_follower_debug.csv
  raw_path_csv: raw/path_reference.csv
  xy_figure: figures/01_xy_map.png
  tracking_figure: figures/02_target_tracking_and_errors.png
  metrics_figure: figures/03_metrics_summary.png
  local_metrics_csv: metrics/metrics.csv
  local_metrics_json: metrics/metrics.json
summary_metrics:
  duration_s: 20.419933795928955
  samples: 639
  dt_mean_s: 0.03200616582434006
  path_length_real_m: 6.689787034694765
  gamma_final_m: 2.566396922966722
  gamma_progress_ratio: 0.6110468864206481
  rmse_x_m: 0.0484094669049383
  rmse_y_m: 0.05989299299681428
  rmse_yaw_rad: 0.014986619610535504
  rmse_error_along_m: 0.06752810112909796
  mean_abs_error_along_m: 0.0608838281856116
  max_abs_error_along_m: 0.11651801444932817
  iae_error_along: 1.2438463488215463
  max_abs_error_yaw_rad: 0.0336744922538994
  sat_vx_ratio: 0.0
  sat_vy_ratio: 0.0
  sat_w_ratio: 0.0
