Oh-V1G0-Rally/Omnicar_Control_Ros2/(commit log)

2026-04-07 Implementazione seriale comunicazione
    [log_tune_batt-11.73_2023-04-25-19-03-44.csv, log_tune_batt-11.75_2023-04-25-18-58-34.csv, log_tune_batt-11.79_2023-04-25-18-47-34.csv, motors-ctrl-calibration.xlsx]
2026-04-08 lidar work
    [sdpo_driver_laser_2d.cfg]
2026-04-10 localization and lidar work
2026-04-15 problma con go to point
    [go_to_point_controller.yaml]
2026-04-16 control position on point work correctly
    [go_to_point_controller.yaml]
2026-04-22 separata logica e agigunto motion_state
    [go_to_point_controller.yaml]
2026-04-22 Aggiunta file per spline
    [Austin_centerline.csv, Austin_raceline.csv, BrandsHatch_centerline.csv, BrandsHatch_raceline.csv, Budapest_centerline.csv, Budapest_raceline.csv, Catalunya_centerline.csv, Catalunya_raceline.csv]
2026-04-23 pulizia e rimozione motion_state
    [go_to_point_controller.yaml, log_tune_batt-11.73_2023-04-25-19-03-44.csv, log_tune_batt-11.75_2023-04-25-18-58-34.csv, log_tune_batt-11.79_2023-04-25-18-47-34.csv, sdpo_driver_laser_2d.cfg, sdpo_ratf_ros_localization.cfg]
2026-04-23 path following su rect integrato
    [FEUP_rectangle.csv, go_to_point_controller.yaml, go_to_point_controller_odom_debug.yaml]
2026-04-27 introduzione linear control
    [Austin_centerline.csv, Austin_raceline.csv, BrandsHatch_centerline.csv, BrandsHatch_raceline.csv, Budapest_centerline.csv, Budapest_raceline.csv, Catalunya_centerline.csv, Catalunya_raceline.csv]
2026-04-28 Prime prove su path infinito
    [FEUP_rounded_rect_eight.csv, metrics.csv, path_follower_debug.csv, path_following_tests_summary.csv, path_reference.csv]
2026-04-29 nuovi test linear control
    [metrics.csv, path_follower_debug.csv, path_following_tests_summary.csv, path_reference.csv]
2026-05-11 Comfigurazione MPCC debug topics
    [nonlinear_mpcc_controller.yaml]
2026-05-11 prove con MPC recorded
    [metrics.csv, nonlinear_mpcc_controller.yaml, path_follower_debug.csv, path_following_tests_summary.csv, path_reference.csv]
2026-05-18 comparison, final chapter cap 6
    [comparison_metrics.csv]
2026-05-18 Modifiche per i file caricati
    [comparison_metrics.csv]
2026-05-19 prova per calcoli su confronti finali
    [ComparisonFinal.ods, path_following_tests_summary.csv]
2026-05-19 agginta prove
    [comparison_metrics.csv]
2026-07-02 Aggiunto materiale tesi
